RobertXii/860nm-Cateye-ECDL/PHYS335 Poster.pptx

Interference Filter External Cavity Diode Laser (ECDL) with a Cateye Configuration

Robert Xi¹, Geoffrey Zheng¹, Mangesh Bhattarai ², David DeMille¹, ²
1. James Franck Institute and Department of Physics, University of Chicago, IL 60637
2. Physics Division, Argonne National Laboratory, Argonne IL 640439

Goals and Motivation

ZOMBIES: Use ¹³⁷Ba¹⁹F to measure nuclear spin-dependent parity violation (NSD-PV) effect
Rotational Cooling (Pump population into single hyperfine level)
- Laser optically pumps ¹³⁷Ba¹⁹F molecules from X^2 Σ(υ=0;N^P =0^(+) ,1^(−) ,2^(+) ) to A^2 Π_(1/2) ( J^p =5/2^(+) ) , leaving X^2 Σ(υ=0;N^P =1^(−) ,J=3/2) hyperfine level unaddressed.
- Spontaneously decay back to ground state, accumulate population to X^2 Σ(υ=0;N^P =1^(−) ,J=3/2) .
- Simulation shows × 30 gain in the X^2 Σ(υ=0;N^P =1^(−) ,J=3/2) population.

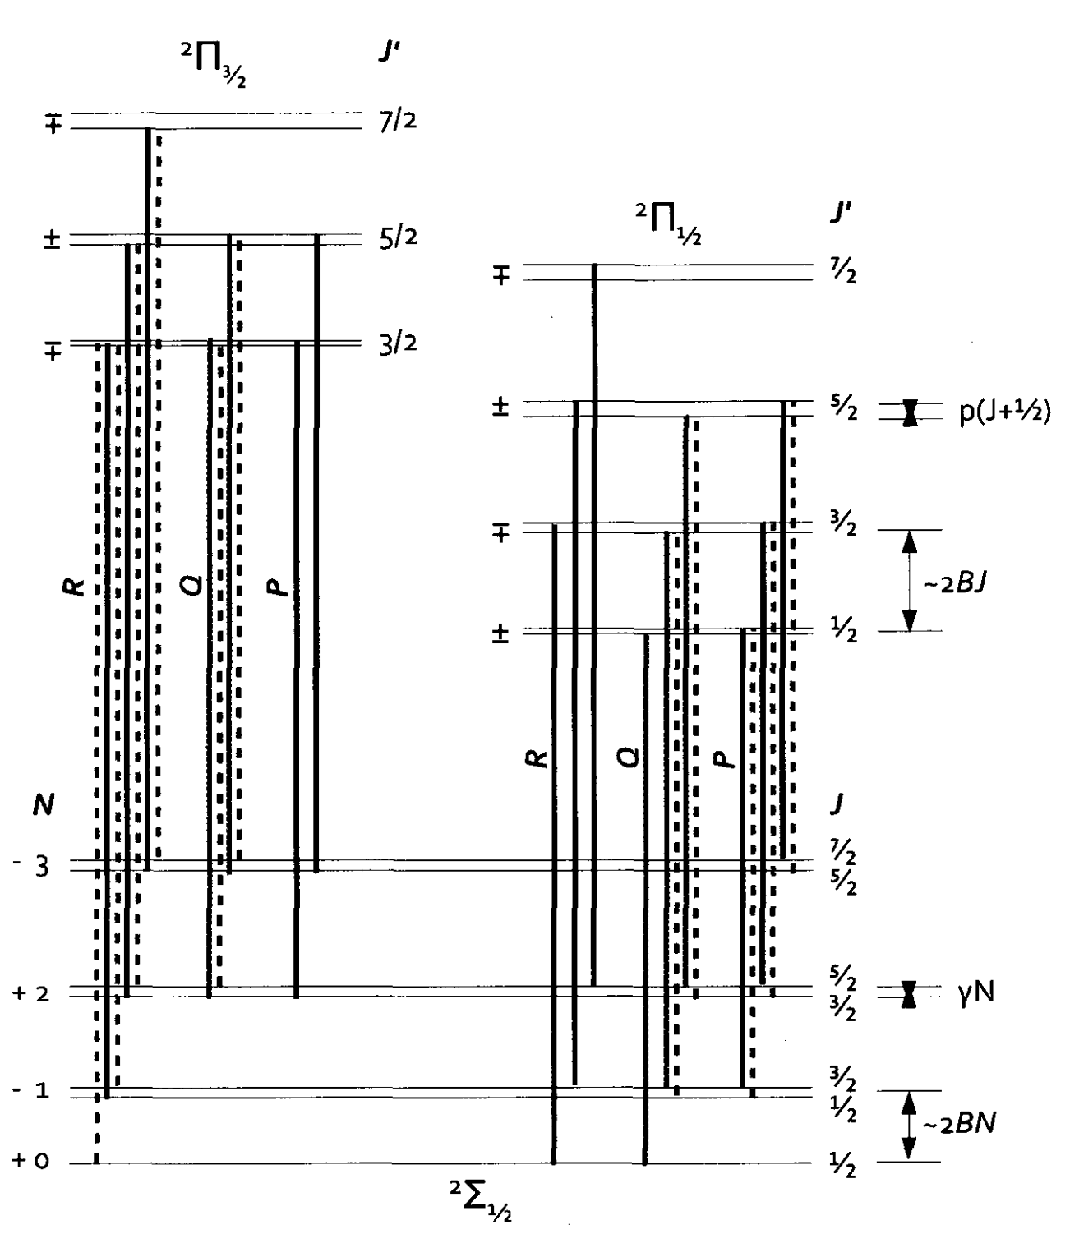
[picture p3: figure]

Laser Requirements
- Narrow linewidth (~100 kHz)
Similar Level of precision would mean measuring earth-moon distance with an uncertainty of 1mm!
- Wide tunability (~30GHz)
- High stability.
- Power output (~100mW)
- Ease of use, small size, reproducible.

The laser will oscillate at the frequency for which the product of these factors is greatest.

Design

Design Principles
- λ/2 waveplate + PBS allows tuning the feedback intensity
- Self-aligning Cateye reflection geometry, mechanically robust
- Frequency coarse tuning by changing diode temperature (100GHz)
- Moderate tuning by changing laser diode current (10GHz)
- Fine tuning by changing piezo voltage (<1GHz)

CAD
- Precise pitch and roll control of Cateye configuration allows finer tuning of alignment
- 1-inch-thick acrylic lid ensures system’s thermal stabilization
- Slotted PBS and λ/2 waveplate brass spacer allows adjustment of their position
- Brass base provides good thermal conductivity

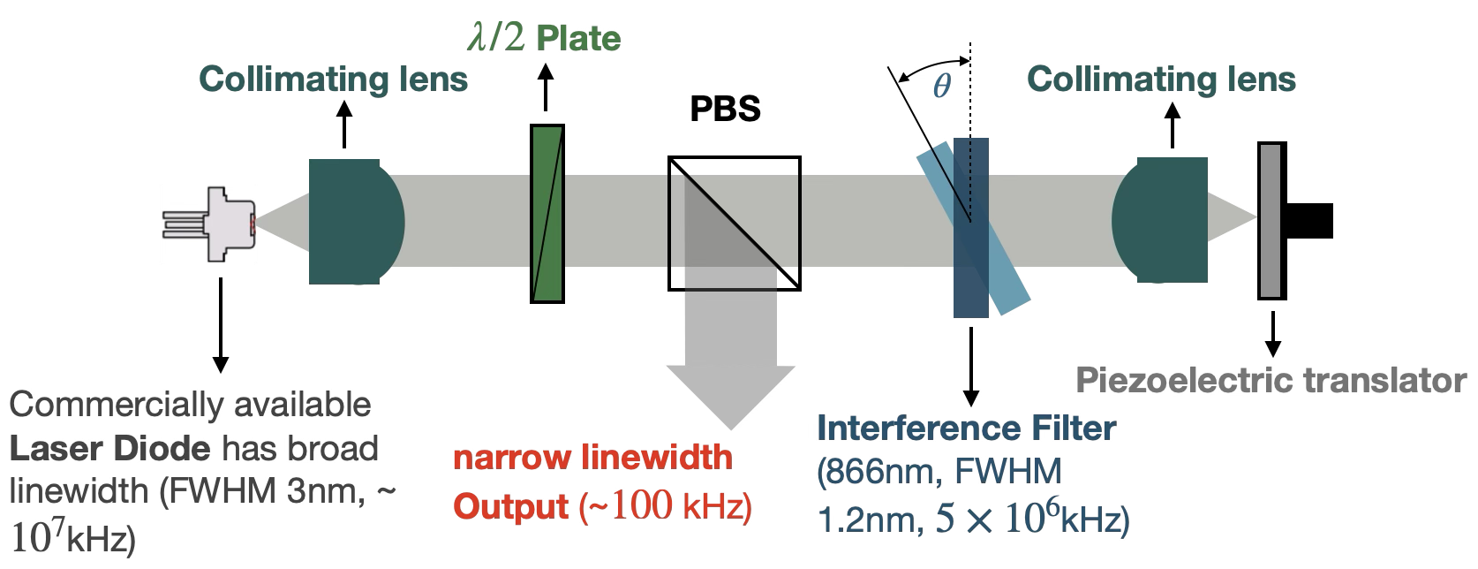
[picture p4: figure]
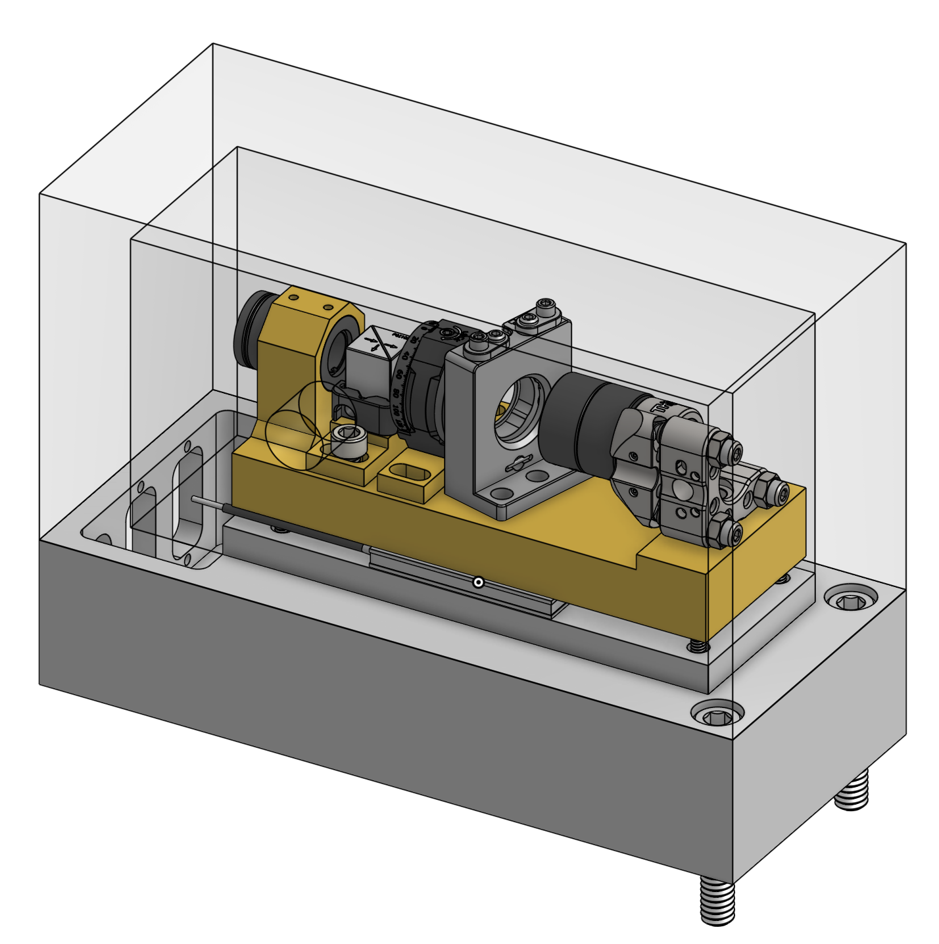
[picture p5: figure]
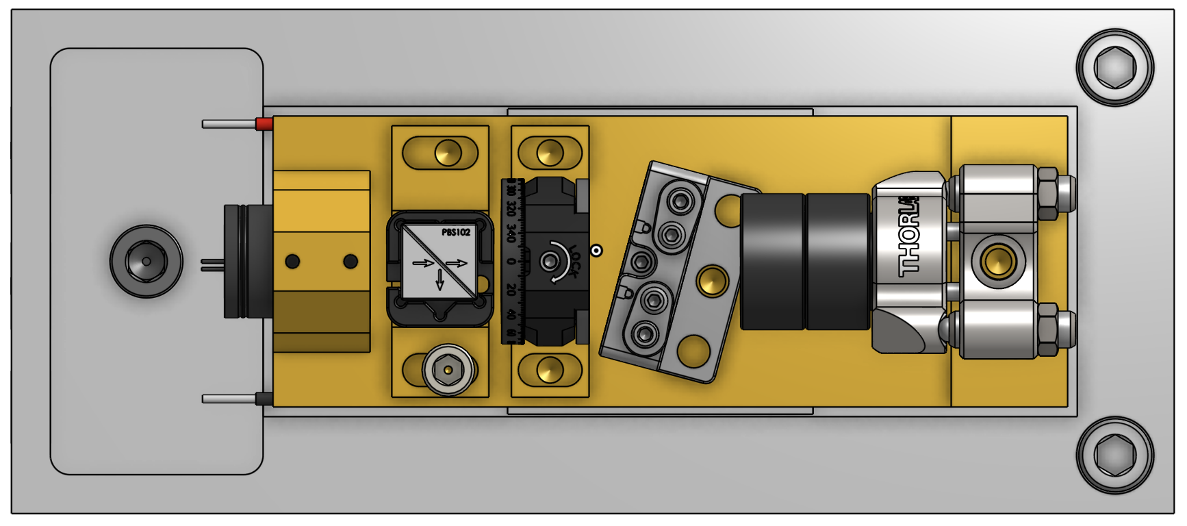
[picture p6: figure]
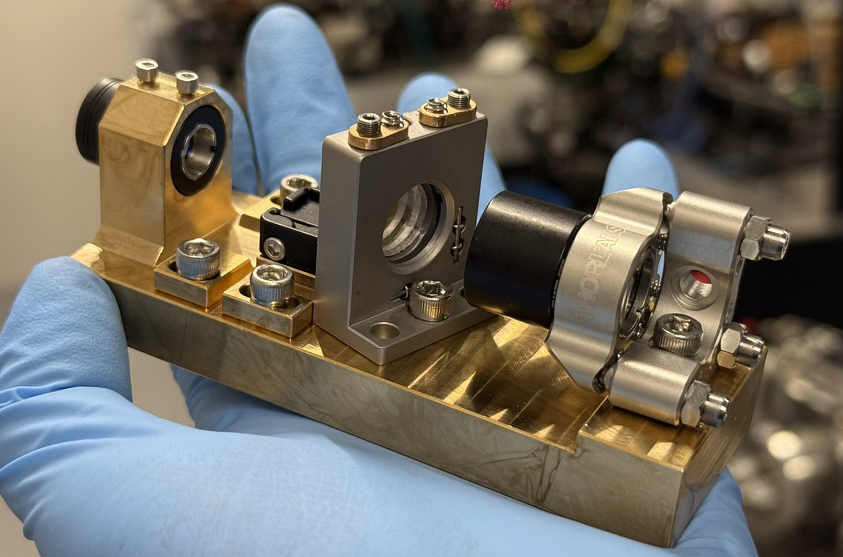
[picture p7: figure]

Theoretical Basis

An optical resonator consisting of two parallel, highly reflective mirrors that reflect light back and forth, forming standing waves at specific resonant frequencies.

where F is the coefficient of finesse for the cavity. δ(υ)=2πnLυ/c , L is the cavity length, and n is the refractive index of the cavity medium.

Fabry-Perot Cavity

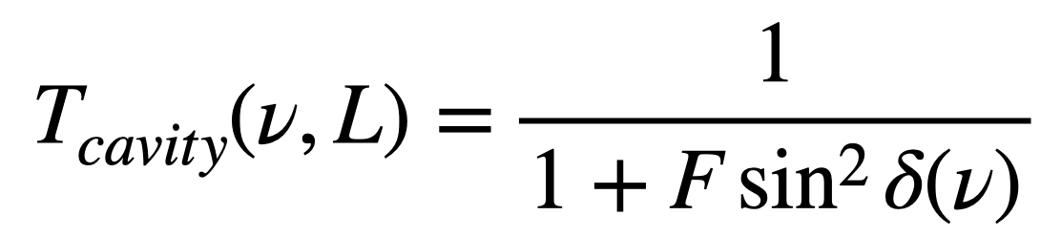
[picture p8: figure]
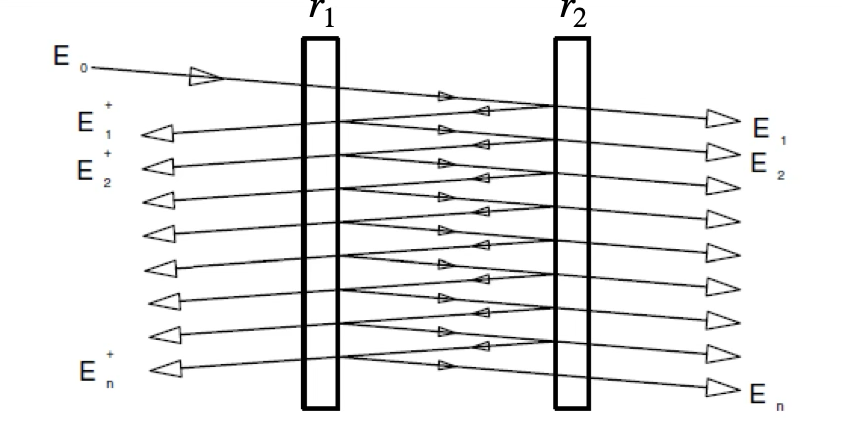
[picture p9: figure]
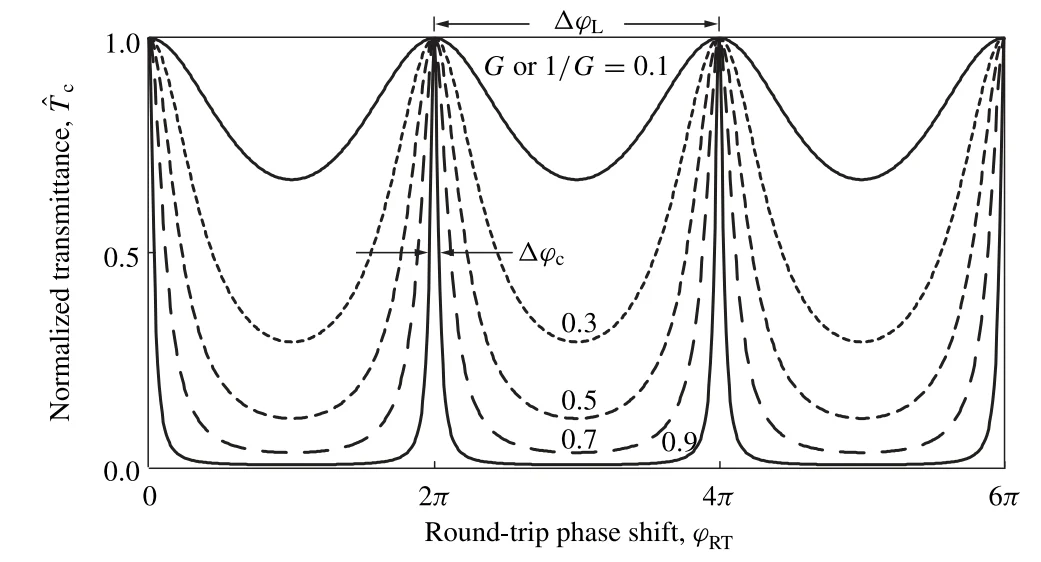
[picture p10: figure]

Ultra-narrow Bandpass Interference Filter

An optical filter that transmits light at specific wavelength (~1nm) using interference from multiple thin layers.
The transmission window wavelength
shift with incident angle θ :

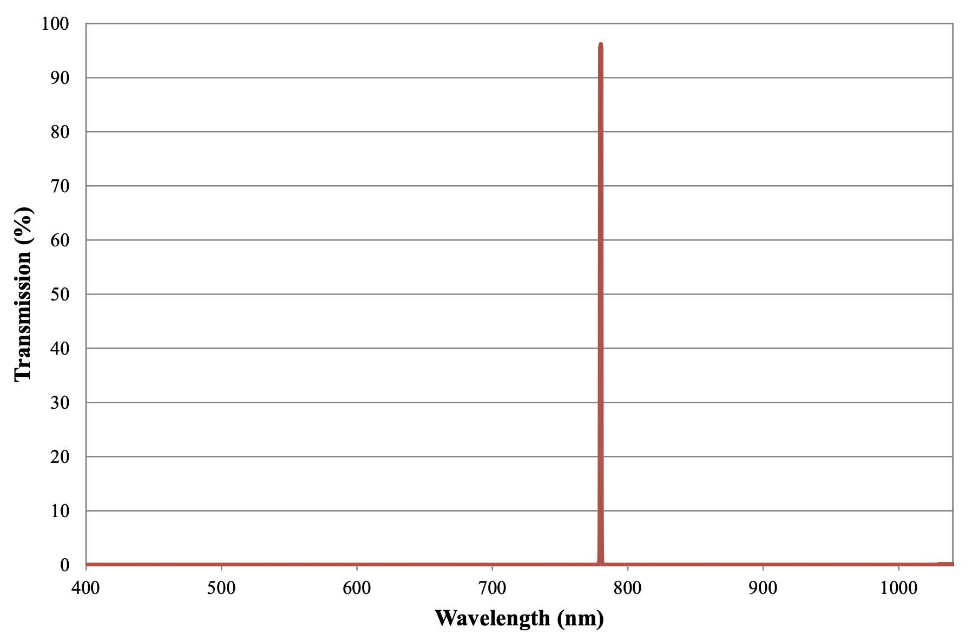
[picture p11: figure]
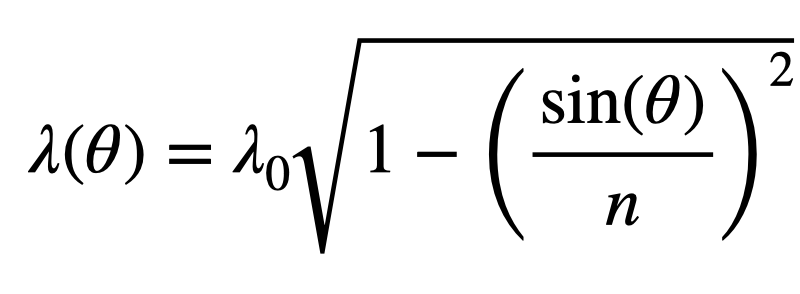
[picture p12: figure]

A lens-mirror combination (Cateye) and a lens-source aligned facing each other, with the mirror/light source at the focal plane/point of the lens.

Cateye Retroreflector

Reflects any incoming collimated beam back to the source, regardless of their relative angle (provided the beam strikes the Cateye).

Advantages:
- Easy to align
- Mechanically stable

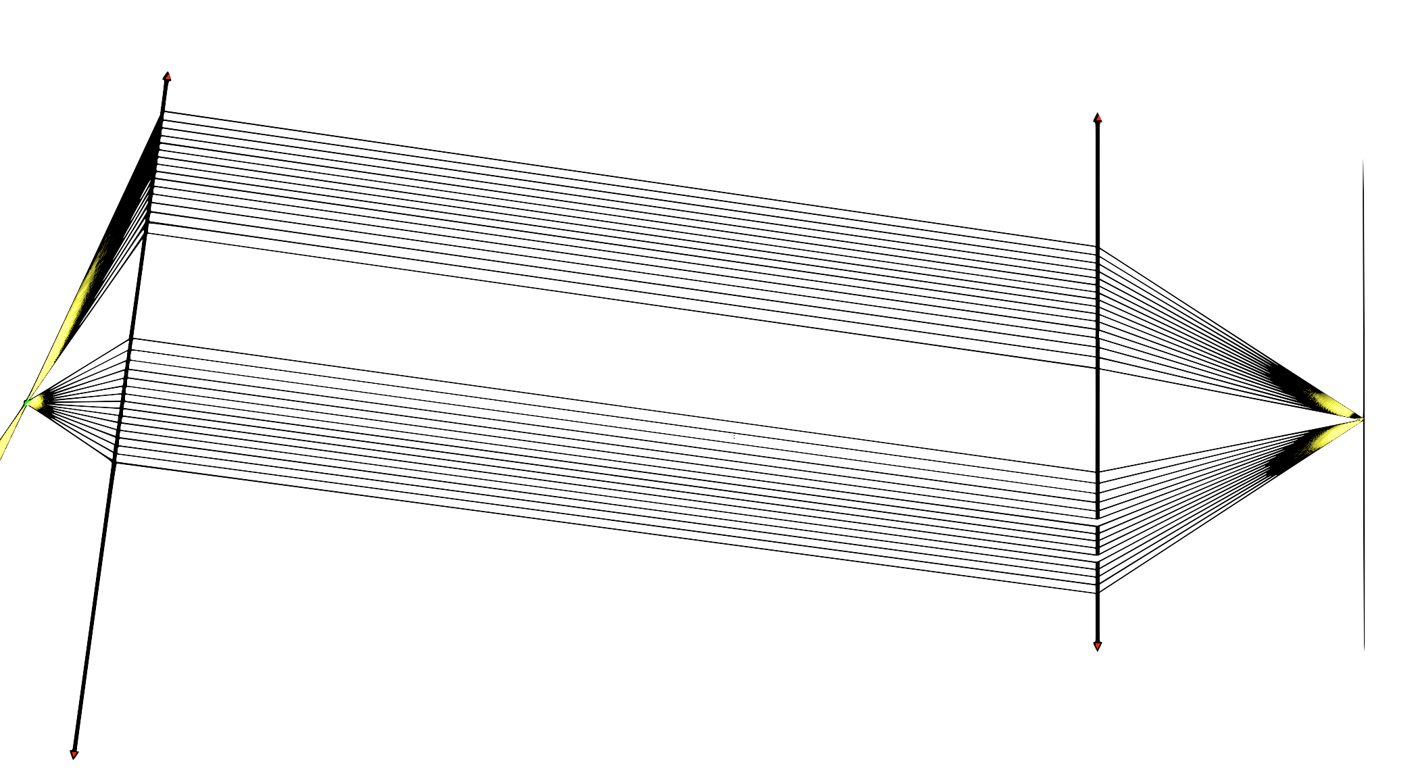
[picture p13: figure]

Laser Output Frequency

The output frequency ν of an ECDL dependents on a combination of frequency-dependent gain and loss factors. The product of these factors gives the total transmission function:

Result

Diode Current Scan, Piezo Voltage Scan, and Feedforward
- Without feedforward (scanning current and voltage simultaneously at certain ratio), scanning current gives discrete steps, scanning voltage gives ~1.5GHz MHFTR, consistent with simulation
- With feedforward, MHFTR ~12GHz

Outlook

Transfer Cavity for frequency stabilization and frequency shifting laser

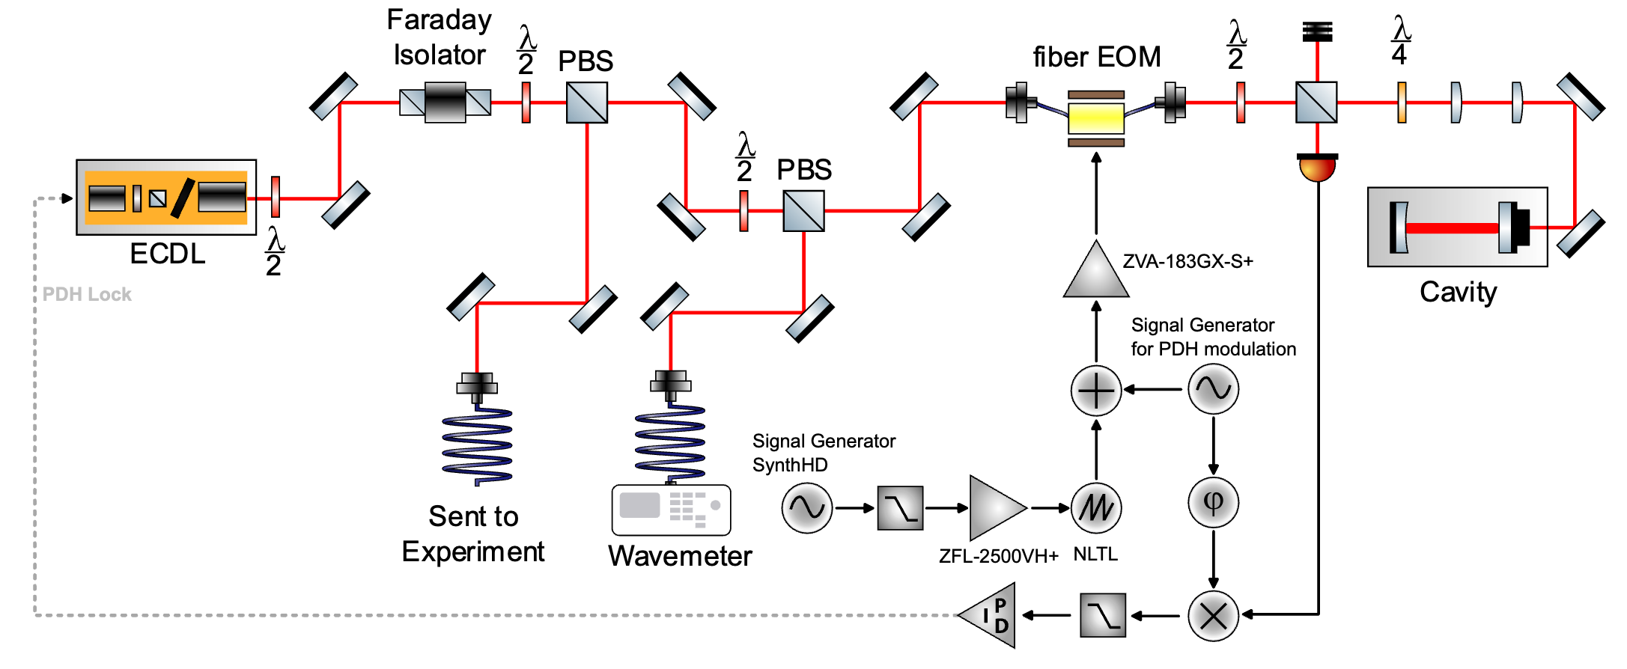
[picture p14: figure]
