RobertXii/860nm-Cateye-ECDL/ECDL Poster.pdf

# Interference Filter External Cavity Diode Laser (ECDL) with a Cateye Configuration

## Goals and Motivation

## Design

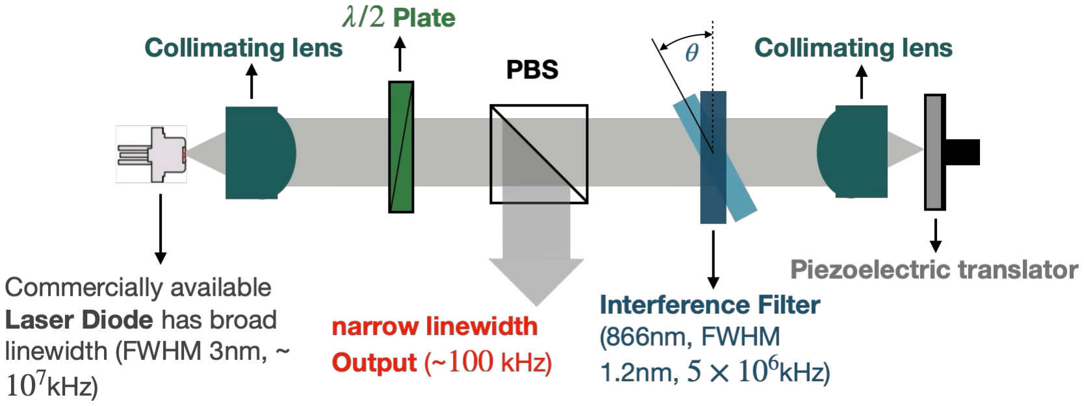
[picture p15: figure]

## Theoretical Basis

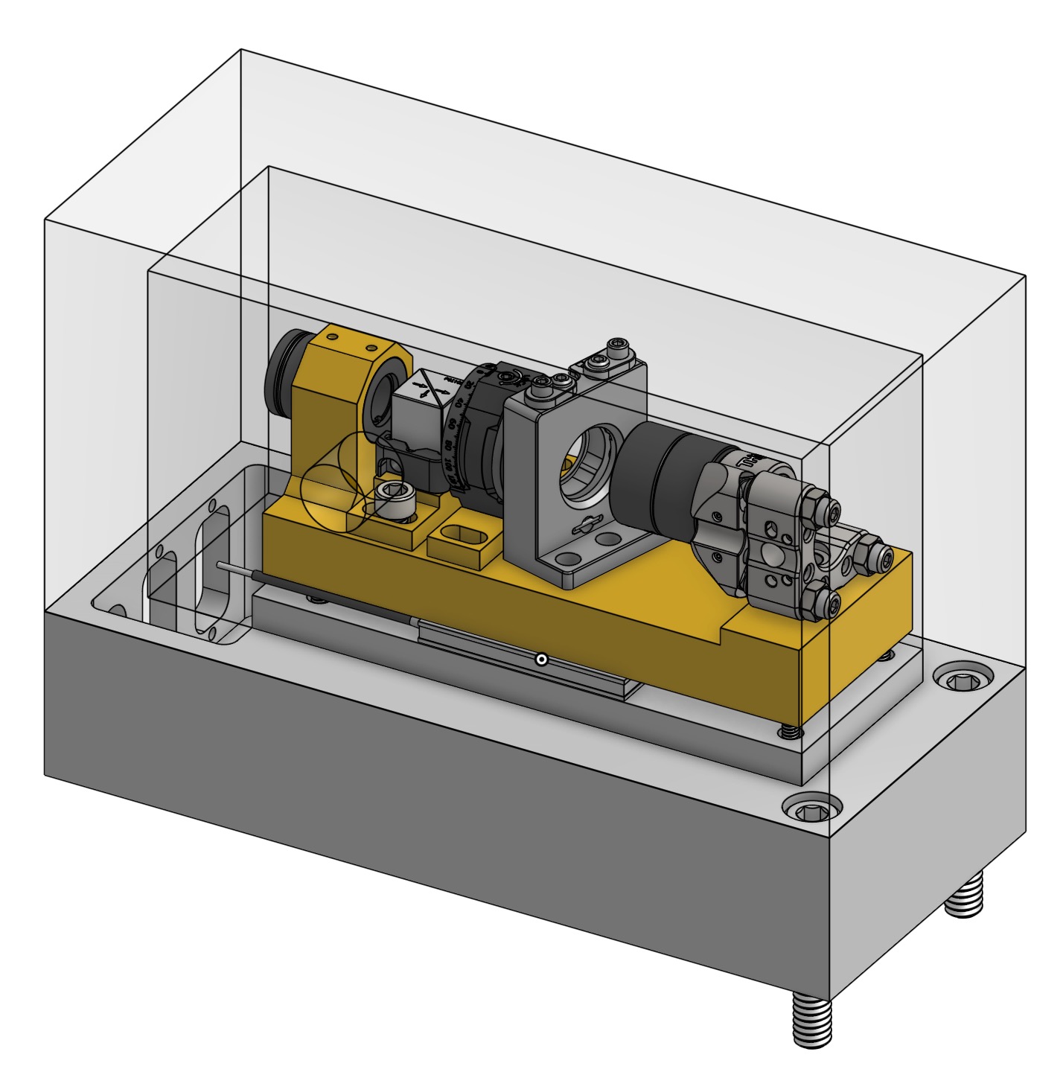
[picture p16: figure]
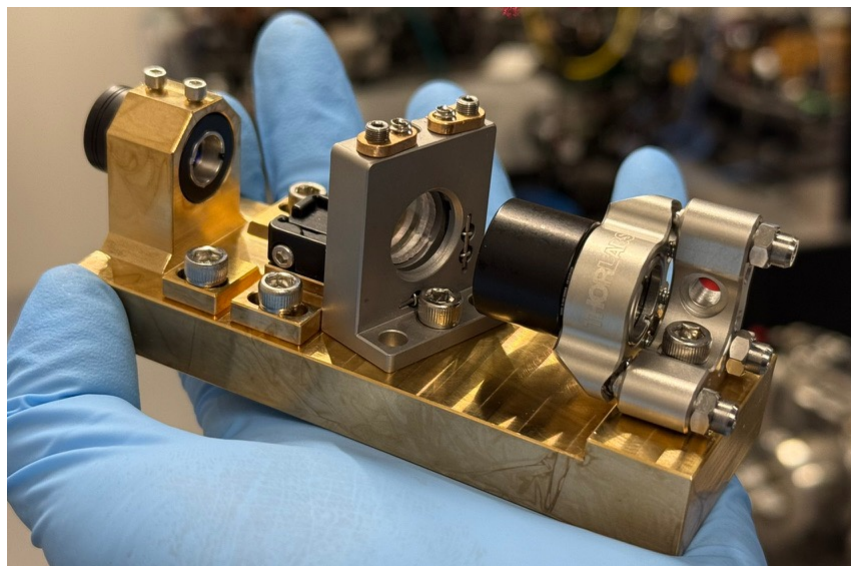
[picture p17: figure]
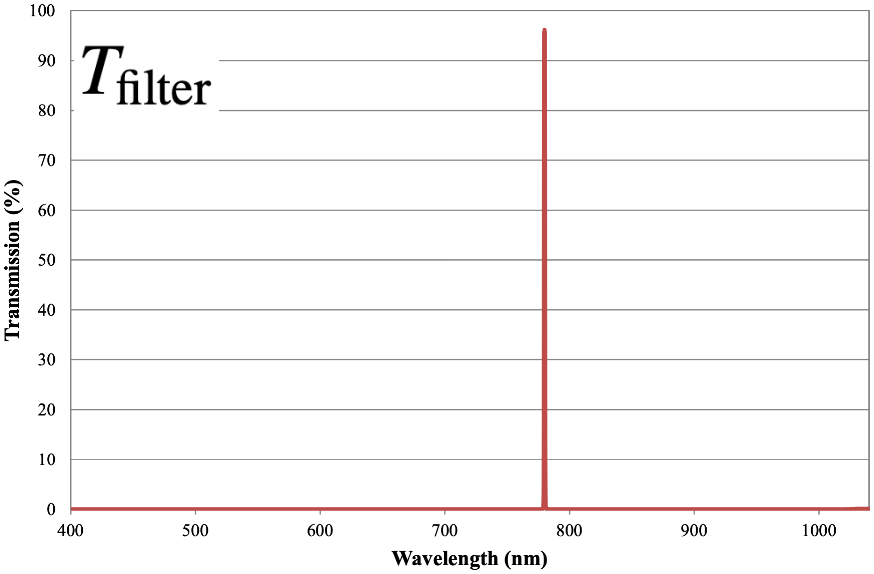
[picture p18: figure]

## Result

Robert Xi¹, Geoffrey Zheng¹, Mangesh Bhattarai ², David DeMille¹, 2
1. James Franck Institute and Department of Physics, University of Chicago, IL 60637
2. Physics Division, Argonne National Laboratory, Argonne IL 640439

## ZOMBIES: Use ¹³⁷Ba¹⁹F to measure nuclear spin-dependent parity violation (NSD-PV) effect

Rotational Cooling (Pump population into single hyperfine level)
- Laser optically pumps ¹³⁷Ba¹⁹F molecules from X!Σ(υ = 0; N" = 0#

, 1$, 2#) to A!Π%/!( J' = 5/2#), leaving X!Σ(υ = 0; N" = 1$,J = 3/2) hyperfine level unaddressed.
- Spontaneously decay back to ground state, accumulate population to X!Σ(υ = 0; N" = 1$,J = 3/2).
- Simulation shows ×30 gain in the X!Σ(υ = 0; N" = 1$,J = 3/
2) population.

Laser Requirements
- Narrow linewidth (~100 kHz)
Similar Level of precision would mean measuring earth-moon
distance with an uncertainty of 1mm!
- Wide tunability (~30GHz)
- High stability.
- Power output (~100mW)
- Ease of use, small size, reproducible.

## Fabry-Perot Cavity

An optical resonator consisting of two parallel, highly reflective mirrors that reflect light back and forth, forming standing waves at specific resonant frequencies.

where F is the coefficient of finesse for the cavity. δ υ = 2πnLυ/c, L is the cavity length, and n is the refractive index of the cavity medium.

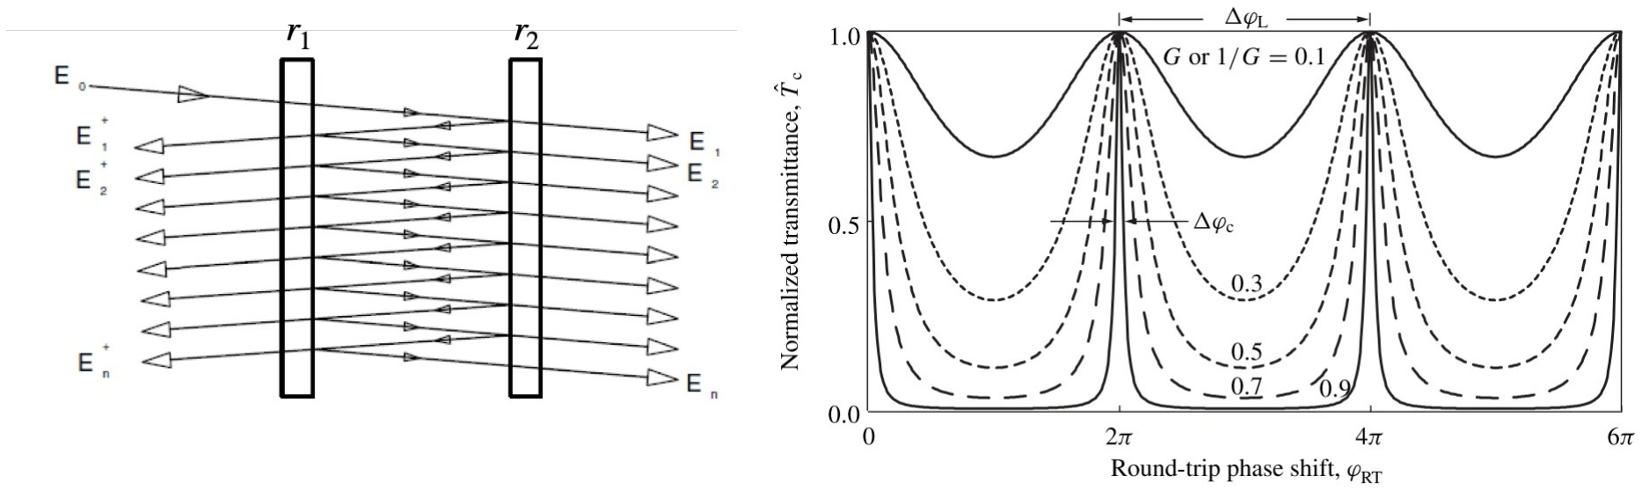
[picture p19: figure]
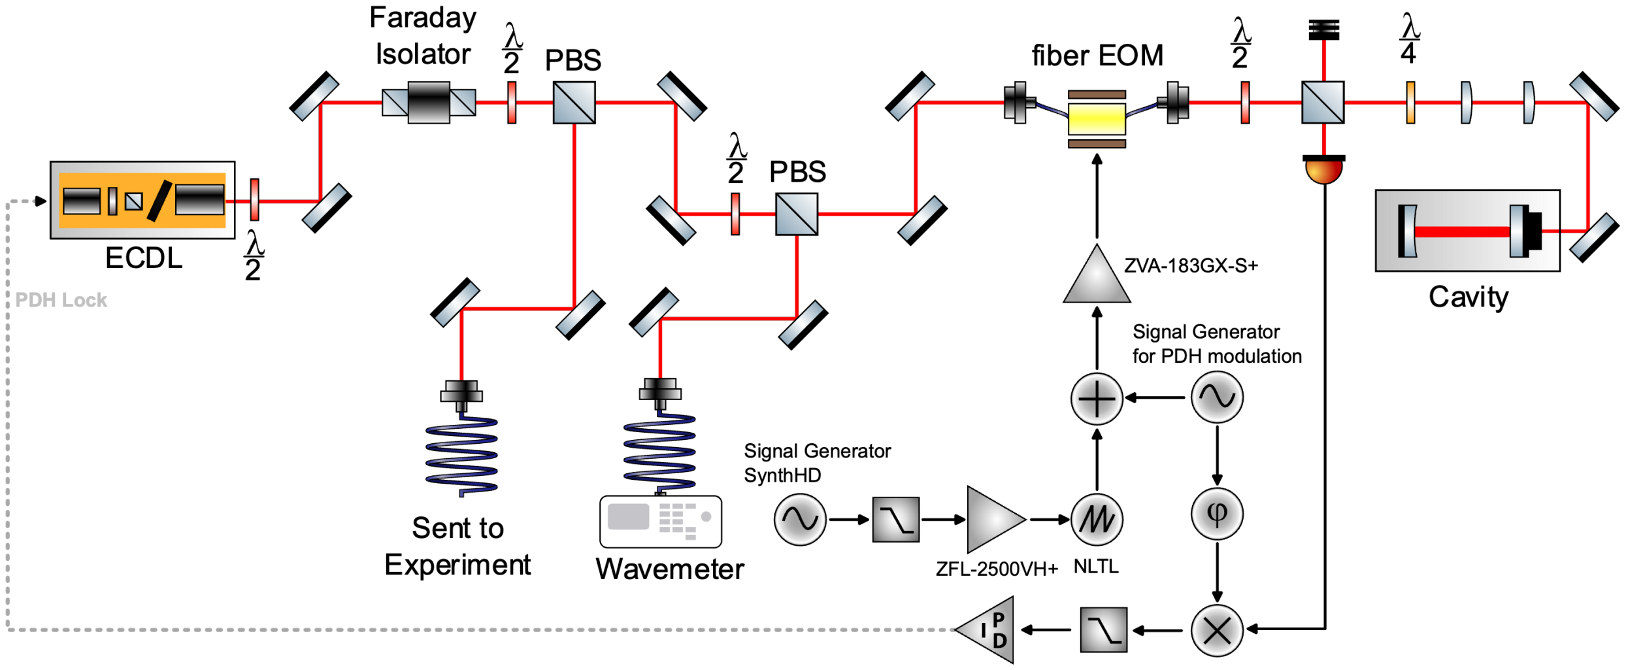
[picture p20: figure]

## Laser Output Frequency

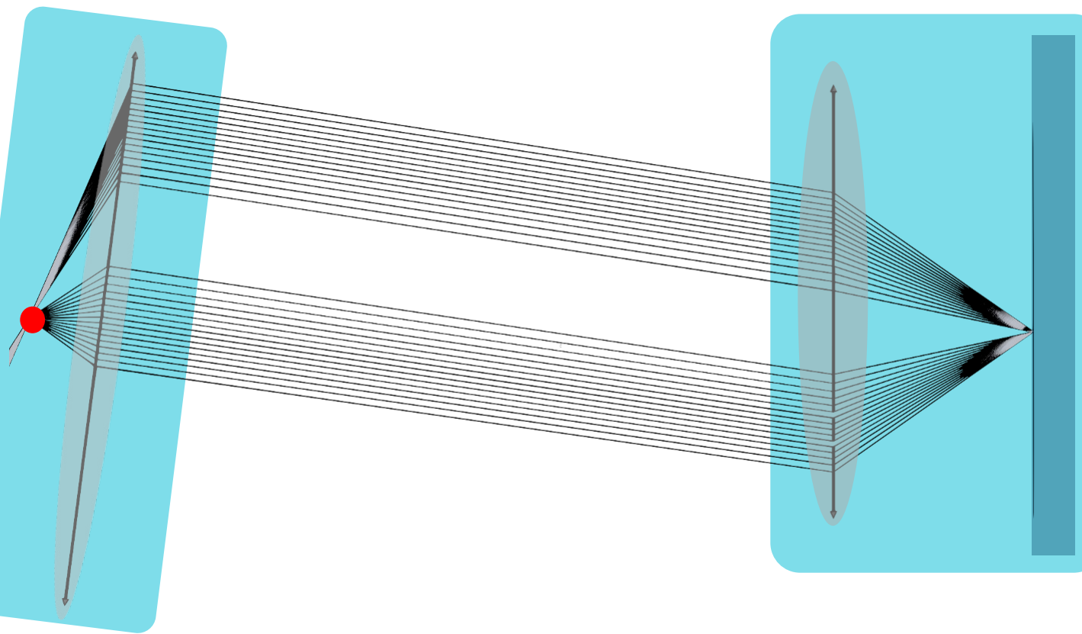
[picture p21: figure]

The output frequency ν of an ECDL dependents on a combination of frequency-dependent gain and loss factors. The product of these factors gives the total transmission function:

## Ultra-narrow Bandpass Interference Filter

An optical filter that transmits light at specific wavelength (~1nm) using interference from multiple thin layers.

The transmission window wavelength
shift with incident angle θ:

Design Principles
- λ/2 waveplate + PBS allows tuning the feedback intensity
- Self-aligning Cateye reflection geometry, mechanically robust
- Frequency coarse tuning by changing diode temperature (100GHz)
- Moderate tuning by changing laser diode current (10GHz)
- Fine tuning by changing piezo voltage (<1GHz)

CAD
- Precise pitch and roll control of Cateye configuration allows finer tuning of alignment
- 1-inch-thick acrylic lid ensures system’s thermal stabilization
- Slotted PBS and λ/2 waveplate brass spacer allows adjustment of their position
- Brass base provides good thermal conductivity

The laser will oscillate at the frequency for which the product of these factors is greatest.

350.5 | 350 | 349.5 | 349 | 348.5 | 348 | 347.5 | 347
Frequency (THz)

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
Transmission

Total Transmission
maximum
Gain Profile
Filter Transmission
Diode Cavity Transmission
348.95 | 348.9 | 348.85 | 348.8 | 348.75 | 348.7 | 348.65 | 348.6 | 348.55 | 348.5
Frequency (THz)

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
Transmission

859.71000 nm
348.71347 THz Total Transmission maximum
Gain Profile
Filter Transmission
Diode Cavity Transmission

Diode Current Scan, Piezo Voltage Scan, and Feedforward
- Without feedforward (scanning current and voltage simultaneously at certain ratio), scanning current gives discrete steps, scanning voltage gives ~1.5GHz MHFTR, consistent with simulation
- With feedforward, MHFTR ~12GHz

## Outlook

Transfer Cavity for frequency stabilization and frequency shifting laser

## Cateye Retroreflector

A lens-mirror combination (Cateye) and a lens-source aligned facing each other, with the mirror/light source at the focal plane/point of the lens.

Advantages:
- Easy to align
- Mechanically stable

Reflects any incoming collimated beam back to the source,
regardless of their relative angle (provided the beam strikes the Cateye).
