RobertXii/860nm-Cateye-ECDL/Circuits/Feedforward Circuit/Feedforward Circuit Diagram.pdf

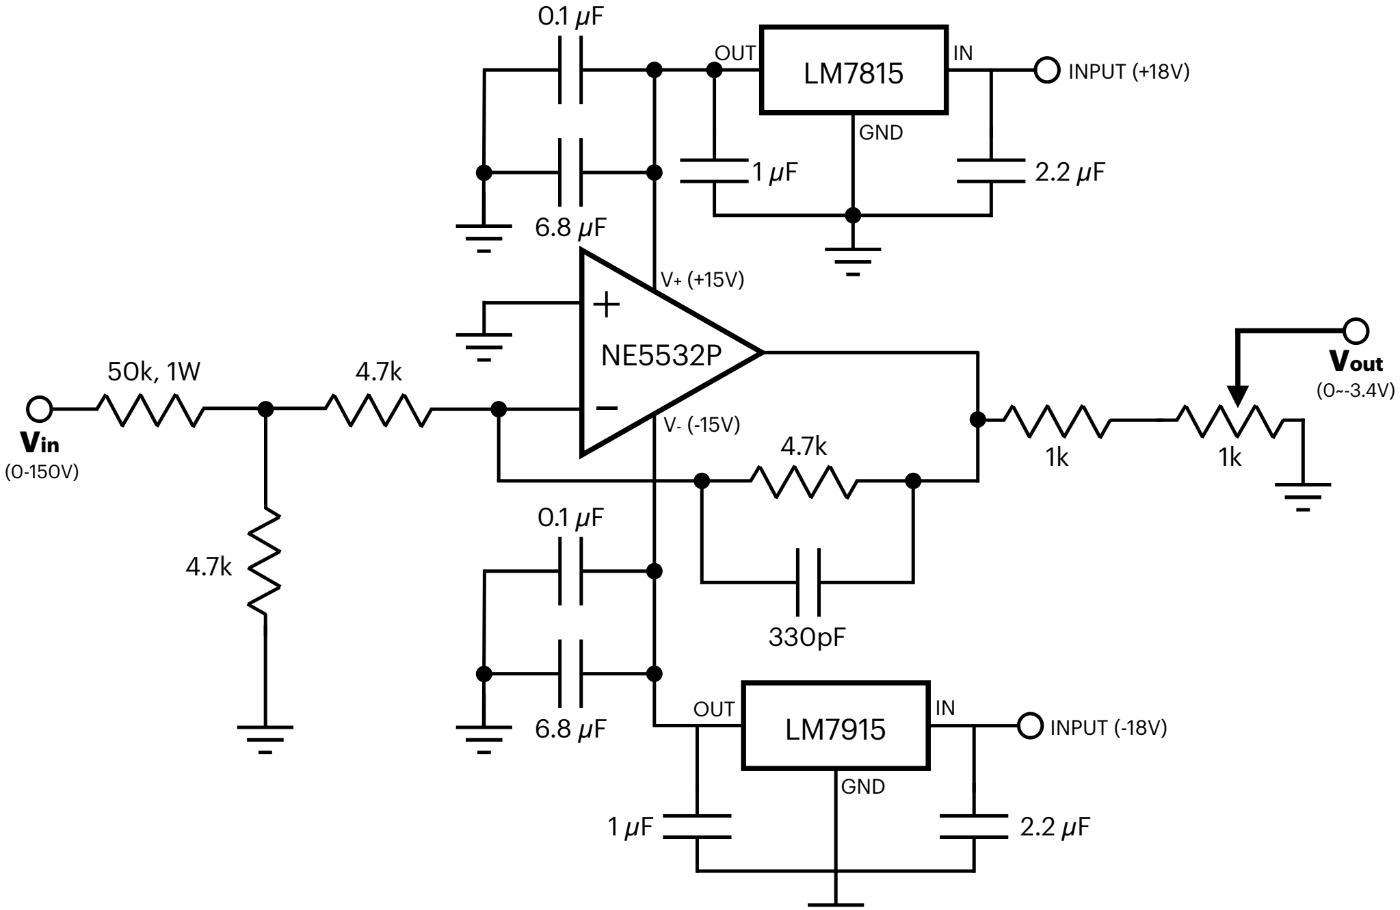
[picture p22: figure]
GND; OUT; INPUT (+18V); INPUT (-18V); Vin; Vout
