RobertXii/860nm-Cateye-ECDL/Circuits/original_diode_protection_circuit_bode_plot.pdf

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

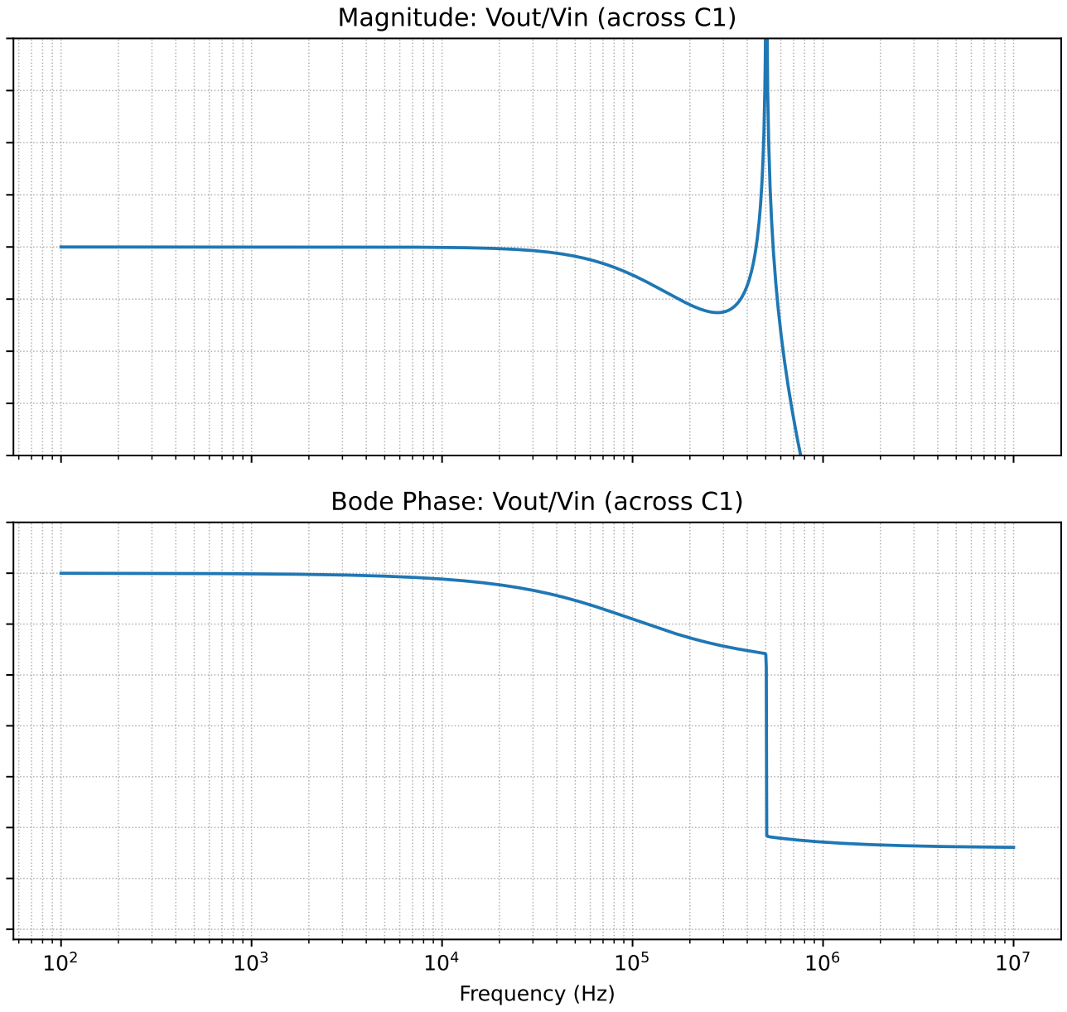
[picture p23: figure]
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
