RobertXii/860nm-Cateye-ECDL/CAD/New ECDL Design/IMG_3966.jpeg

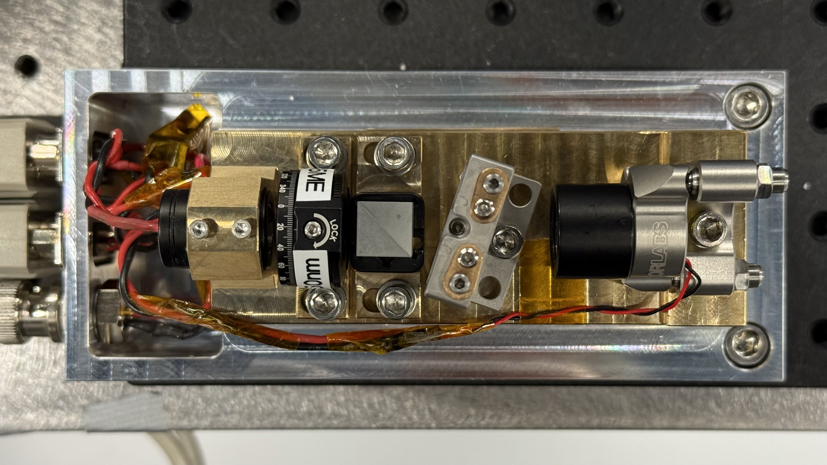
CAD/New ECDL Design/IMG_3966.jpeg
