RobertXii/860nm-Cateye-ECDL/CAD/New ECDL Design/Screenshot 2025-03-17 at 7.20.56 PM.png

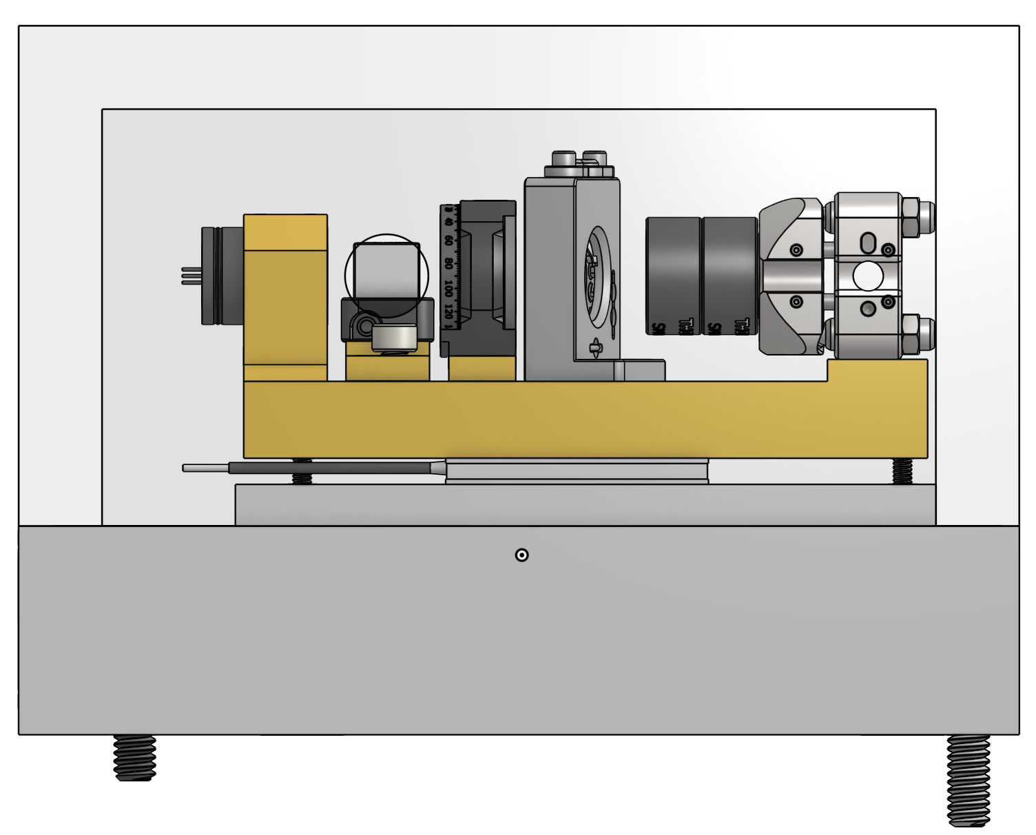
CAD/New ECDL Design/Screenshot 2025-03-17 at 7.20.56 PM.png
