RobertXii/860nm-Cateye-ECDL/CAD/New ECDL Design/Screenshot 2025-03-17 at 7.23.22 PM.png

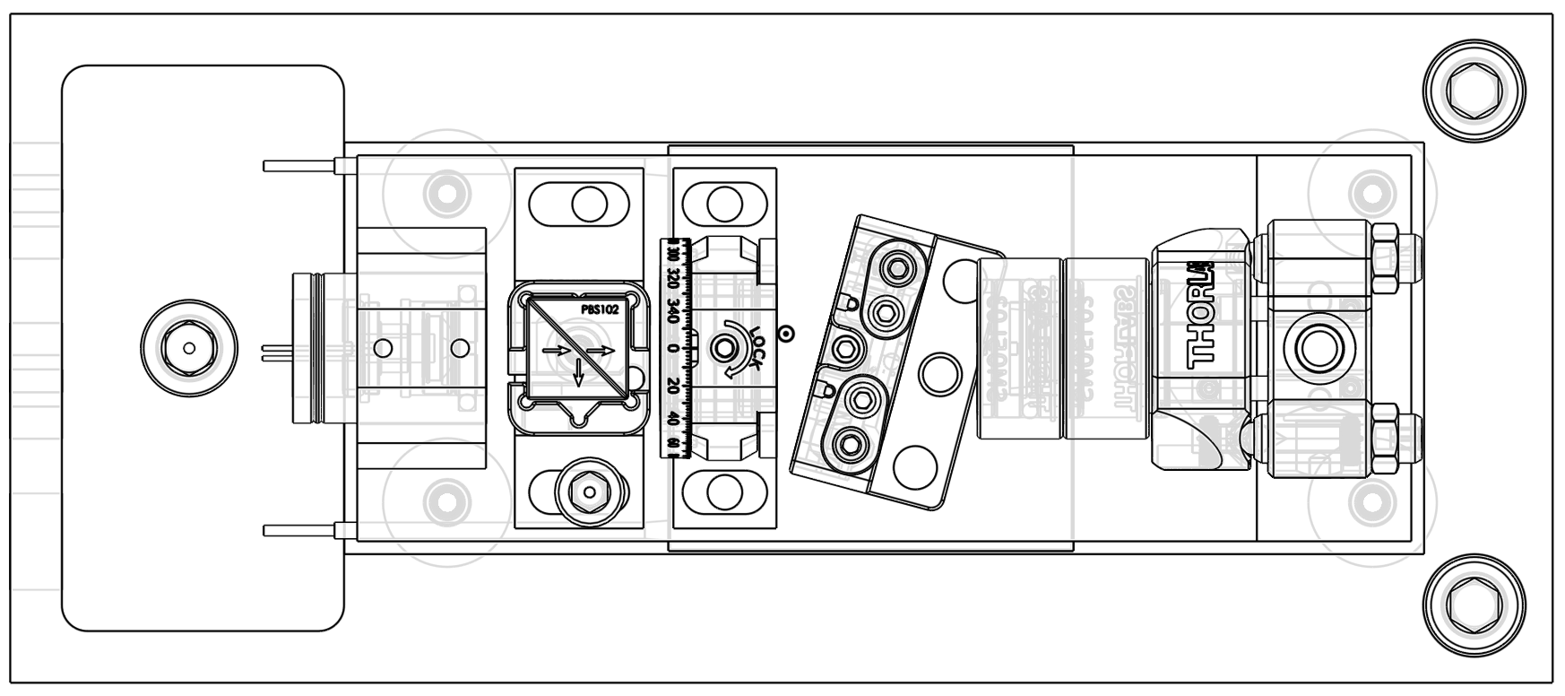
CAD/New ECDL Design/Screenshot 2025-03-17 at 7.23.22 PM.png
