RobertXii/860nm-Cateye-ECDL/Circuits/Feedforward Circuit/IMG_4039.jpeg

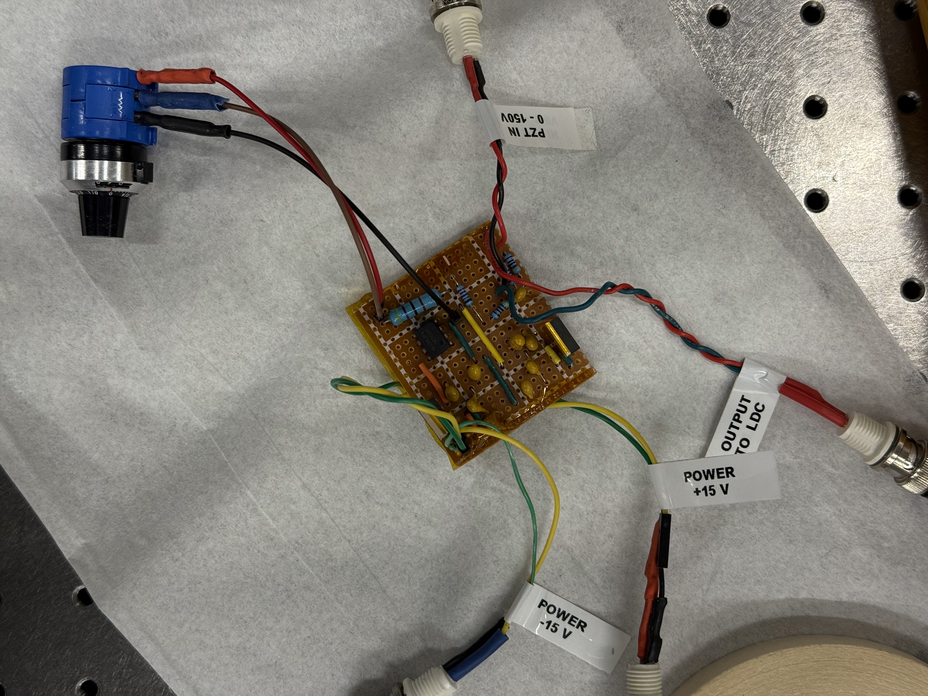
Circuits/Feedforward Circuit/IMG_4039.jpeg
