RobertXii/860nm-Cateye-ECDL/Circuits/Feedforward Circuit/IMG_4040.jpeg

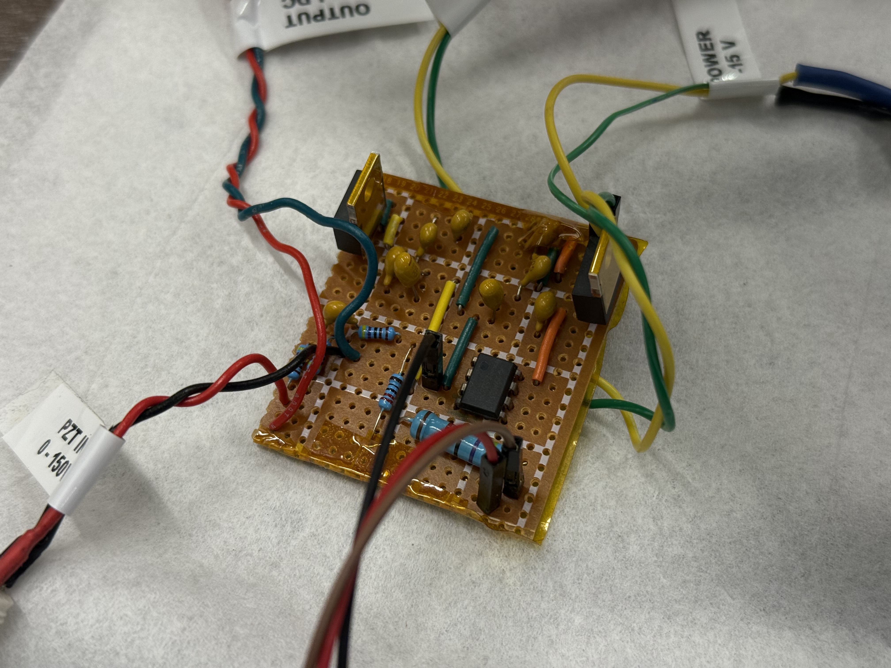
Circuits/Feedforward Circuit/IMG_4040.jpeg
