RobertXii/860nm-Cateye-ECDL/Circuits/Feedforward Circuit/IMG_4096.jpeg

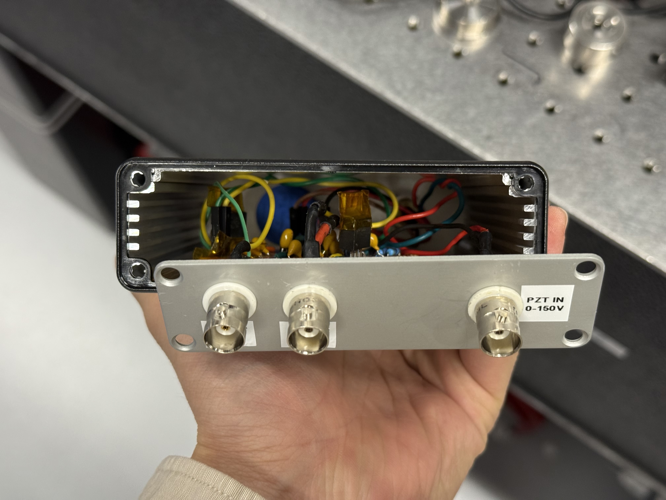
Circuits/Feedforward Circuit/IMG_4096.jpeg
