RobertXii/860nm-Cateye-ECDL/Circuits/Piezo Protection Circuit/Piezo Protection Circuit Diagram new.png

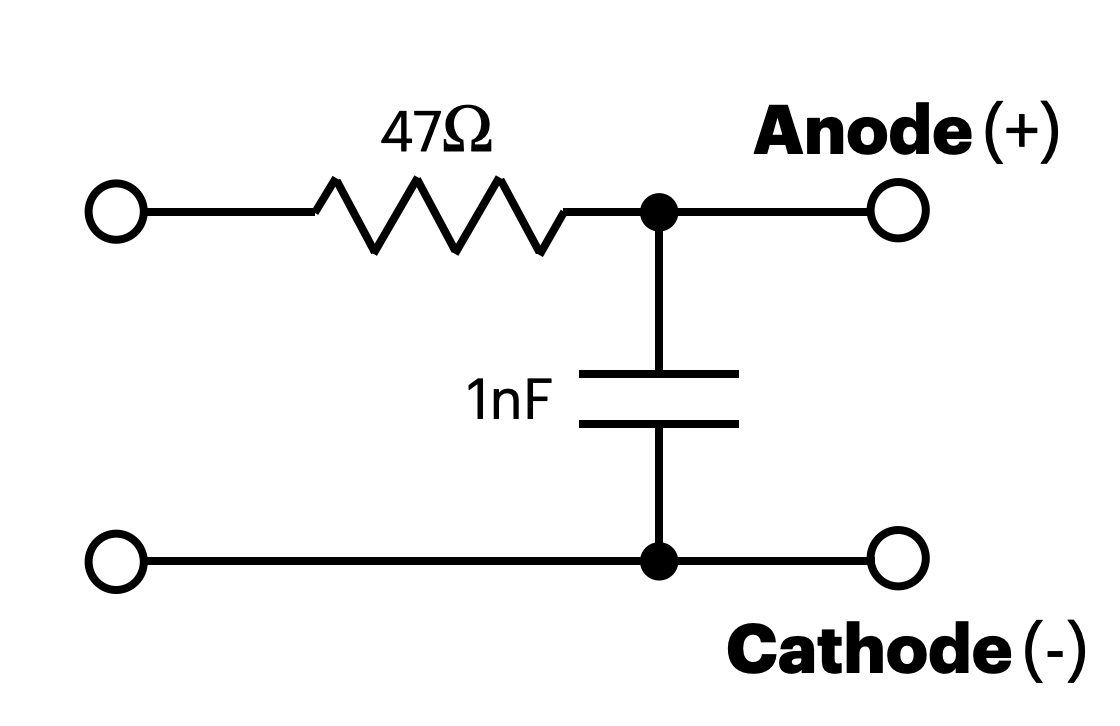
Circuits/Piezo Protection Circuit/Piezo Protection Circuit Diagram new.png
