RobertXii/860nm-Cateye-ECDL/Circuits/Piezo Protection Circuit/Piezo Protection Circuit Diagram.png

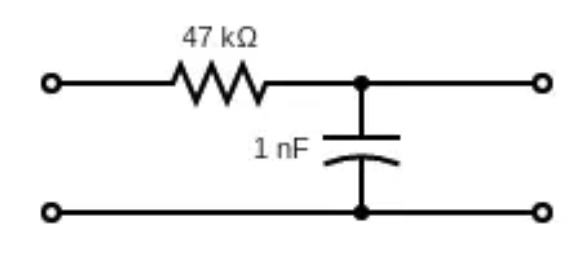
Circuits/Piezo Protection Circuit/Piezo Protection Circuit Diagram.png
