RobertXii/860nm-Cateye-ECDL/Circuits/Piezo Protection Circuit/Piezo Protection Circuit.jpeg

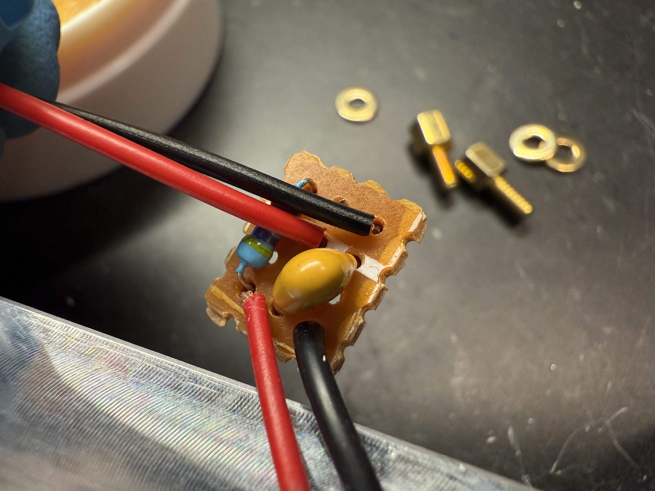
Circuits/Piezo Protection Circuit/Piezo Protection Circuit.jpeg
