RobertXii/860nm-Cateye-ECDL/export.png

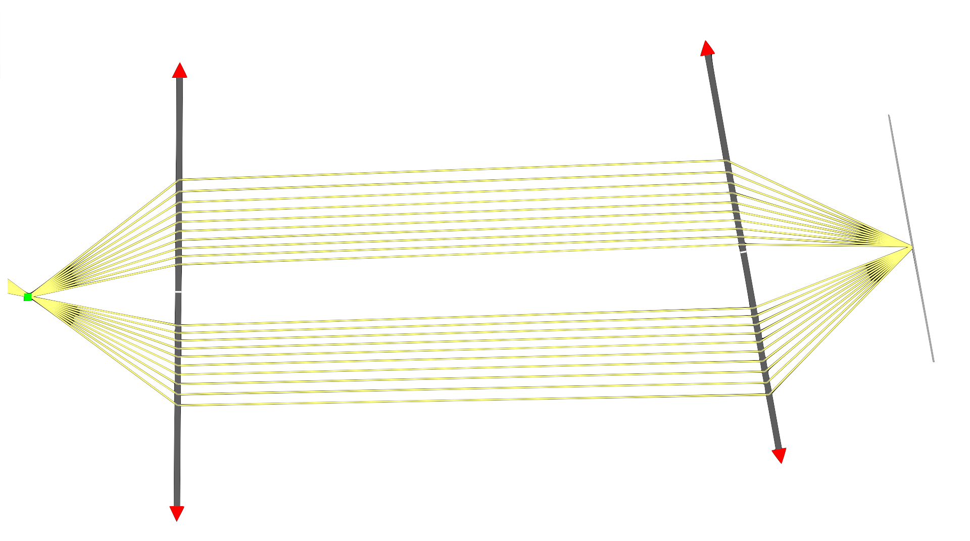
export.png
