RobertXii/860nm-Cateye-ECDL/CAD/From Michelle/figure2.SLDASM

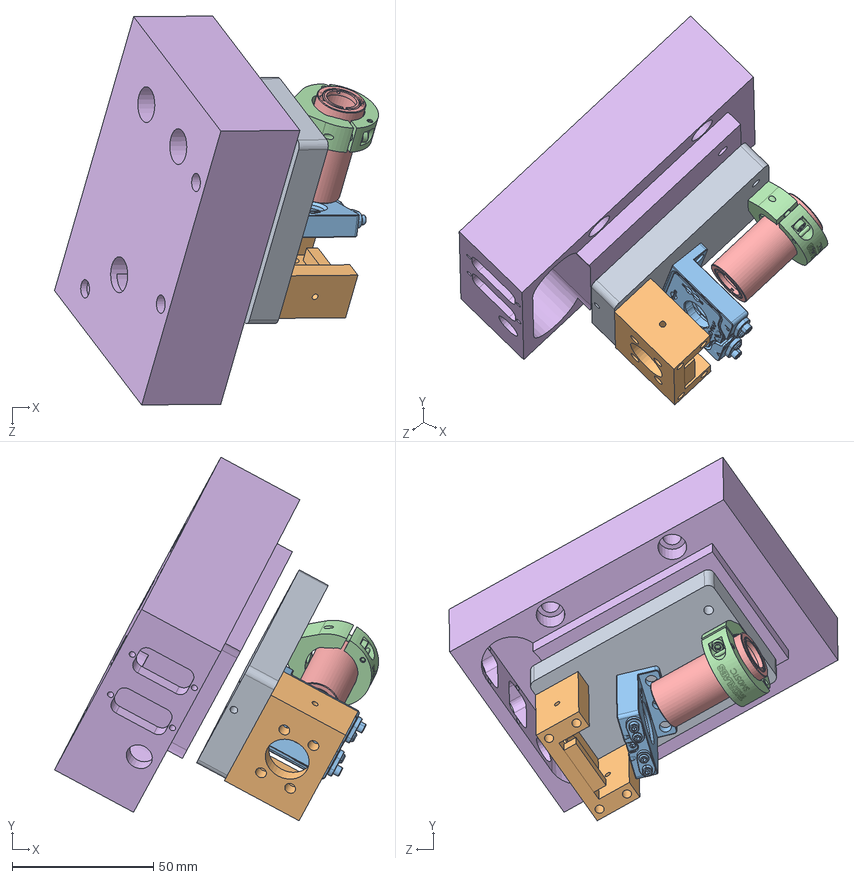
[picture p35: CAD file, 2025-04-15]
CAD/From Michelle/figure2.SLDASM
114.6 x 128.6 x 137.6 mm
diode base
Fixed Diode Housing Holder
Newport-hvm-05r
SM05TC-Solidworks
SM05M15-Solidworks
Laser Base
