RobertXii/860nm-Cateye-ECDL/CAD/From Michelle/diode base.STEP

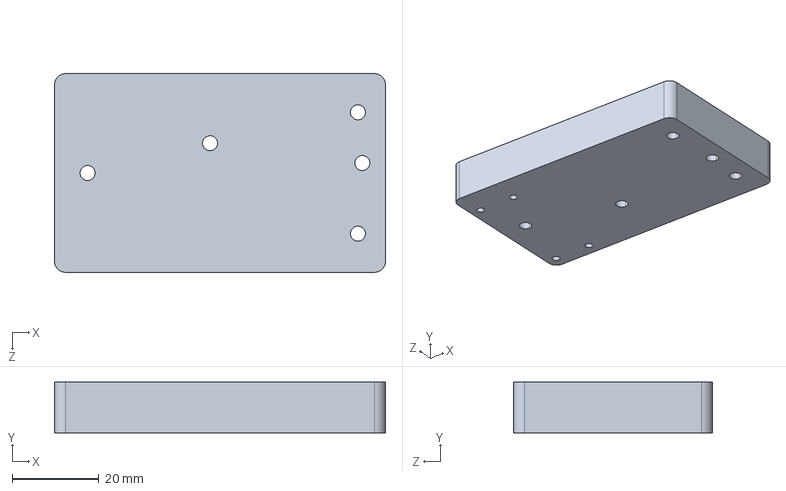
[picture p36: CAD file, 2025-04-15]
CAD/From Michelle/diode base.STEP
76.2 x 11.7 x 45.7 mm
