RobertXii/860nm-Cateye-ECDL/CAD/New ECDL Design/Brass base.step

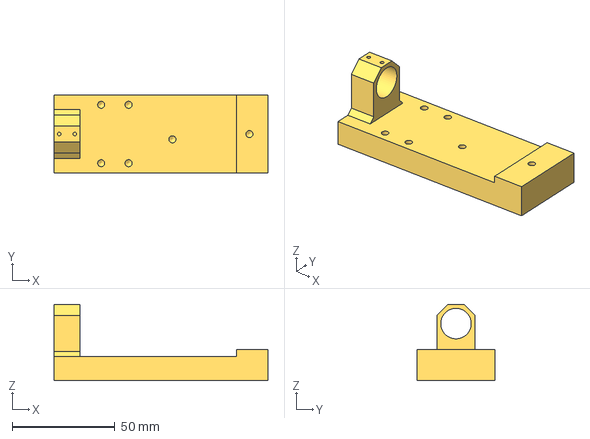
[picture p37: CAD file, 2025-05-07]
CAD/New ECDL Design/Brass base.step
104.1 x 38.1 x 37.1 mm
