RobertXii/860nm-Cateye-ECDL/CAD/parts/SM05L05-Step.step

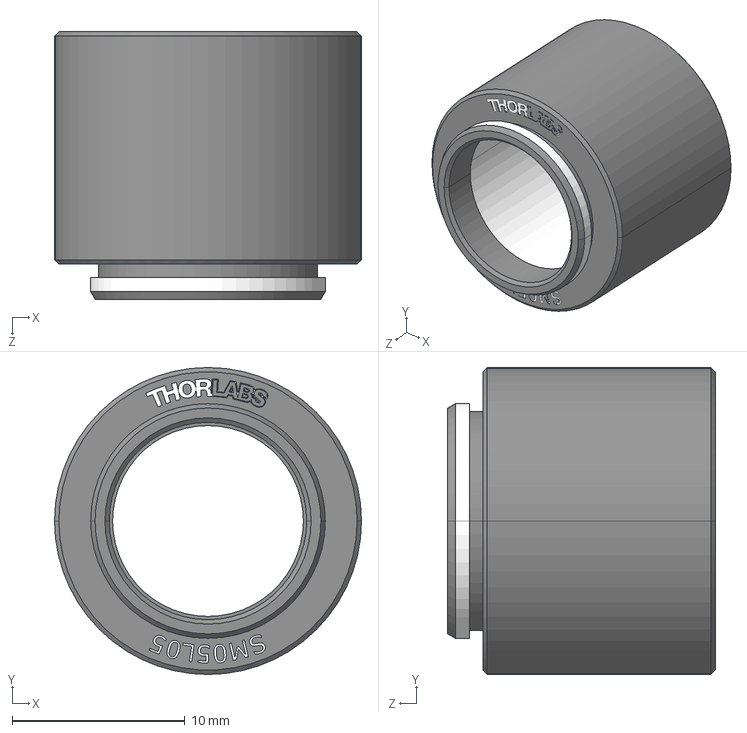
[picture p38: CAD file, 2025-04-15]
CAD/parts/SM05L05-Step.step
17.8 x 17.8 x 15.5 mm
