RobertXii/860nm-Cateye-ECDL/Waterjet/Feedforward Electronic Box/Robert 1cm Circle.dxf

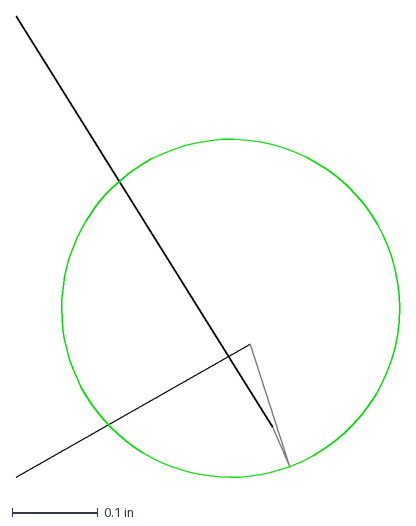
[picture p39: CAD file, 2025-04-23]
Waterjet/Feedforward Electronic Box/Robert 1cm Circle.dxf
0.447 x 0.548 in
