RobertXii/860nm-Cateye-ECDL/Waterjet/Water Jet ECDL Lid.dxf

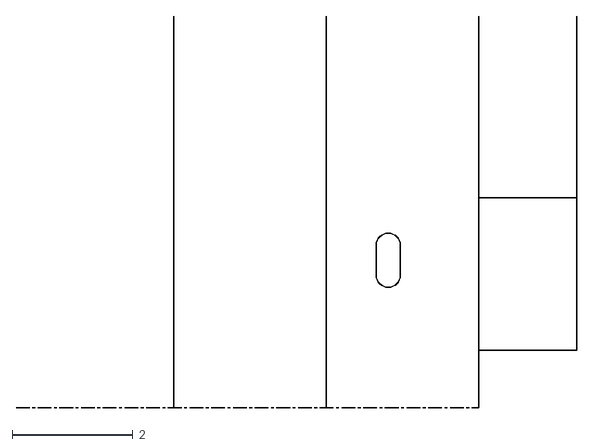
[picture p40: CAD file, 2025-04-15]
Waterjet/Water Jet ECDL Lid.dxf
9.31 x 6.50
