RobertXii/860nm-Cateye-ECDL/CAD/From Michelle/MHV-12.7L-F_STP.STEP

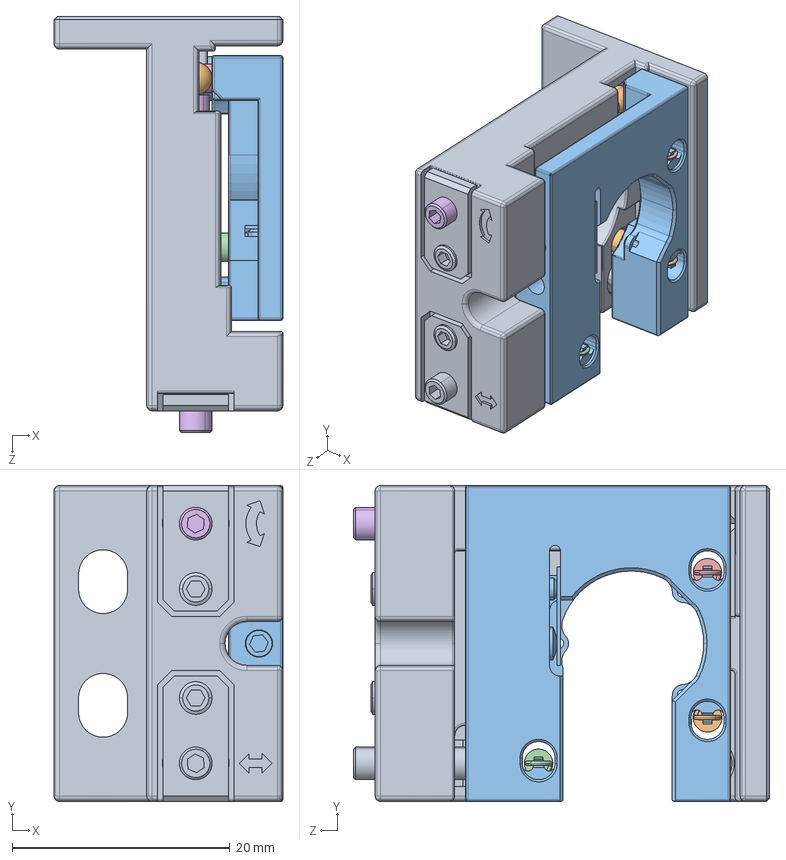
[picture p41: CAD file, 2025-04-15]
CAD/From Michelle/MHV-12.7L-F_STP.STEP
21.0 x 29.0 x 38.2 mm
MHV12.7L-M02-22001-S01.stp
MHV12.7L-M02-22001-S02.stp
MHV12.7L-M02-22001-S03.stp
MHV12.7L-M03-22005 A.stp
φ3.stp x 2
