RobertXii/860nm-Cateye-ECDL/CAD/New ECDL Design/Al Base Drawing.dxf

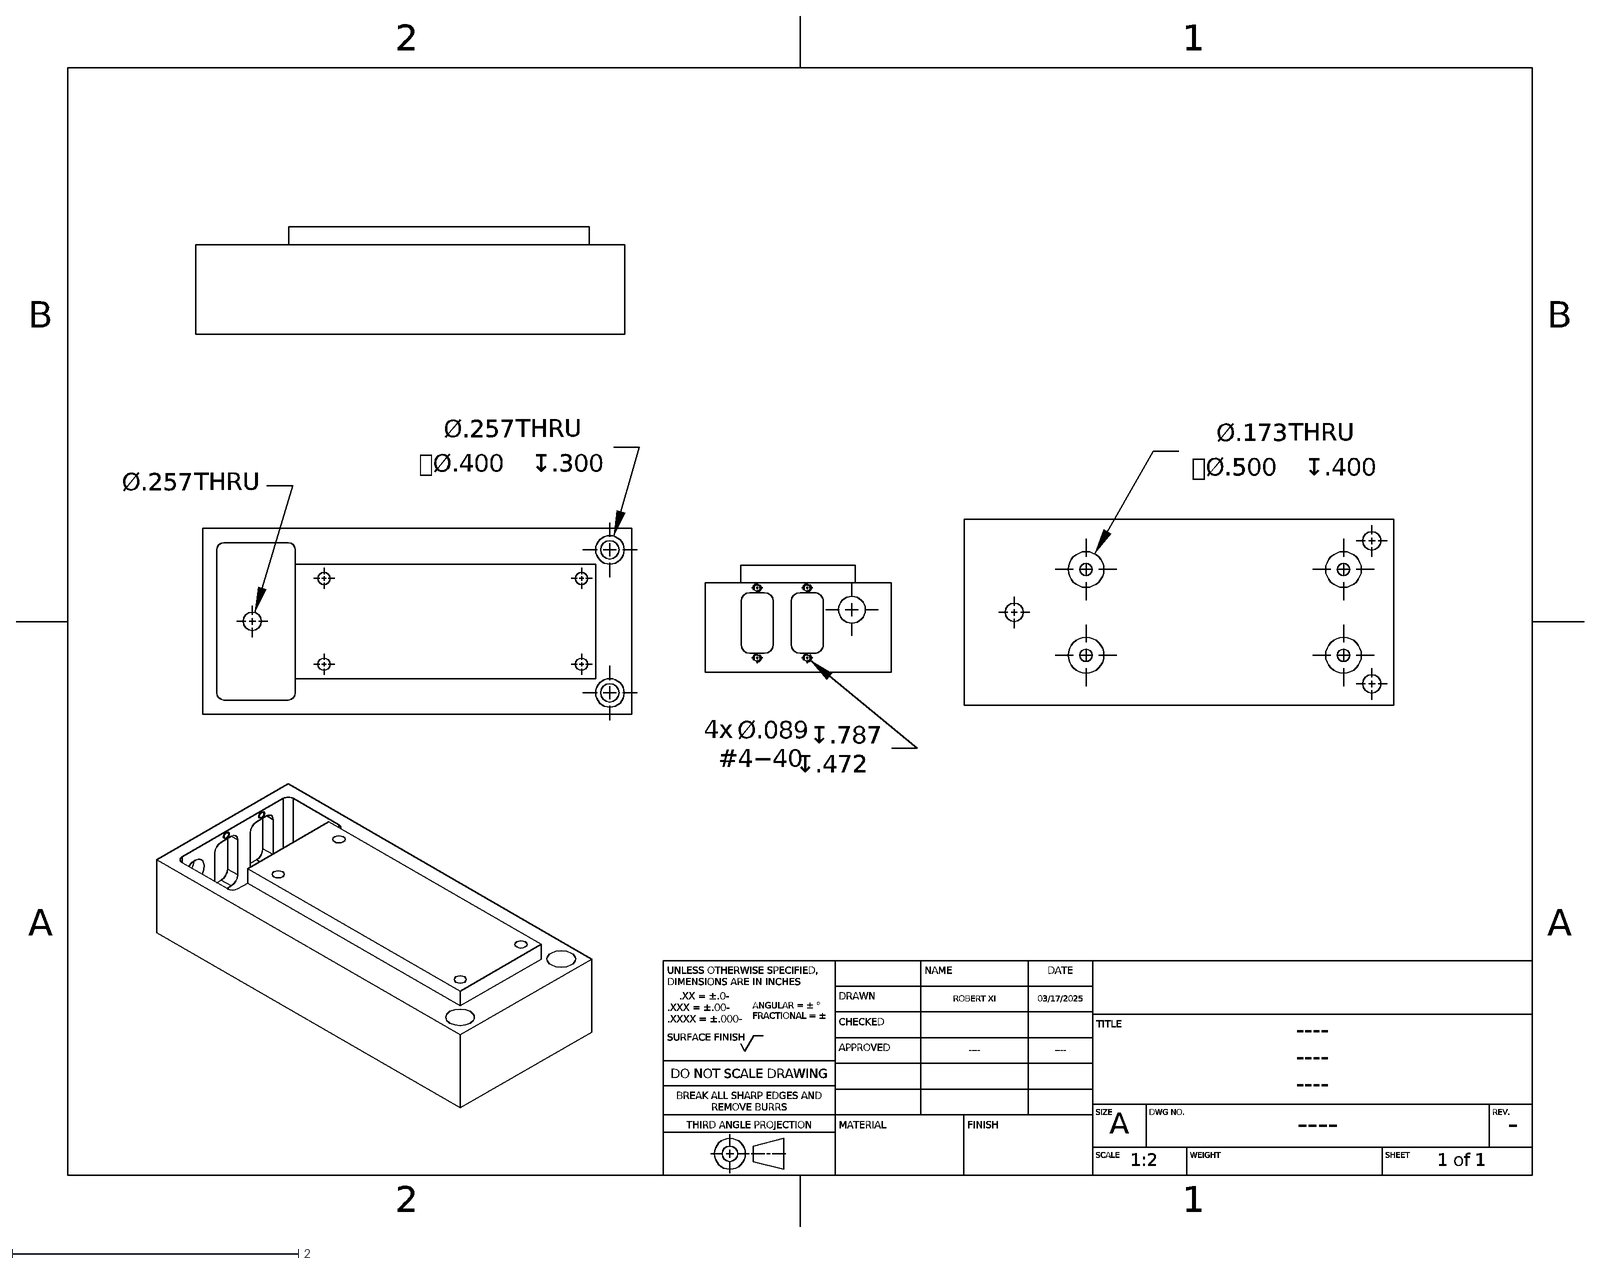
[picture p42: CAD file, 2025-05-07]
CAD/New ECDL Design/Al Base Drawing.dxf
2
1
A
B
UNLESS OTHERWISE SPECIFIED, DIMENSIONS ARE IN INCHES
.XX = ±.0- .XXX = ±.00- .XXXX = ±.000-
ANGULAR = ± ° FRACTIONAL = ±
SURFACE FINISH
DO NOT SCALE DRAWING
BREAK ALL SHARP EDGES AND REMOVE BURRS
THIRD ANGLE PROJECTION
NAME
DATE
DRAWN
ROBERT XI
03/17/2025
CHECKED
APPROVED
----
MATERIAL
FINISH
TITLE
SIZE
DWG NO.
REV.
-
SCALE
1:2
WEIGHT
SHEET
1 of 1
Ø.257
THRU
Ø.173
4x
Ø.089
#4−40
