RobertXii/860nm-Cateye-ECDL/CAD/parts/LT230P-B-Step.step

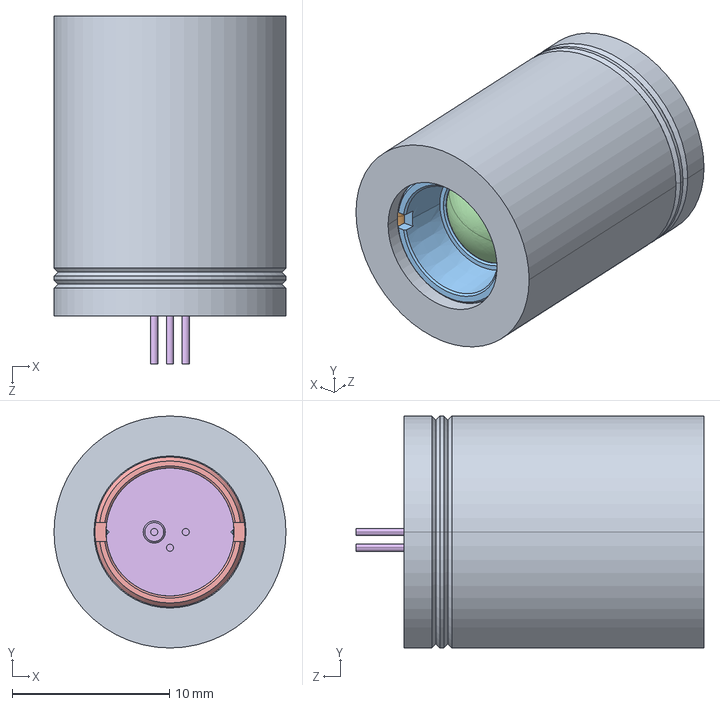
[picture p43: CAD file, 2025-04-15]
CAD/parts/LT230P-B-Step.step
14.7 x 14.7 x 22.1 mm
