RobertXii/860nm-Cateye-ECDL/CAD/From Michelle/plastic lid front.STEP

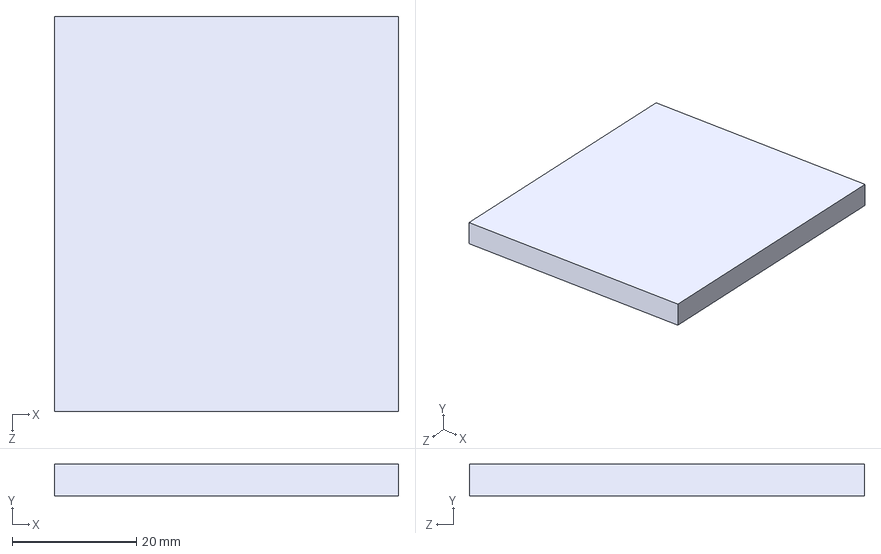
[picture p44: CAD file, 2025-04-15]
CAD/From Michelle/plastic lid front.STEP
55.4 x 5.08 x 63.5 mm
