RobertXii/860nm-Cateye-ECDL/CAD/New ECDL Design/Aluminum Base.step

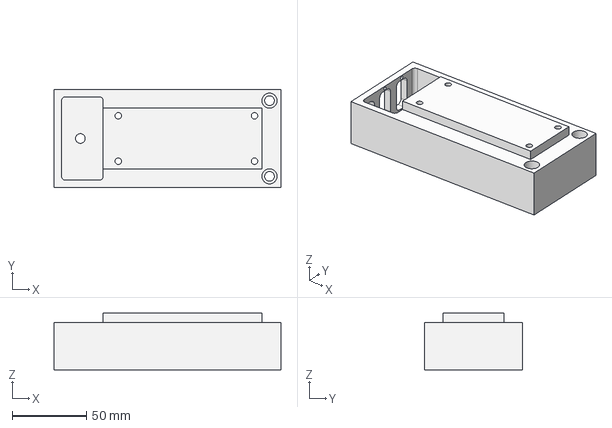
[picture p45: CAD file, 2025-05-07]
CAD/New ECDL Design/Aluminum Base.step
152.4 x 66.0 x 38.1 mm
