RobertXii/860nm-Cateye-ECDL/CAD/parts/BB03-E03-Step.step

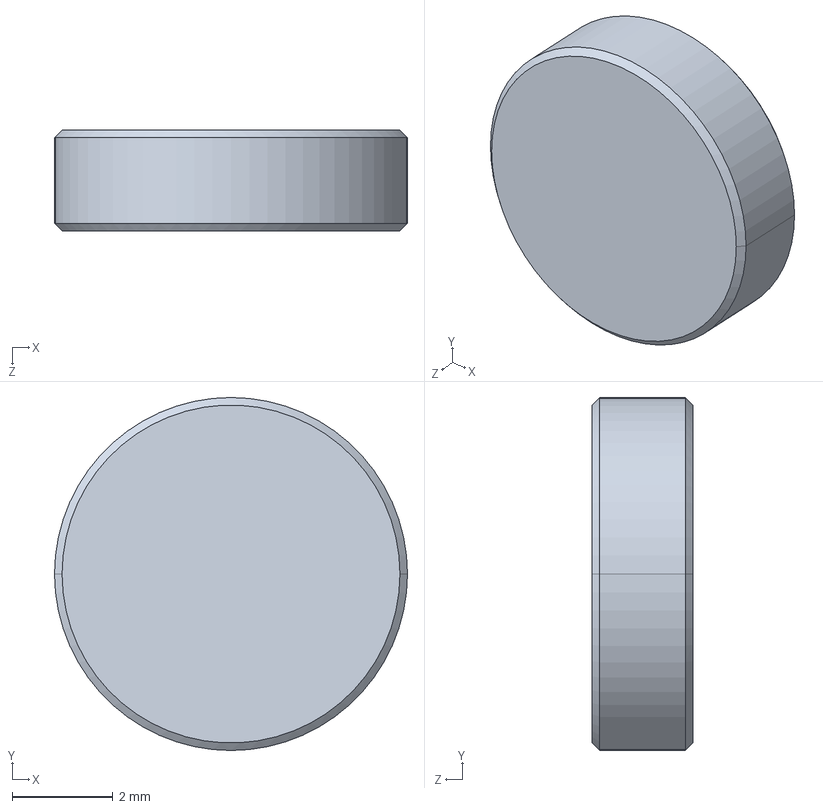
[picture p46: CAD file, 2025-04-15]
CAD/parts/BB03-E03-Step.step
7.00 x 7.00 x 2.00 mm
