RobertXii/860nm-Cateye-ECDL/CAD/New ECDL Design/Lid.step

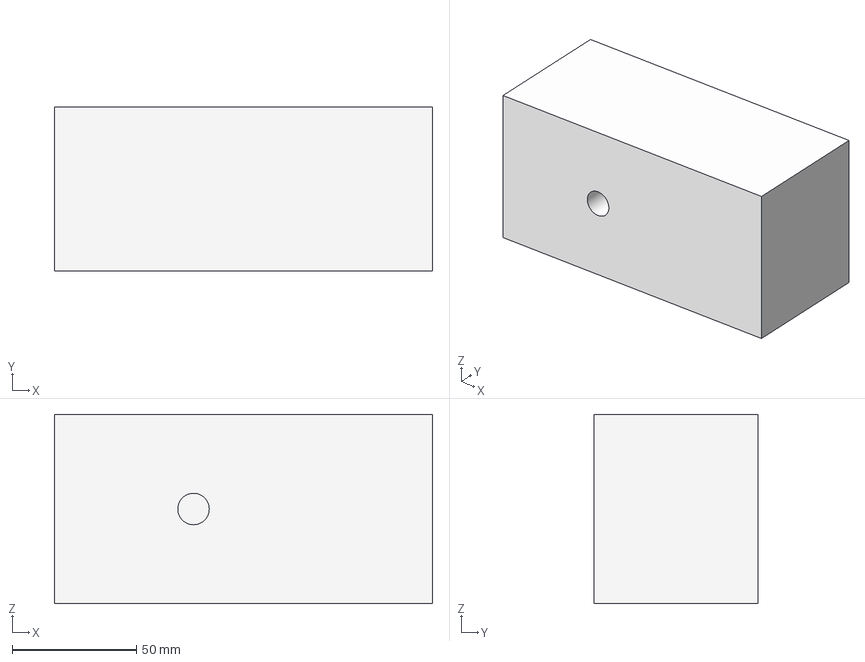
[picture p47: CAD file, 2025-04-15]
CAD/New ECDL Design/Lid.step
152.4 x 66.0 x 76.2 mm
