RobertXii/860nm-Cateye-ECDL/CAD/parts/SH8S038V-Step.step

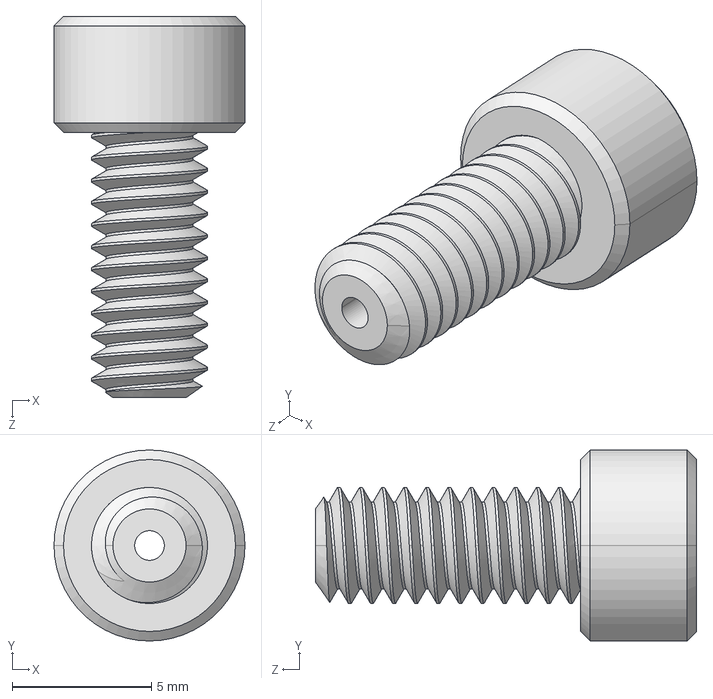
[picture p48: CAD file, 2025-04-15]
CAD/parts/SH8S038V-Step.step
6.86 x 6.86 x 13.7 mm
