RobertXii/860nm-Cateye-ECDL/CAD/From Michelle/Fixed Diode Housing Holder_base.STEP

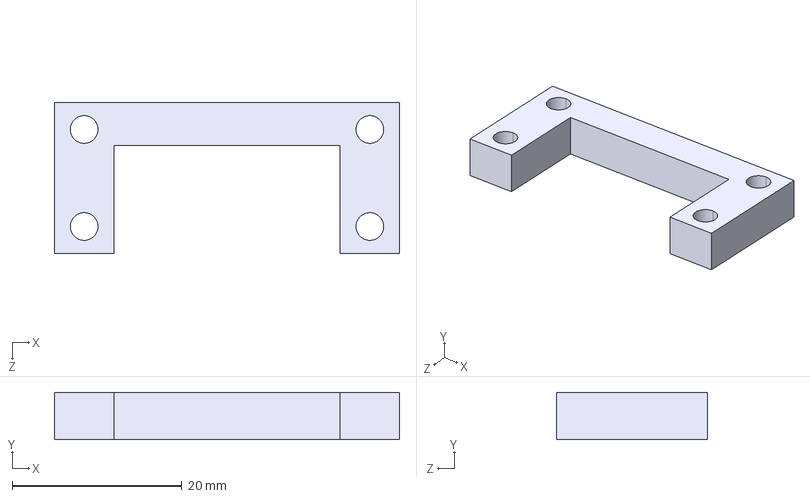
[picture p49: CAD file, 2025-04-15]
CAD/From Michelle/Fixed Diode Housing Holder_base.STEP
40.6 x 5.59 x 17.8 mm
