RobertXii/860nm-Cateye-ECDL/CAD/New ECDL Design/BS Spacer.step

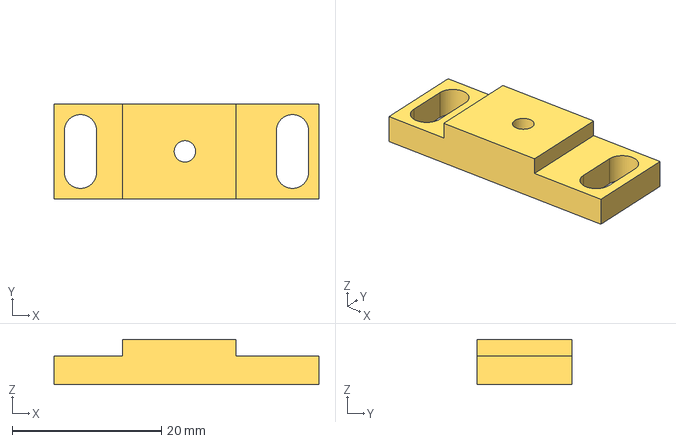
[picture p50: CAD file, 2025-04-15]
CAD/New ECDL Design/BS Spacer.step
35.6 x 12.7 x 6.05 mm
