RobertXii/860nm-Cateye-ECDL/CAD/parts/A220TM-B-Step.step

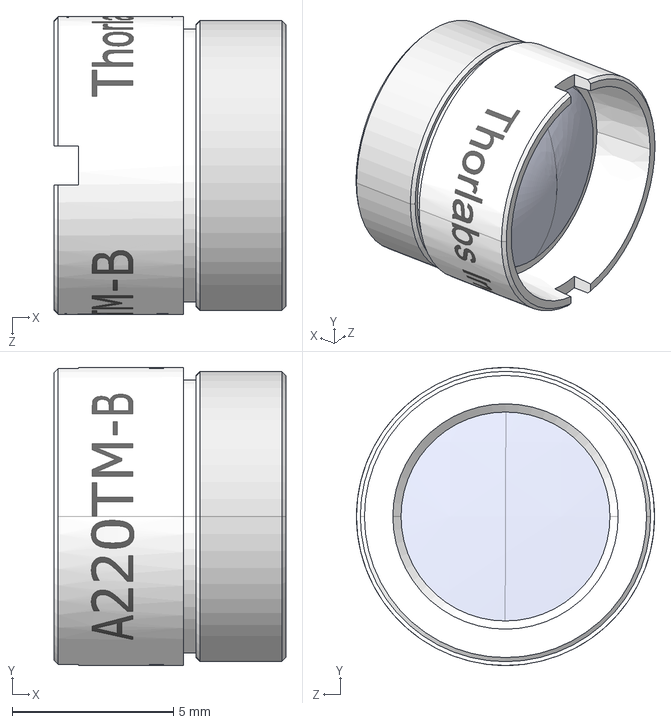
[picture p51: CAD file, 2025-04-15]
CAD/parts/A220TM-B-Step.step
7.19 x 9.24 x 9.24 mm
