RobertXii/860nm-Cateye-ECDL/CAD/From Michelle/plastic lid long side.STEP

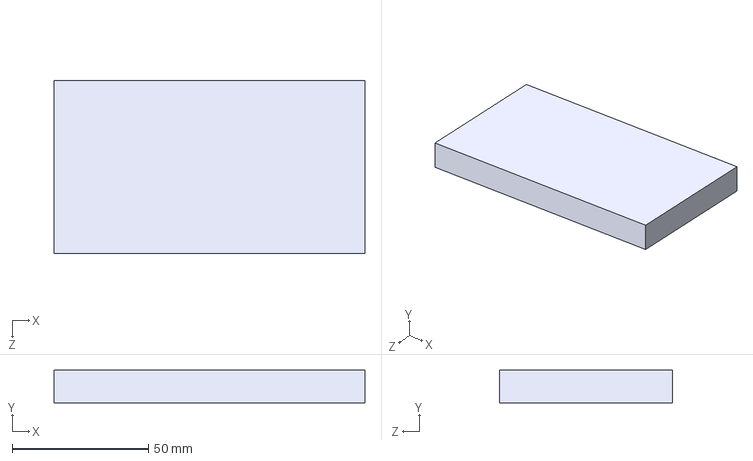
[picture p52: CAD file, 2025-04-15]
CAD/From Michelle/plastic lid long side.STEP
114.3 x 12.0 x 63.5 mm
