RobertXii/860nm-Cateye-ECDL/CAD/New ECDL Design/Brass base drawing.dxf

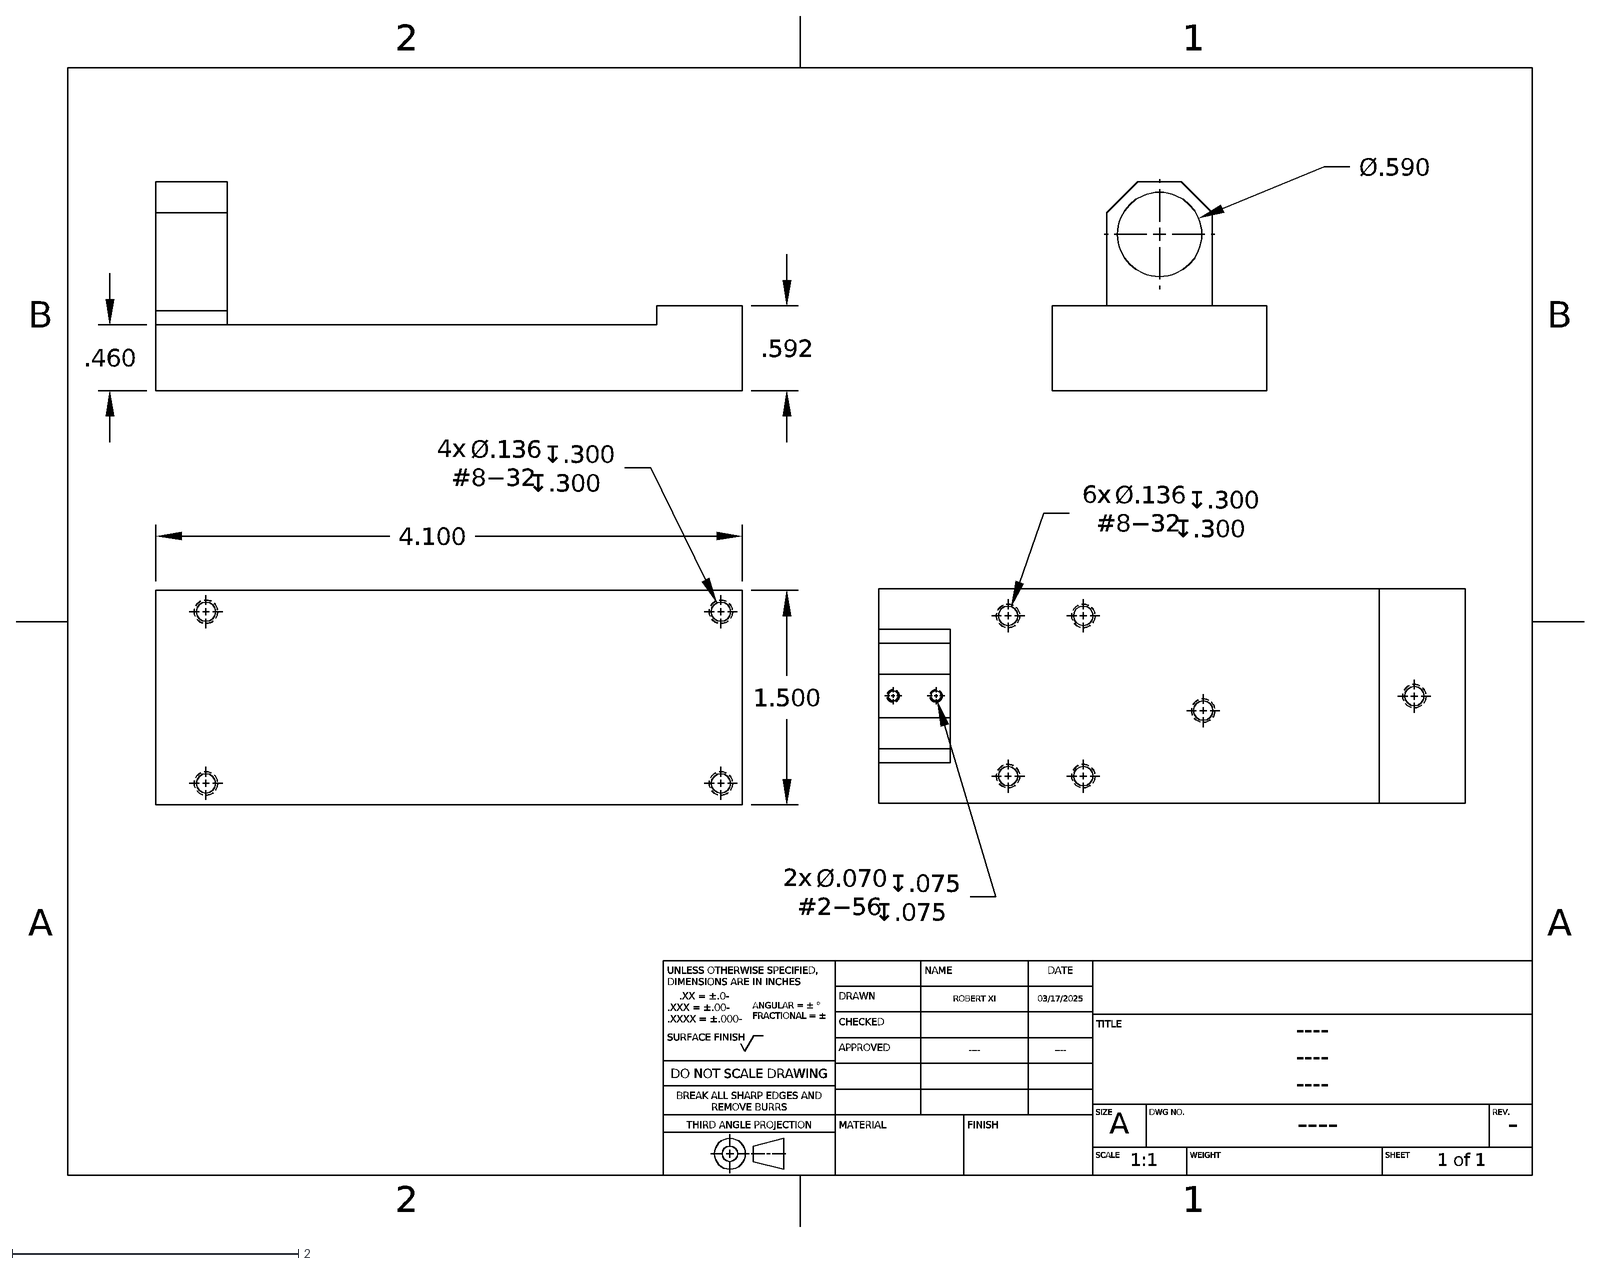
[picture p53: CAD file, 2025-04-15]
CAD/New ECDL Design/Brass base drawing.dxf
2
1
A
B
UNLESS OTHERWISE SPECIFIED, DIMENSIONS ARE IN INCHES
.XX = ±.0- .XXX = ±.00- .XXXX = ±.000-
ANGULAR = ± ° FRACTIONAL = ±
SURFACE FINISH
DO NOT SCALE DRAWING
BREAK ALL SHARP EDGES AND REMOVE BURRS
THIRD ANGLE PROJECTION
NAME
DATE
DRAWN
ROBERT XI
03/17/2025
CHECKED
APPROVED
----
MATERIAL
FINISH
TITLE
SIZE
DWG NO.
REV.
-
SCALE
1:1
WEIGHT
SHEET
1 of 1
4.100
1.500
6x
Ø.136
#8−32
2x
Ø.070
#2−56
4x
Ø.590
.592
.460
