RobertXii/860nm-Cateye-ECDL/CAD/parts/Newport-hvm-05r.stp

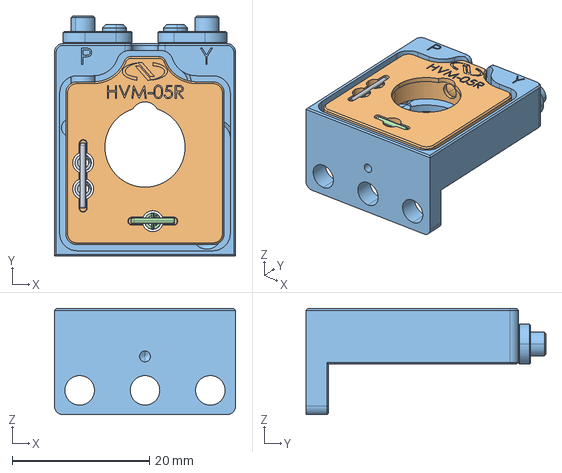
[picture p54: CAD file, 2025-04-15]
CAD/parts/Newport-hvm-05r.stp
26.4 x 35.0 x 15.5 mm
