RobertXii/860nm-Cateye-ECDL/CAD/From Michelle/Part2.STEP

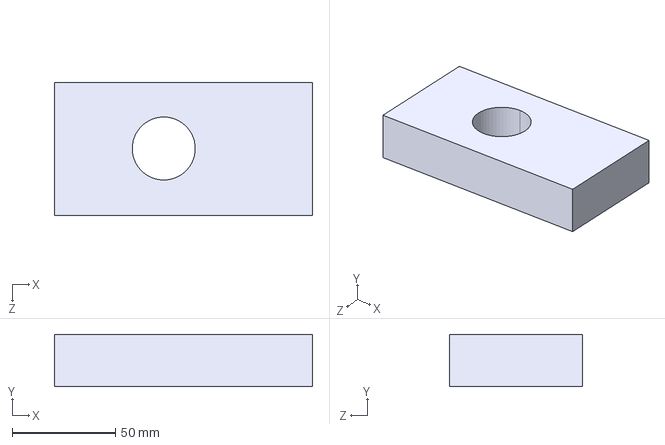
[picture p55: CAD file, 2025-04-15]
CAD/From Michelle/Part2.STEP
125.0 x 25.4 x 64.4 mm
