RobertXii/860nm-Cateye-ECDL/CAD/New ECDL Design/Waveplate Spacer.step

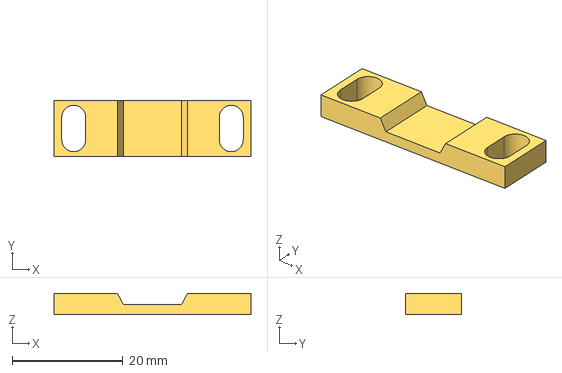
[picture p56: CAD file, 2025-04-15]
CAD/New ECDL Design/Waveplate Spacer.step
35.6 x 10.2 x 3.81 mm
