RobertXii/860nm-Cateye-ECDL/CAD/parts/BB05-E03-Step.step

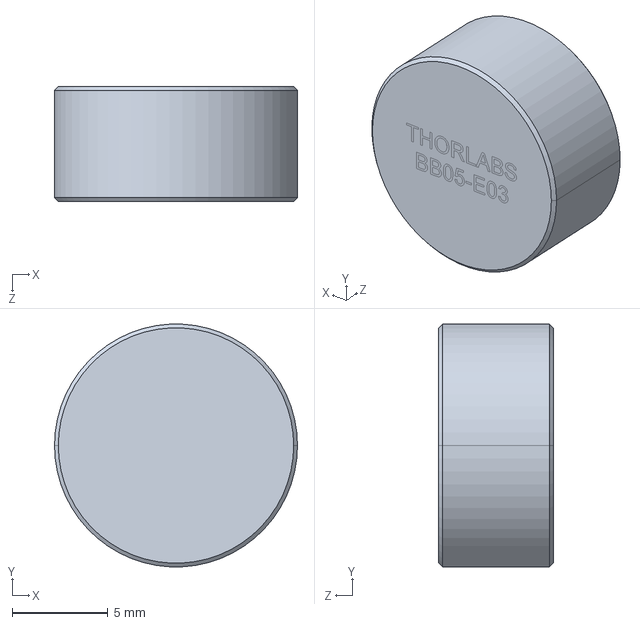
[picture p57: CAD file, 2025-04-15]
CAD/parts/BB05-E03-Step.step
12.7 x 12.7 x 6.00 mm
