RobertXii/860nm-Cateye-ECDL/CAD/From Michelle/Part1.STEP

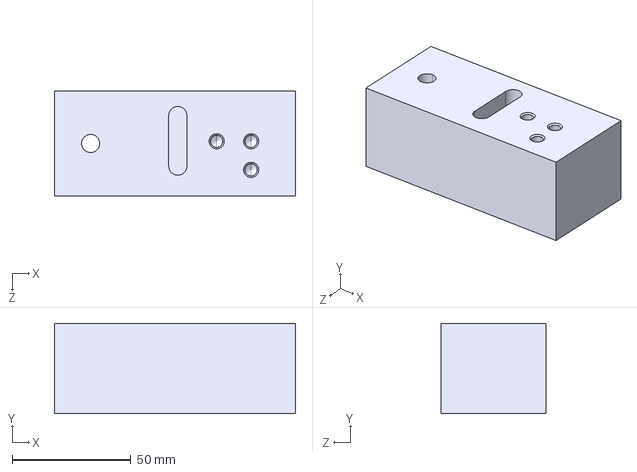
[picture p58: CAD file, 2025-04-15]
CAD/From Michelle/Part1.STEP
101.6 x 38.1 x 44.4 mm
