RobertXii/860nm-Cateye-ECDL/CAD/parts/msc-05664156.stp

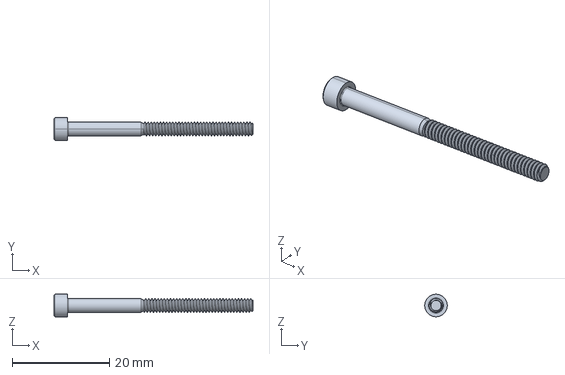
[picture p59: CAD file, 2025-04-15]
CAD/parts/msc-05664156.stp
40.9 x 4.65 x 4.65 mm
