RobertXii/860nm-Cateye-ECDL/CAD/From Michelle/Newport-hvm-05r.STEP

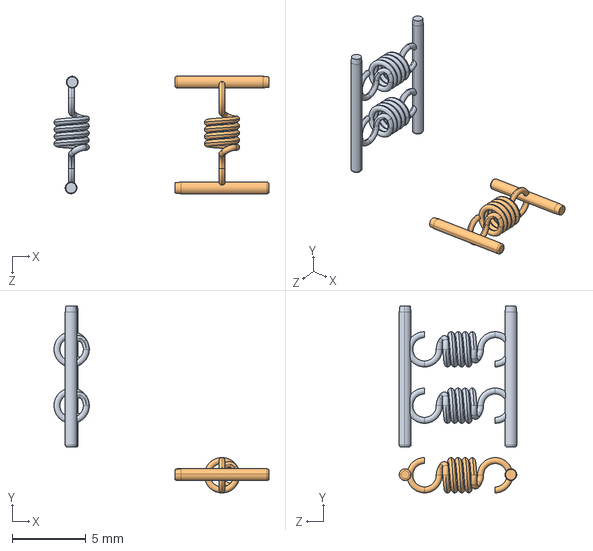
[picture p60: CAD file, 2025-04-15]
CAD/From Michelle/Newport-hvm-05r.STEP
14.5 x 12.6 x 7.95 mm
