RobertXii/860nm-Cateye-ECDL/CAD/parts/BSH10-Step.step

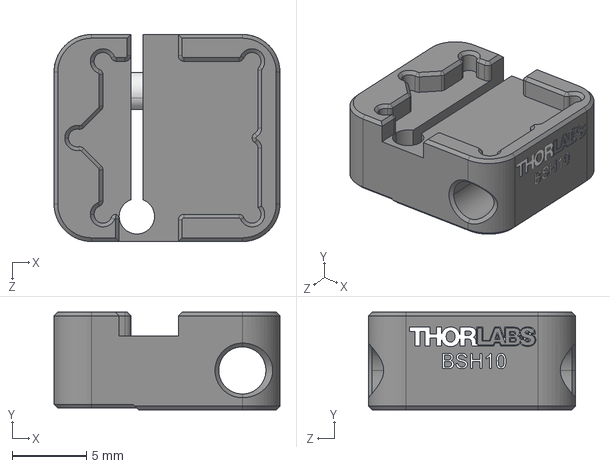
[picture p61: CAD file, 2025-04-15]
CAD/parts/BSH10-Step.step
15.2 x 6.60 x 14.0 mm
TTN159420
SH3S031-1
