RobertXii/860nm-Cateye-ECDL/CAD/From Michelle/plastic lid back.STEP

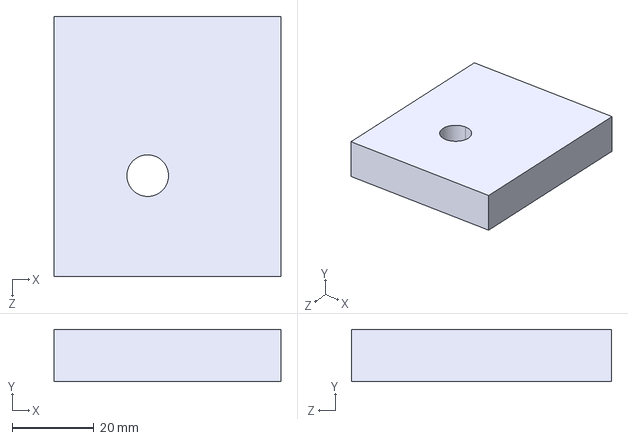
[picture p62: CAD file, 2025-04-15]
CAD/From Michelle/plastic lid back.STEP
55.4 x 12.7 x 63.5 mm
