RobertXii/860nm-Cateye-ECDL/CAD/parts/SM05L03-Step.step

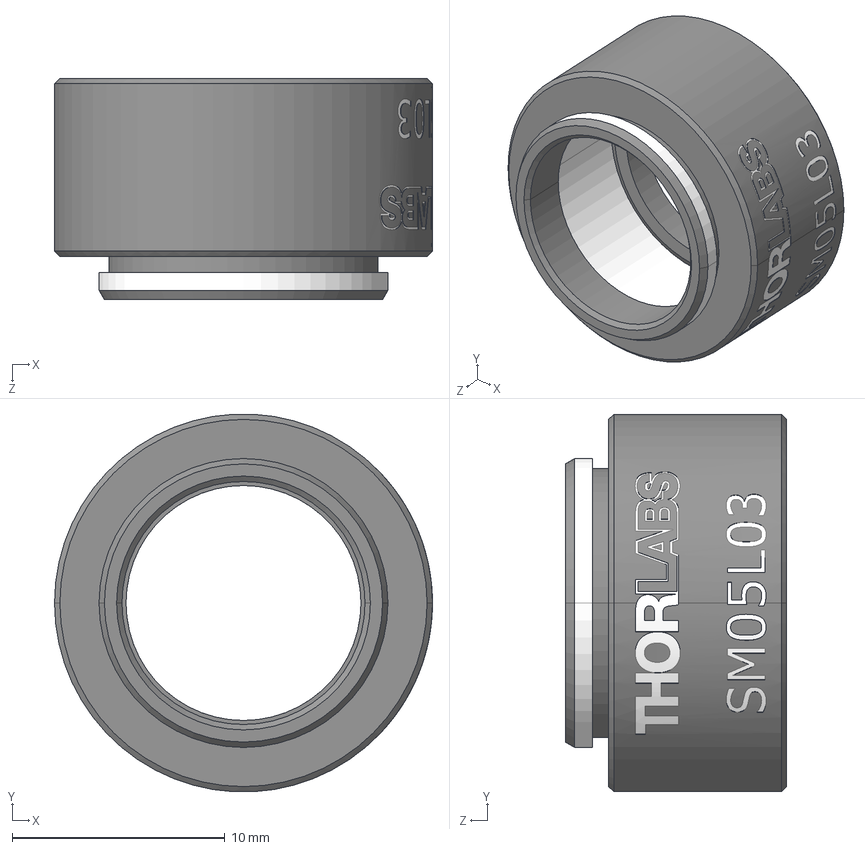
[picture p63: CAD file, 2025-04-15]
CAD/parts/SM05L03-Step.step
17.8 x 17.8 x 10.4 mm
