RobertXii/860nm-Cateye-ECDL/CAD/parts/step_65122.step

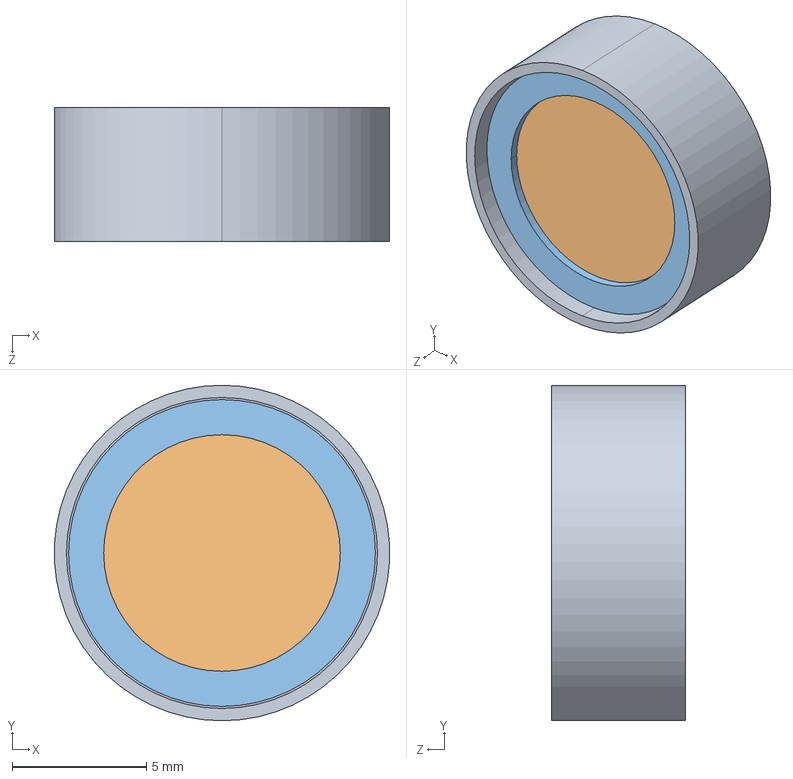
[picture p64: CAD file, 2025-04-15]
CAD/parts/step_65122.step
12.5 x 12.5 x 5.00 mm
