RobertXii/860nm-Cateye-ECDL/CAD/parts/A230TM-B-Step.step

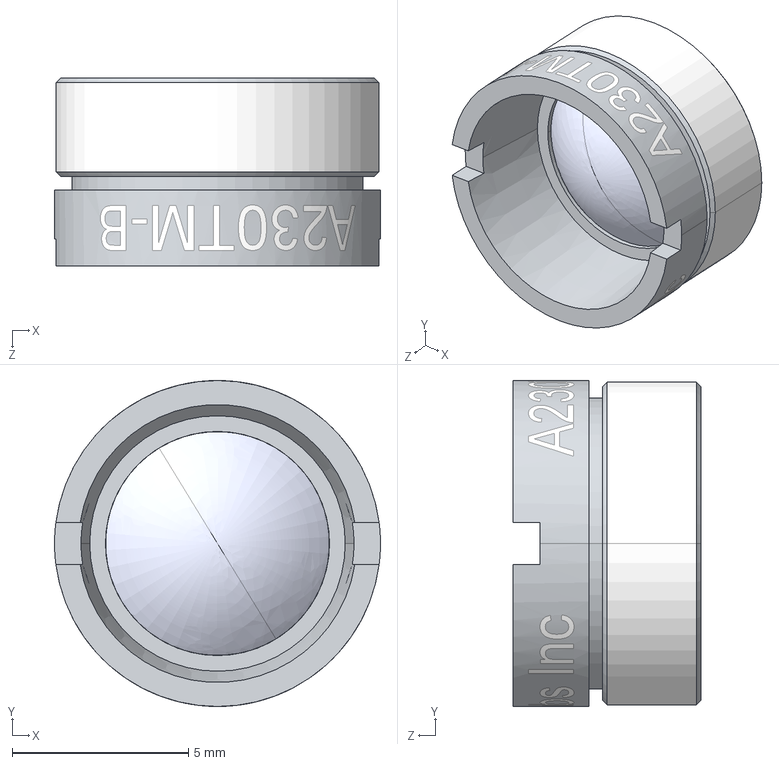
[picture p65: CAD file, 2025-04-15]
CAD/parts/A230TM-B-Step.step
9.24 x 9.24 x 5.33 mm
