RobertXii/860nm-Cateye-ECDL/CAD/parts/SM05L10-Step.step

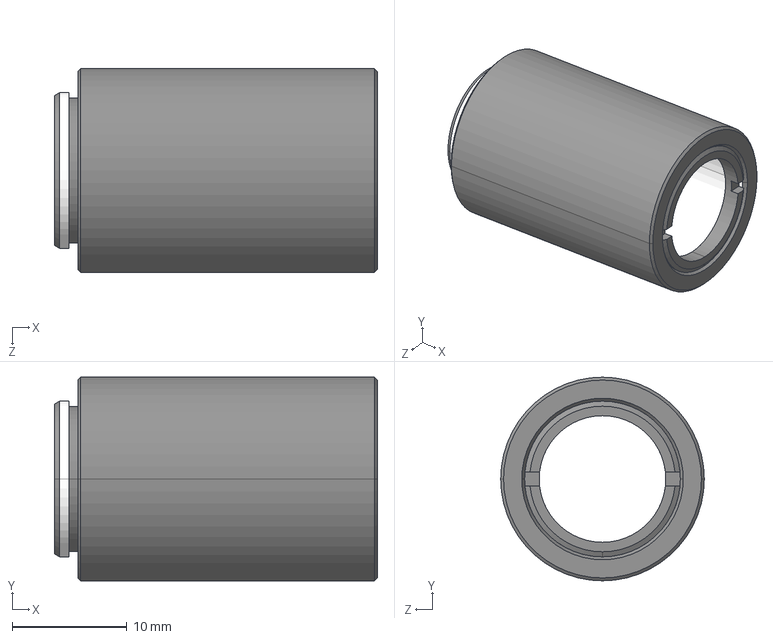
[picture p66: CAD file, 2025-04-15]
CAD/parts/SM05L10-Step.step
28.2 x 17.8 x 17.8 mm
