RobertXii/860nm-Cateye-ECDL/CAD/parts/PBS102-Step.step

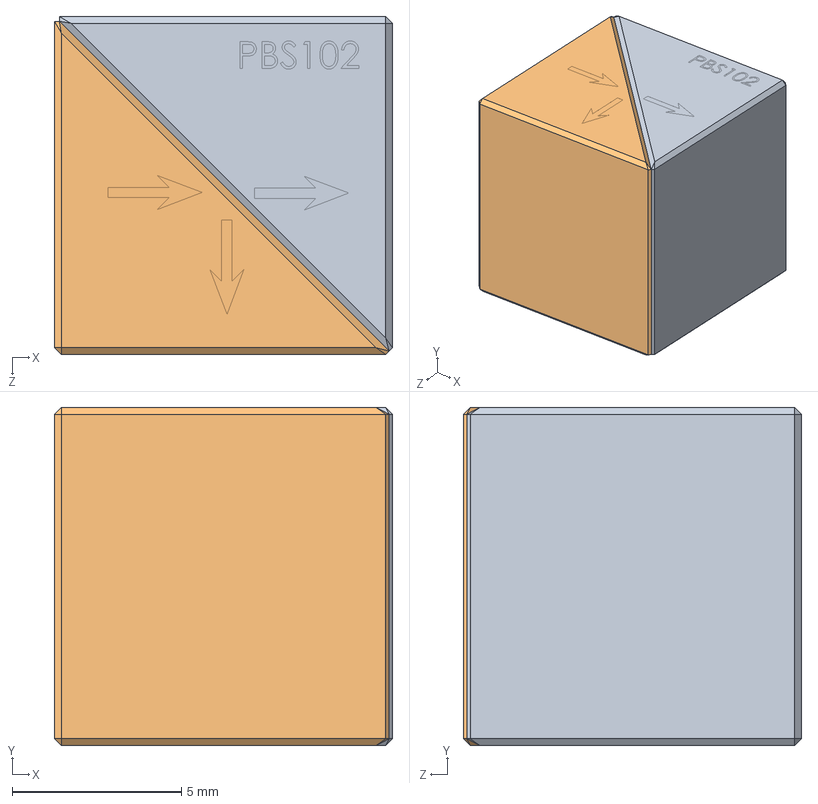
[picture p67: CAD file, 2025-04-15]
CAD/parts/PBS102-Step.step
10.0 x 10.0 x 10.0 mm
