RobertXii/860nm-Cateye-ECDL/CAD/parts/S05TM09-Step.step

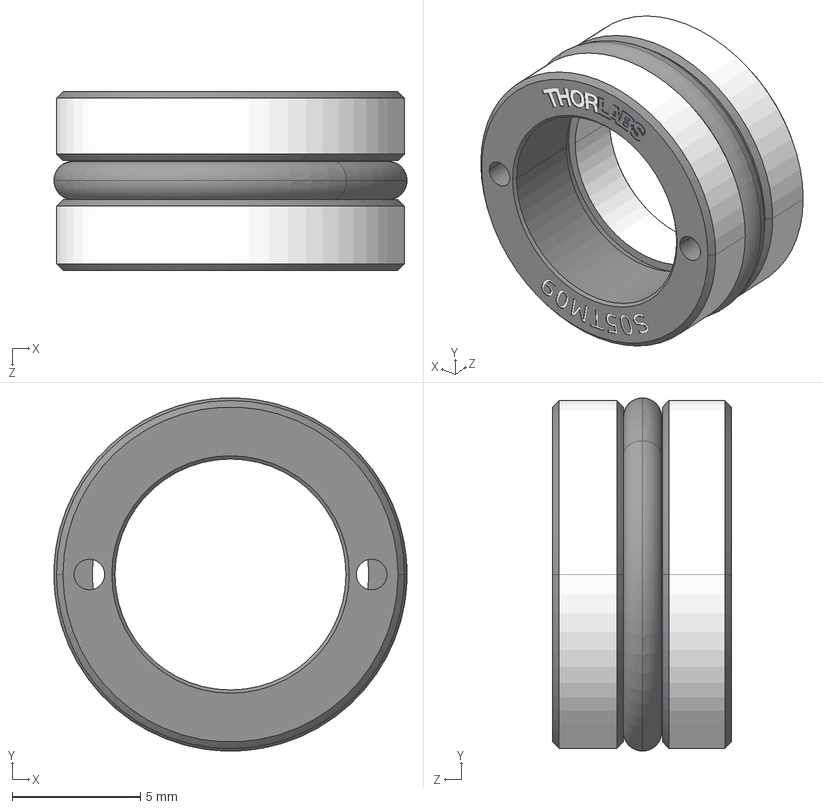
[picture p68: CAD file, 2025-04-15]
CAD/parts/S05TM09-Step.step
13.8 x 13.8 x 6.99 mm
