RobertXii/860nm-Cateye-ECDL/CAD/parts/SH8S050V-Step.step

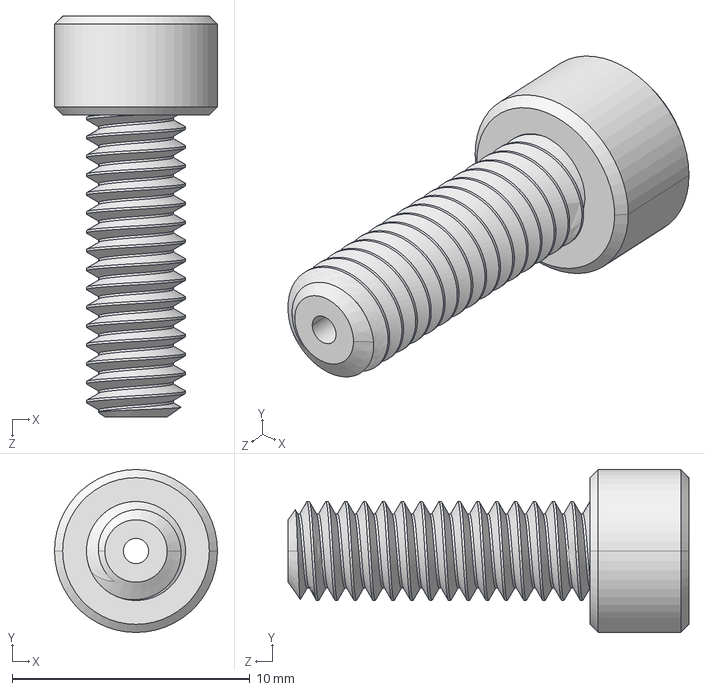
[picture p69: CAD file, 2025-04-15]
CAD/parts/SH8S050V-Step.step
6.86 x 6.86 x 16.9 mm
