RobertXii/860nm-Cateye-ECDL/(list of files, cad)

Other CAD files:
CAD/From Michelle/Fixed Diode Housing Holder_base.SLDPRT
CAD/From Michelle/diode base.SLDPRT
CAD/parts/90291A847_18-8 Stainless Steel Nylon-Tip Set Screw.STEP
CAD/parts/92220A121_Alloy Steel Low-Profile Socket Head Screw.STEP
CAD/parts/92562A276_Mil. Spec. Alloy Steel Socket Head Screw.STEP
CAD/parts/92562A712_Mil. Spec. Alloy Steel Socket Head Screw.STEP
CAD/parts/CP60440.STEP
CAD/parts/LT230220P-B-Step.step
