RobertXii/860nm-Cateye-ECDL/Cateye_IF_ECDL_Setup.pdf

# Cateye IF ECDL Setup


## Robert Xi

August 9, 2026

## Contents

1

Cateye IF ECDL Setup | 2

## 1 Introduction

This handbook provides a guide to the design, alignment, and operation of a cateye interference filter external cavity diode laser (ECDL). The setup combines an ultra-narrow bandpass interference filter and a cateye retro-reflector to achieve robust frequency selectivity and high mechanical stability. Key components such as the feed-forward tuning scheme, optical feedback optimization, and protection circuits are detailed. This document is intended as a practical reference for constructing and maintaining a high-performance ECDL.

### 1.1 Theoretical Basis for ECDL

The output frequency ν of an ECDL is determined by the combined effects of frequencydependent gain and loss mechanisms. The laser oscillates at the frequency where the total transmission gain is maximized[4]:

Ttotal = GDTDTcavityTfilter | (1)
350.5 | 350 | 349.5 | 349 | 348.5 | 348 | 347.5 | 347
Frequency (THz)

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
Transmission

Total Transmission
maximum
Gain Profile
Filter Transmission
Diode Cavity Transmission
348.95 | 348.9 | 348.85 | 348.8 | 348.75 | 348.7 | 348.65 | 348.6 | 348.55 | 348.5
Frequency (THz)

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
Transmission

859.71000 nm
348.71347 THz Total Transmission maximum
Gain Profile
Filter Transmission
Diode Cavity Transmission

Figure 1: Example simulation result of the total transmission profile of a typical cateye IF ECDL as a function of frequency. The ECDL will lase at the frequency with maximum transmission

Here GD is the diode’s gain profile of the laser diode, TD is the transmission function of the internal diode cavity. Tcavity is the transmission function of the external cavity (e.g., cateye reflector), and Tfilter is the transmission profile of the interference filter. The diode will lase at the frequency where this product is maximized. Figure 1 shows an example of simulated total transmission profile of a typical ECDL. The transmission function of a Fabry–Perot cavity is:

T(ν) = | 1
1 + F sin²
δ(ν)
| (2)

where F =

4r1r2
(1−r1r2)

2 is the finesse coefficient and δ(ν) = 2πnLν
c

, with r1, r2 the reflectivity of the cavity mirrors, L as the cavity length, and n the refractive index.
Tuning the frequency of the ECDL output can be think as shifting the total transmission gain peak, which can be achieved by: rotating the filter angle, changing the temperature, current of the diode, and voltage of the piezo. The wavelength of the transmission peak shifts with filter angle θ given by:

λ(θ) = λ0

s
1 −
sin(θ)

neff 2
(3)

where neff is the index of reflection of the filter’s material. Changing the temperature and current of the diode changes GD and TD. Increasing current red-shifting the gain peak, which can be thought as increases the diode cavity length via thermal expansion. Increasing the piezo voltage reduce the external cavity length, thus increase the frequency.

### 1.1.1 Feed-Forward Scheme

Feed-forward in an ECDL is a method to keep the laser frequency stable while tuning. As you adjust the external cavity length via a piezo, the internal diode cavity also needs to shift to stay in resonance and avoid mode hops. Feed-forward works by simultaneously changing the diode current along with the piezo voltage, using a pre-calibrated ratio. This ensures both cavities’ transmission peaks remain aligned, allowing smooth, continuous frequency tuning without jumps. This feed-forward scheme can be implemented using either digital or analog methods, as detailed in Sections 2.4 and 2.3.

### 1.1.2 Why Cateye Configuration?

In a cateye configuration, a lens-mirror combination (Cateye) and a lens-source aligned facing each other, with the mirror/light source at the focal plane/point of the lens. The cateye configuration is chosen over a simple two parallel flat mirror design due to its angular insensitivity, as shown in Figure 2. It reflects any incoming collimated beam back to the source, regardless of their relative angle (provided the beam strikes the Cateye). So it’s easy to align and

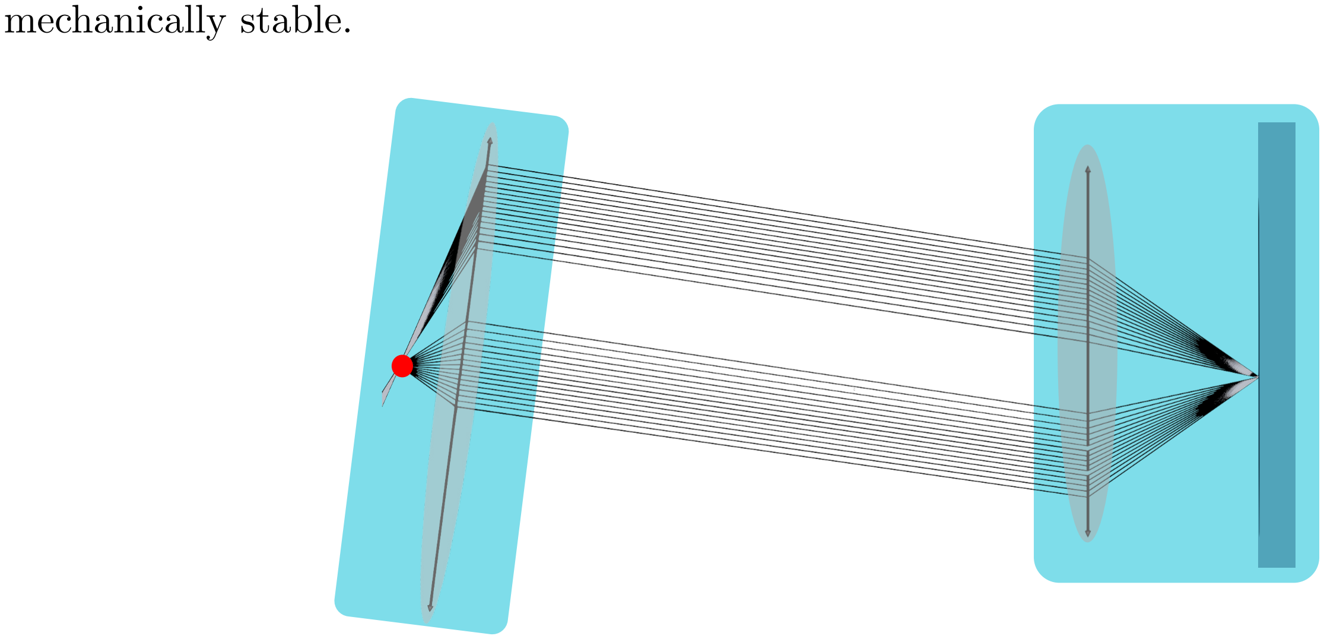
[picture p70: figure]
mechanically stable.

Figure 2: Demonstration of cateye retro-reflector configuration. All the rays emerged from the source goes back to the source

### 1.1.3 Importance of Feedback Alignment

ECDL performance is highly sensitive to optical feedback. Misalignment reduces feedback efficiency F, which can make the ECDL unstable or multimode. Feedback efficiency is defined by the overlap of emitted and reflected electric fields:

F =

1
R

# Z Z E

∗
i Erdxdy

2
(4)

where R is the coupler reflectivity, which normalizes F so that perfect reflection gives F = 1. Small misalignment, either angular (α) or axial (δ), reduce F according to[1]

F = exp
−

απω0
λ

2

and F =
1 +

δ

2λ

2

π

2ω

4/0−1
(5)

For a beam waist ω0 ≈ 10 µm, a misalignment of α = 0.5

- or δ = 0.1 mm can reduce feedback by 10%. Hence, precise positioning of the cateye reflector is critical. A well-designed ECDL should enable easy adjustment of both axial position and tilt to optimize feedback.

### 1.2 Design Overview

The cateye IF ECDL comprises two collimating lenses—one to collimate the diode output and the other to focus the beam onto the mirror—a λ/2 plate and a PBS for precise control of the feedback intensity, an interference filter on a rotational mount for coarse wavelength tuning (see Eq. 3), and a piezo-mounted mirror at the second lens’s focal plane that provides fine frequency tuning via the piezo voltage. The self-aligning cateye retro-reflector minimizes sensitivity to mechanical noise and misalignment.
All optical elements are mounted on a 360 Brass block, which in turn rests on an aluminum base with a TEC sandwiched between them. A 1-inch thick acrylic lid encloses the assembly to provide thermal and vibrational stability.

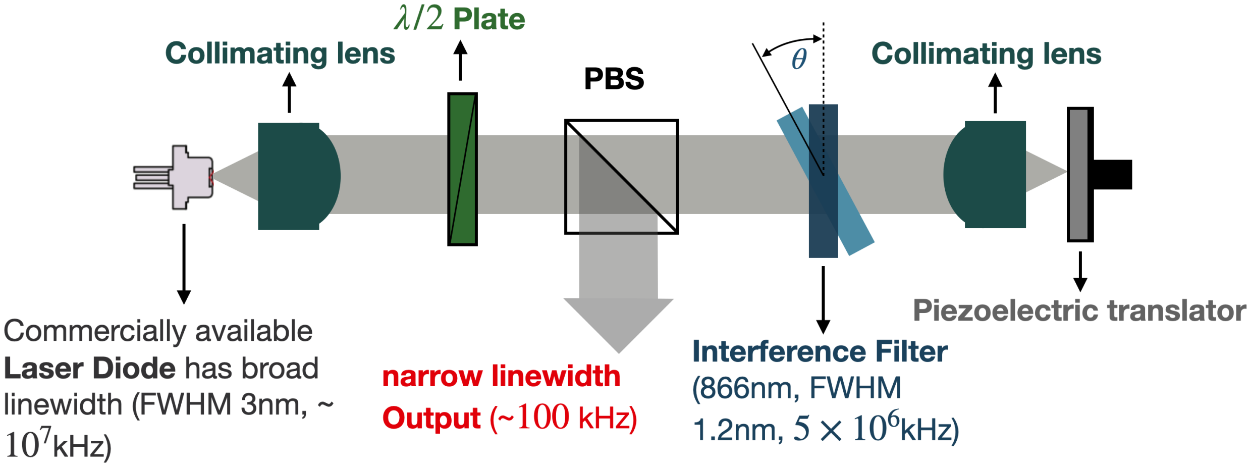
[picture p71: figure]

Figure 3: Schematics of Cateye IF ECDL Optics

The total effective feedback in this design can be calculated based on the initial polarization angle of the diode output (measured relative to the vertical axis) denoted by θ, and the orientation of the half-wave plate (HWP), whose fast axis makes an angle ϕ wrt. the vertical axis. Given that a HWP rotates linear polarization by 2(θ − ϕ) across the fast axis, and by assuming that the diode keeps lase along its initial polarization direction regardless of the polarization of the feedback (which may not always hold true in practice, as indicated by experimental observations), the effective feedback is then given by the projection of the feedback polarization onto the diode’s original polarization direction, i.e., the component of the returning light aligned with the original polarization axis of the diode, one can calculate the effective feedback as

Ieff = I0

1
4

(cos(2θ) − cos(4ϕ))²
(6)

This result indicates that the effective feedback depends sensitively on the polarization of the input laser diode. The analysis assumes the diode’s output polarization remains fixed; however, in reality, the situation can be more complex. If the laser diode’s gain is not sharply peaked (i.e., not a delta-function) with respect to polarization, the output polarization may shift in response to strong injected feedback with a different polarization. In such cases, the diode may favor lasing along a new polarization axis that maximizes the net gain, including contributions from both internal and external feedback. This feedback-induced polarization instability introduces nonlinear behavior and complicates the analysis significantly, potentially requiring a full model of the polarization-dependent gain dynamics. Fortunately, experience shows that a stable ECDL can still be achieved even when polarization-dependent gain effects are present.

## 2 Circuits

### 2.1 Laser Diode Protection Circuit

To ensure the safe and stable operation of the laser diode (LD), a protection circuit is implemented, as illustrated in Figure 4. This circuit suppresses voltage transients, mitigates electromagnetic interference (EMI), and limits current surges. The circuit can be divided into three functional blocks: protection diodes, low-pass filter, and current-limiting resistor.

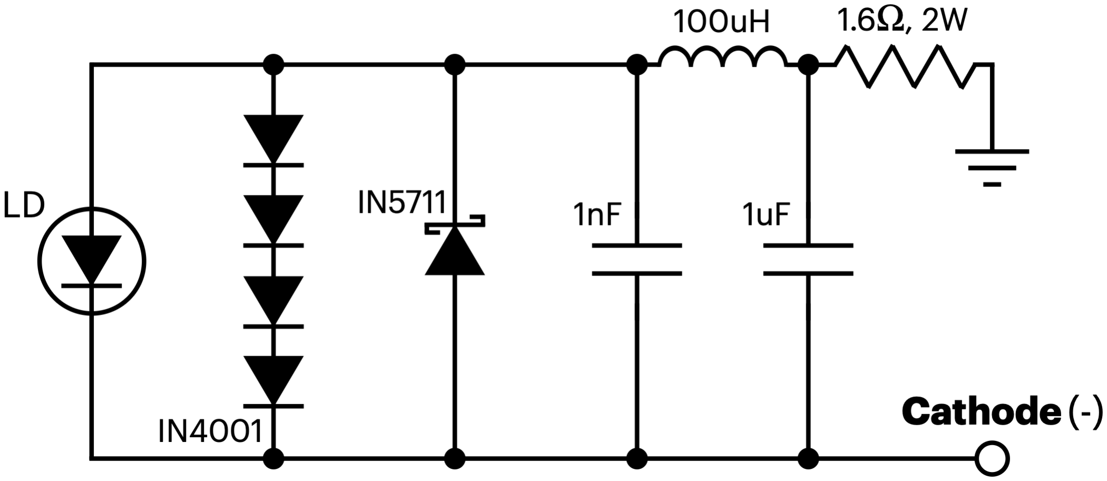
[picture p72: figure]

Figure 4: Laser diode protection circuit

Transient and Reverse Polarity Protection

- 1N4001 Diodes (×4): These general-purpose silicon diodes are connected in series and placed in parallel with the laser diode to provide clamping protection against voltage transients, particularly electrostatic discharge (ESD) or switching spikes. Each diode has a forward voltage drop of approximately 0.7 V. When forward biased, the total voltage drop across the four diodes is approximately 2.8 V, which effectively clamps the voltage across the laser diode and prevents it from exceeding a safe threshold. This configuration ensures that any transient voltage above this limit is diverted through the diodes rather than damaging the LD.
- 1N5711 Schottky Diode: Placed in parallel with the LD in reverse orientation, this diode protects against reverse voltage. Since laser diodes are extremely sensitive to reverse bias, even small reverse voltages can cause permanent damage. The 1N5711 has a low forward voltage (∼0.4 V), allowing it to conduct and clamp quickly if a reverse voltage appears.

Low-Pass Filtering Network

To suppress noise from the power supply and reduce high-frequency EMI coupling into the LD, a low-pass filter is implemented using a combination of inductors and capacitors:

- 100µH Inductor: This component provides high impedance to high-frequency signals, effectively attenuating them. It serves as a choke to block rapid voltage transients and forms the central component of a pi-filter.
- 1nF and 1µF Capacitors: These capacitors are placed to ground before and after the inductor. They provide a low-impedance path for high-frequency noise, shunting it away from the LD.

The combined structure (C–L–C) forms a second-order passive low-pass filter. The cutoff frequency fc for such a filter is given by:

fc =

1
2π

√
LC where C is the equivalent capacitance of the two capacitors. Because the capacitors are separated by the inductor, the dominant attenuation is determined by the smaller capacitor (1 nF) at high frequencies. Using L = 100 µH and C = 1 nF:

fc ≈

1
2π

p
(100 × 10⁻⁶)(1 × 10⁻⁹)

≈ 500 kHz

This ensures effective attenuation of switching noise and RF interference above the kHz range.

Current-Limiting Resistor

- 1.6Ω, 2W Resistor: This resistor limits inrush current and provides protection against short-duration voltage spikes that might bypass other protection mechanisms. The power rating of 2W allows it to handle transient pulses without damage.

The voltage drop across the resistor during normal operation can be calculated using Ohm’s Law:
V = IR

For example, if the LD operates at 100 mA:

V = 0.1 A × 1.6 Ω = 0.16 V

The resistor thus causes a small voltage drop while offering valuable current limiting protection.

### 2.2 Piezo Protection Circuit

To protect the piezoelectric actuator from high-frequency noise and voltage spikes, a simple RC low-pass filter is employed at its input, shown in Figure 5. This configuration helps prevent unwanted oscillations or electrical interference from affecting the piezo response.

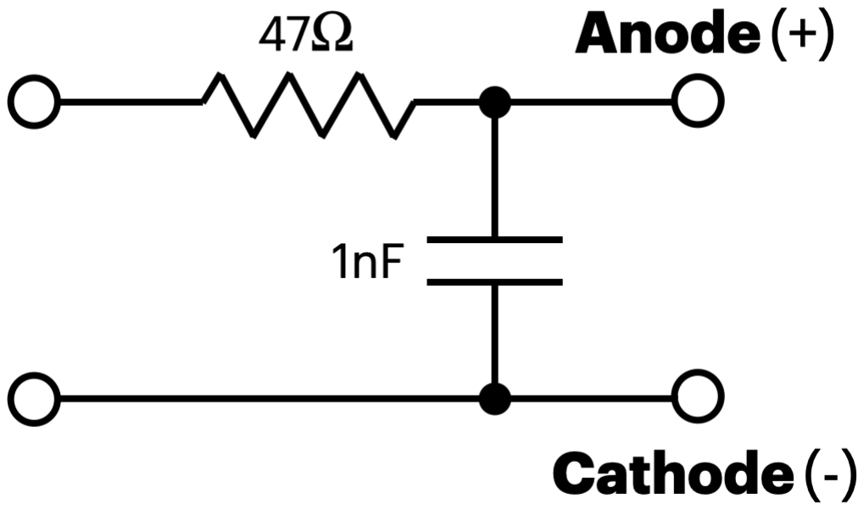
[picture p73: figure]

Figure 5: Piezo protection circuit

The capacitor and resistor forms a RC low-pass filter. The cutoff frequency fc of this RC low-pass filter is calculated as:

fc =

1
2πRC =

1
2π × 47Ω × 1nF

≈ 3.4kHz

This means signals above ∼3.4 kHz are significantly attenuated, and thus limiting the PHD locking bandwidth. This is not an issue as the piezo itself is inherently a low pass filter with few kHz bandwidth. As will be discussed later, a fast control with current injection would be a better option if one wants to perform a high bandwidth (few MHz) locking.

### 2.3 Digital Feedforward Circuit

Adjusting either the diode current or the piezo voltage independently yields a relatively limited mode-hop-free tuning range (MHFTR), typically around 1.5 GHz. A straightforward method to extend the MHFTR is to implement feedforward control, that is, to adjust the current and piezo voltage simultaneously with a certain ratio. By compensating the frequency shift induced by one tuning mechanism with the other, the laser can be kept on the same longitudinal mode over a broader frequency range. This technique effectively increases the usable, continuous tuning range of the ECDL without mode hops. This technique can be implemented through either digital or analog means, though digital implementations may introduce additional noise due to DAC resolution and sampling artifacts, but can be easily set up for quick test. In this section, we first describe the digital feedforward scheme, where both the diode current and piezo voltage are controlled via a computer through the DAQ.

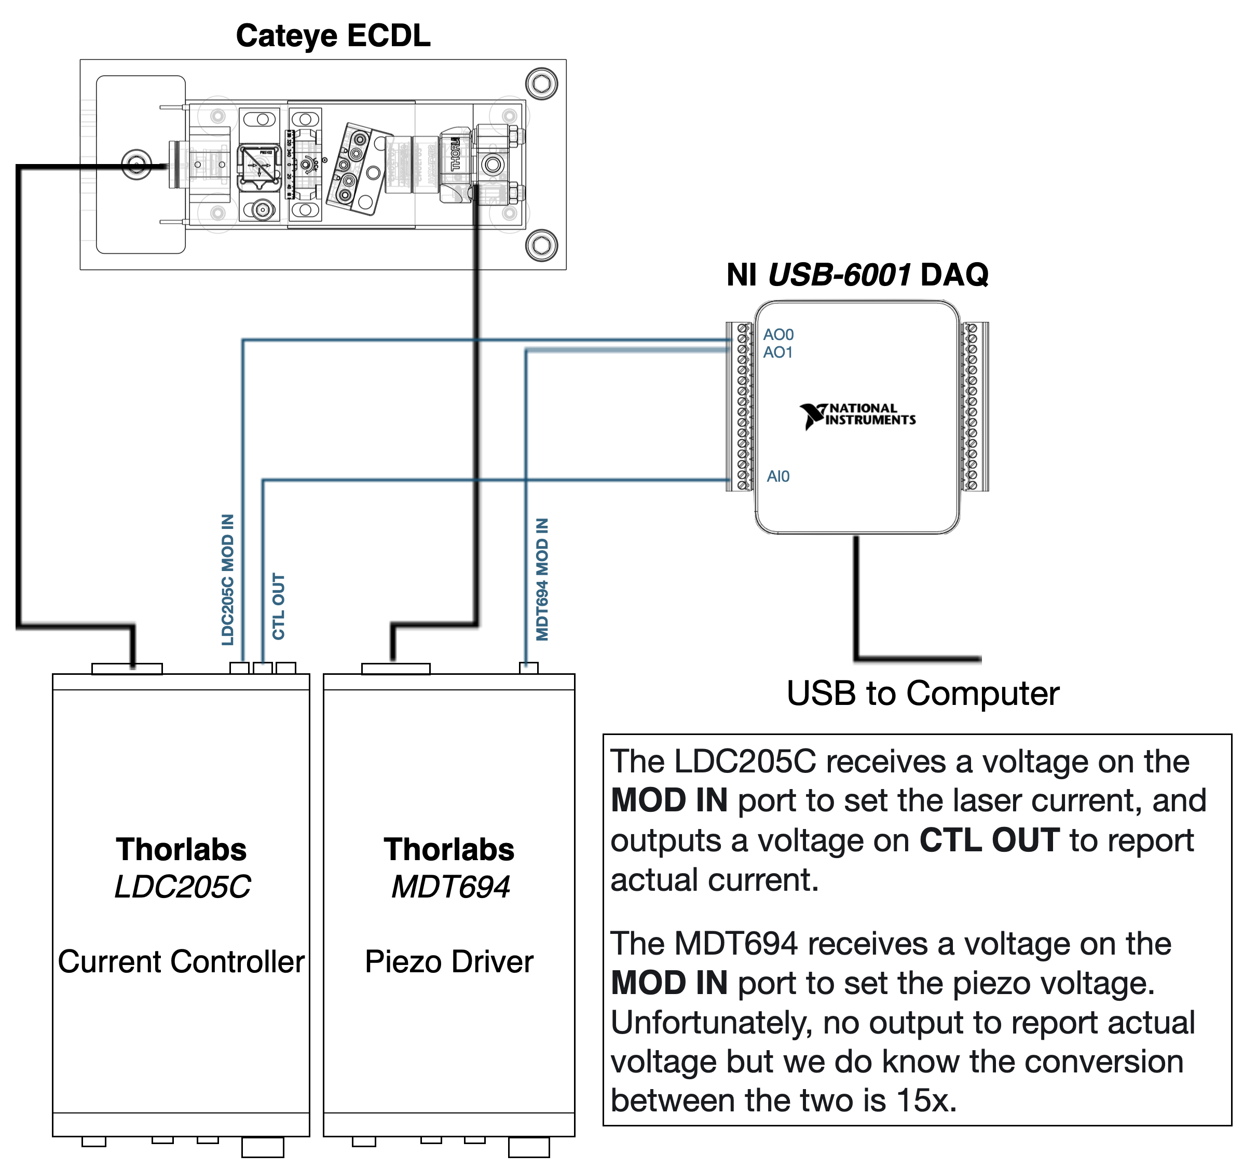
[picture p74: figure]

Figure 6: Schematics for the digital feedforward circuit

Figure 6 shows the schematics of a digital feedforward circuit. The setup uses a National Instruments USB-6001 (https://www.digikey.com/en/products/detail/ni/782602-01/12817647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) DAQ to interface with both the Thorlabs LDC205C (https://www.thorlabs.com/thorproduct.cfm?partnumber=LDC205C) current controller and the MDT694 (https://www.thorlabs.com/thorproduct.cfm?partnumber=MDT694) piezo driver, enabling complete control of the laser diode current and piezo voltage via a computer. The LDC205C receives a control voltage from DAQ output AO0 at its MOD IN port, which sets the laser diode current. The actual output current is reported via the CTL OUT port of the LDC205C, which is connected to DAQ input AI0 for real-time monitoring. The MDT694 receives a control voltage from DAQ output AO1 at its MOD IN port to set the voltage applied to the piezo. The MDT694 does not provide a feedback voltage for monitoring, but the voltage gain is known (15×), so the piezo voltage can be inferred. The DAQ is connected to a Python script (https://github.com/RobertXii/860nm-Cateye-ECDL/tree/main/Lab%20Control%20Code) via USB, which also communicates with a HighFinesse WS/7-8395 wavemeter to read the laser frequency in real time. This configuration allows for precise mapping of current vs. frequency and voltage vs. frequency, which can be very helpful when finding the optimal feedforward ratio (the ratio between input voltage from piezo driver and the modulation voltage send to the current controller) as this ratio can be easily adjusted with a minimal adjustment to the code.

### 2.3.1 Results

Laser frequency as a function of laser diode current and piezo voltage is shown in Figure 7. The y-axis in all plots represents the frequency offset ∆f from a reference value of 348.697 THz, as measured by the HighFinesse wavemeter.

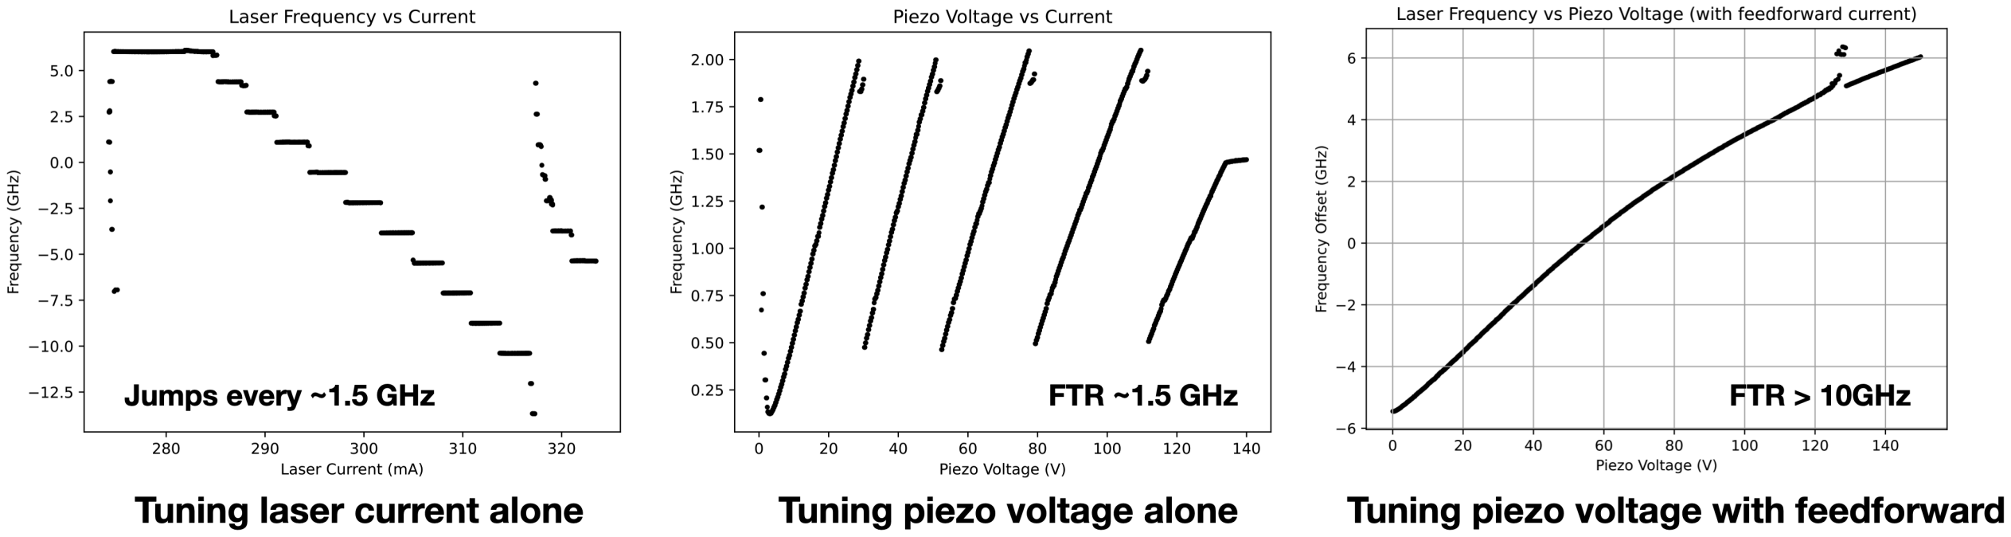
[picture p75: figure]

Figure 7: Laser output frequency as scanning laser current alone (left), scanning piezo voltage alone (middle), and scanning piezo voltage with feedforward (right)

Sweeping the laser current alone (left) gives a discrete jumps in frequency with interval aroudn 1.5 GHz, with clear mode hops occurring at regular intervals; scanning the piezo voltage alone (middle) yields a mode-hop-free tuning range (MHFTR) of approximately 1.5 GHz; simultaneous sweeping piezo voltage while adjusting the diode current proportionally (right) brings the MHFTR to above 10GHz. A larger MHFTR could be achieved in principle by using a piezo with longer displacement range, but in my case, replacing to a longer piezo with 3 times displacement range doesn’t increase the range considerably ( 15GHz).

### 2.3.2 Notes and Tips

1. Start with Low Current: To prevent potential damage from voltage spikes at startup, always begin with a low laser diode current (typically 50–100mA). Alternatively, unplug the diode before enabling DAQ control. Ensure that the current limit (ILIM) is properly configured on the LDC205C front panel.
2. Stabilization Delays: When automating wavelength scans or feedback loops, include small delays (e.g., time.sleep(0.01)) between DAQ updates to allow the wavemeter and laser to stabilize.
3. Confirming DAQ Device Name: Use the following Python snippet to identify the correct DAQ device name (e.g., Dev1), which is required for DAQ channel assignments:

import nidaqmx . system
pr int ( [ d . name for d in nidaqmx . system . System . l o c a l ( ) . d e v i c e s ] )
4. HighFinesse Wavemeter Access: When reading the laser frequency using the HighFinesse WS/7 wavemeter in Python, use the function getFrequencyNum(x, 0) with channel x = 3 or 4, depending on your wavemeter’s configuration.

### 2.4 Analog Feedforward Circuit

Unlike the digital feedforward method (implemented using Python and a DAQ), the analog approach introduces no quantization noise, making it inherently quieter and more deterministic. The core functionality of the circuit shown in Figure 8 is to linearly scale an input voltage in the range of 0–150V down to a smaller output range (e.g., 0–3.4V). This is achieved using an inverting amplifier configuration, where the gain is set by a resistor network (typically a potentiometer), allowing fine adjustment of the scaling factor to match the desired current modulation response.

Vout = kVin where k is set by a 500Ω potentiometer (e.g., a Bournes CT-23-6A dial resistor). The laser’s piezo control voltage Vpzt ∈ [0, 150 V] (from the Thorlabs MDT693A piezo driver) is used as the input Vin to a scaling circuit. The output Vout is then fed into the MOD IN R2 pin on the LDC205C current controller as in the digital circuit. This voltage adjusts the laser current with a modulation range of ±0.5A corresponding to ±10V input (i.e., 50mA/V sensitivity).

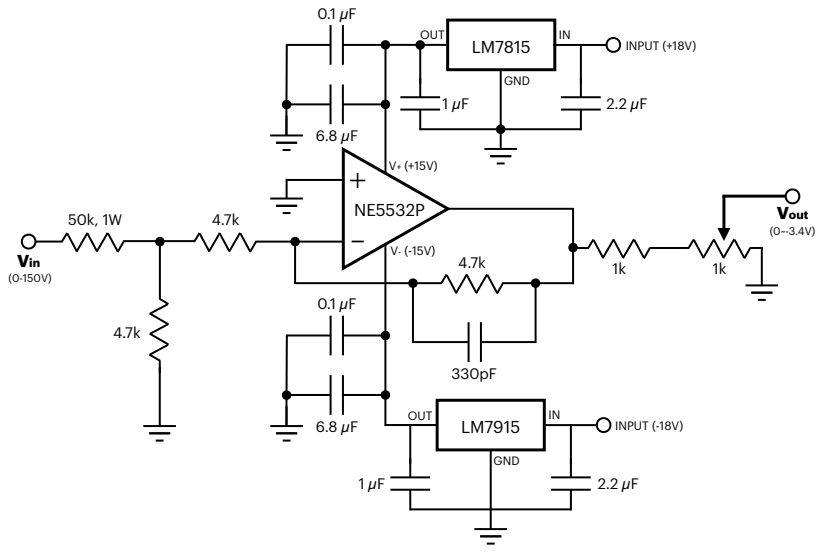
[picture p76: figure]
GND; OUT; INPUT (+18V); INPUT (-18V); Vin (0-150V); Vout (0~-3.4V)

Figure 8: Schematics for the analog feedforward electronic circuit

### 2.4.1 Determining the Feedforward Ratio

To find the appropriate scaling factor k, we first characterize the system. Based on the result presented using digital circuit, the piezo frequency sensitivity (without feedforward) is

σV =

∆f

∆Vpzt

≈

1.5 GHz
25 V
= 60 MHz/V | (7)

The current sensitivity is measured by identifying the frequency jump between two cavity modes and dividing by the change in diode current needed to cause the jump:

σI =

∆f
∆I
≈ −431 MHz/mA | (8)

To compensate for a piezo-induced frequency shift using current tuning, we require:

∆I

∆Vpzt

=

σV
σI

≈

60
−431
= −0.139 mA/V | (9)

So, for the full 150V piezo sweep:

∆I = −0.139 mA/V × 150 V = −20.9 mA | (10)

This corresponds to a maximum modulation input of:

V

max
MOD =

−20.9 mA
50 mA/V = −0.418 V | (11)

The potentiometer is then set to V

max

MOD/V max
out of its maximum value, which may be accomplished with relatively good precision by using a 10-turn potentiometer and dial scale (Bournes CT-23-6A or similar). V

max
out is the voltage at cross at the left of two 1k parallel resistor which is calculated to be -6.73V in this case. Therefore,

V

max

MOD/V max
out =

0.418
6.73
= 0.062 | (12)

### 2.4.2 Result

Below shows the piezo voltage vs. output frequency with analog feedforward scheme.

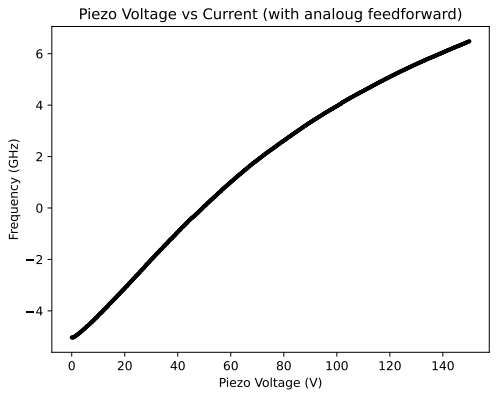
[picture p77: figure]
Piezo Voltage (V); Frequency (GHz)

Piezo Voltage vs Current (with analoug feedforward)

Figure 9: Scanning piezo voltage vs. laser output frequency with analog feedforward circuit

The nonlinearity of the peizo response can be seen from the curve. The tested piezo voltage range is 0-150V, as that is the maximum rated range for the peizo I am using. One can choose those stacked piezo rings to achieve a wider tuning range.

### 2.5 Fast Current Injection Circuit

(This part is not essential for constructing an cateye ECDL) When locking the ECDL to some specific frequency via standard technic such as PDH locking, actively feeding back the error signal to the piezo voltage may only give you a very limited locking bandwidth (few kHz). In case the experiment demands a narrow linewidth laser, locking simply via piezo feedback might not be sufficient. A fast feedback with current injection to diode directly (together with the slow piezo feedback) would be a better choice, as laser diode frequency response extremely fast to the current change. The idea is to first convert the error signal (typically a voltage) from whatever locking scheme one is using, linearly into current with some appropriate size for the diode. That is,

Ierr = CVerr

this is done with a Howland current pump circuit described below. Then the current error signal is added to the bias/DC current of the diode. Because the diode is extremely sensitive to any perturbation in the current, the circuit that achieve this functionality should be very low noise with well designed protection circuit, ground loop prevention, and high bandwidth (few MHz). To reduce the environmental noises such as EM noise, temperature or pressure fluctuations, etc. the circuit is integrated into a single compact PCB that’s able to sit inside the ECDL case. Note that, in principle, this scheme can also be done by feeding the fast error signal into the current controller (such as LDC205C) (https://www.thorlabs.com/thorproduct.cfm?partnumber=LDC205C) directly, but those current controllers typically have a lower bandwidth (100kHz in the case of LDC205C), and experimentally the laser linewidth has practically no change when sending the fast error signal through LDC.

### 2.5.1 Howland Current Pump

This webpage (https://www.allaboutcircuits.com/technical-articles/the-howland-current-pump/) has some useful information about the Howland current pump circuit. Simply put, it is a circuit with an op-amp plus a four-resistor bridge that turns an input voltage into a load current, sourcing or sinking, with the load floating at the op-amp’s + input node. By setting the four resistors to the ”balanced-bridge condition”, the input voltage and output current follows a strict linear relation no matter what the load does, and the voltage to current ratio is set by one of the resistor’s resistance. For our application, to make things easier, let’s fix the high precision resistors’ resistance to a reasonable value, then simply change the input voltage amplitude (a setting in Linien software if using Red Pitaya for generating the error signal) to change the current output scale.

### 2.5.2 The Circuit

The circuit design is mostly adapted from this paper[3]. The full circuit diagram is attached at the end of this document. Here we present two sub-modules in Figure 10 and Figure 11.

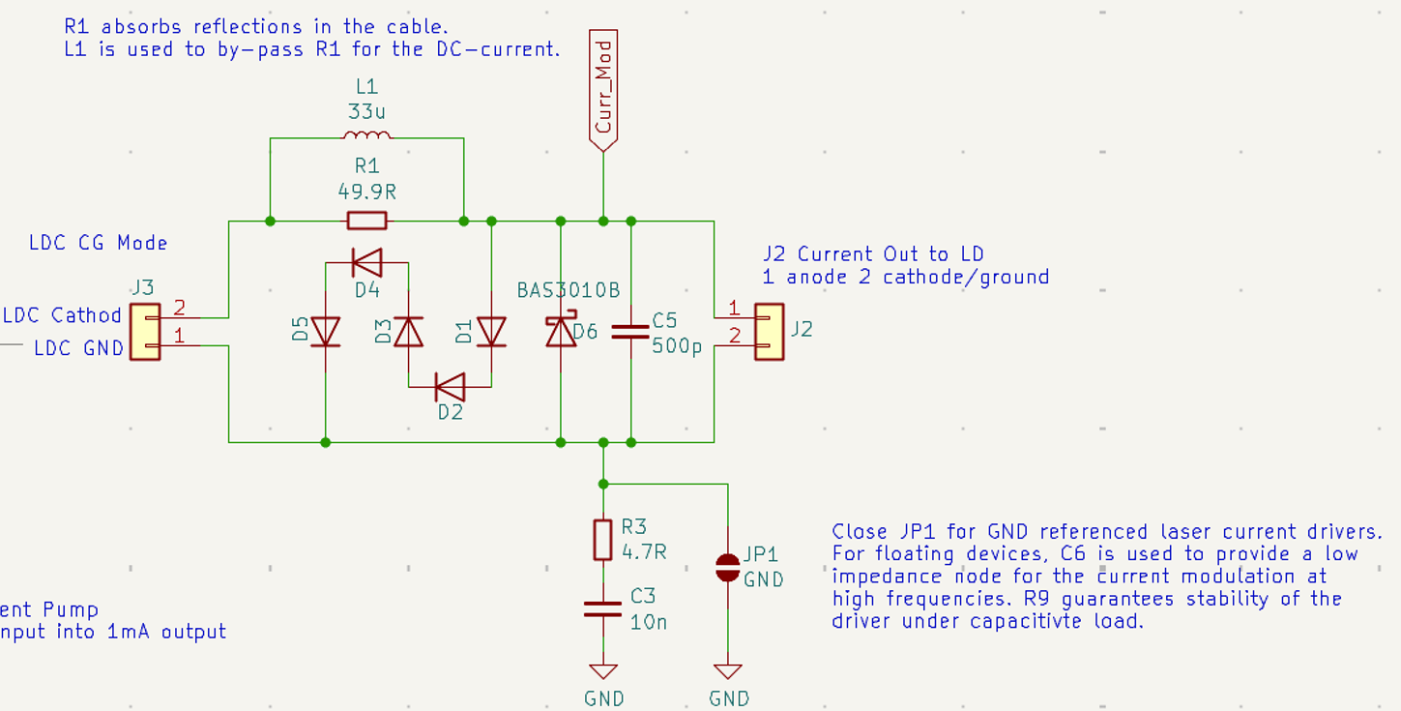
[picture p78: figure]
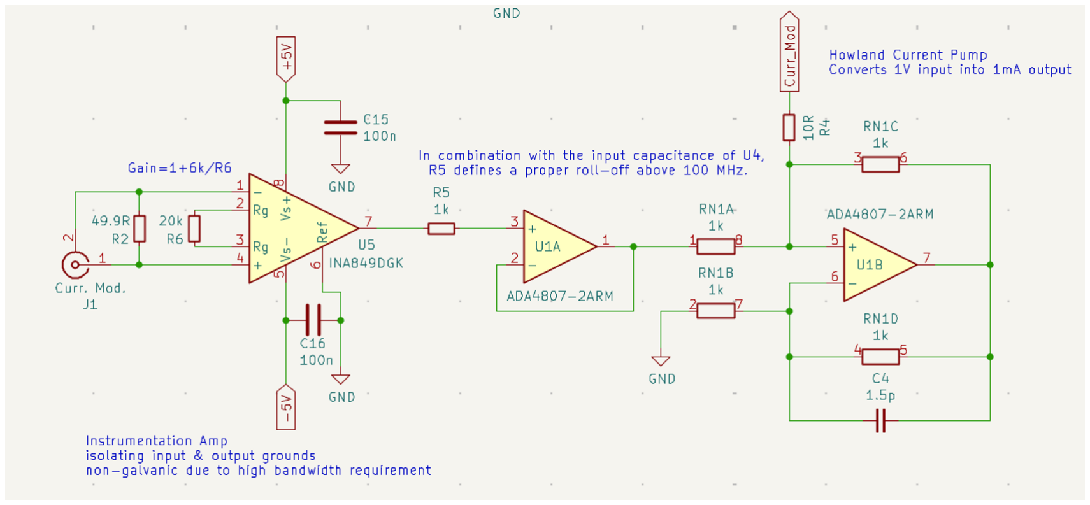
[picture p79: figure]

Figure 10: Howland Pump Module | Figure 11: Current Adding Module

A 28MHz bandwidth non-galvanic instrumentation amplifier is used for isolating the grounds between the input and output. A buffer amplifier then connects the output of the instrumentation amplifier to the Howland pump configuration, and a precise resistor network of four 1kOhm resistors was used to ensure the ”balanced-bridge condition” is met. The current output from the pump then goes into the current adding circuit shown in Figure 11. J2 represents the laser diode leads, J3 represents the LDC cathode and ground (or ground and anode depends on the diode). A RL circuit act as a AC block, so that the fast signal from the modulation current would only go through the laser diode, then go to the ground via the RC path on the bottom. This RC path also blocks the DC bias current from the LDC which effectively separates LDC loop from the modulation current loop, so that they don’t need to share the same ground, thus avoiding the ground loop. Other components consists the protection circuit for voltage limiting, reverse current prevention, and transient spikes removal. A PCB x-ray diagram is illustrated below

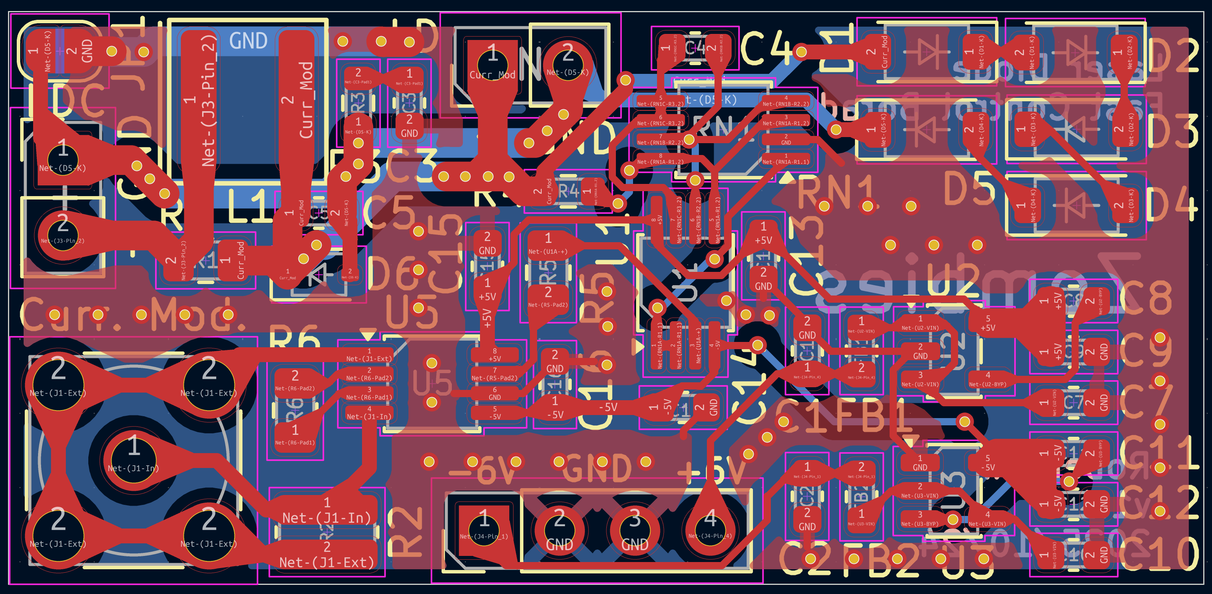
[picture p80: figure]
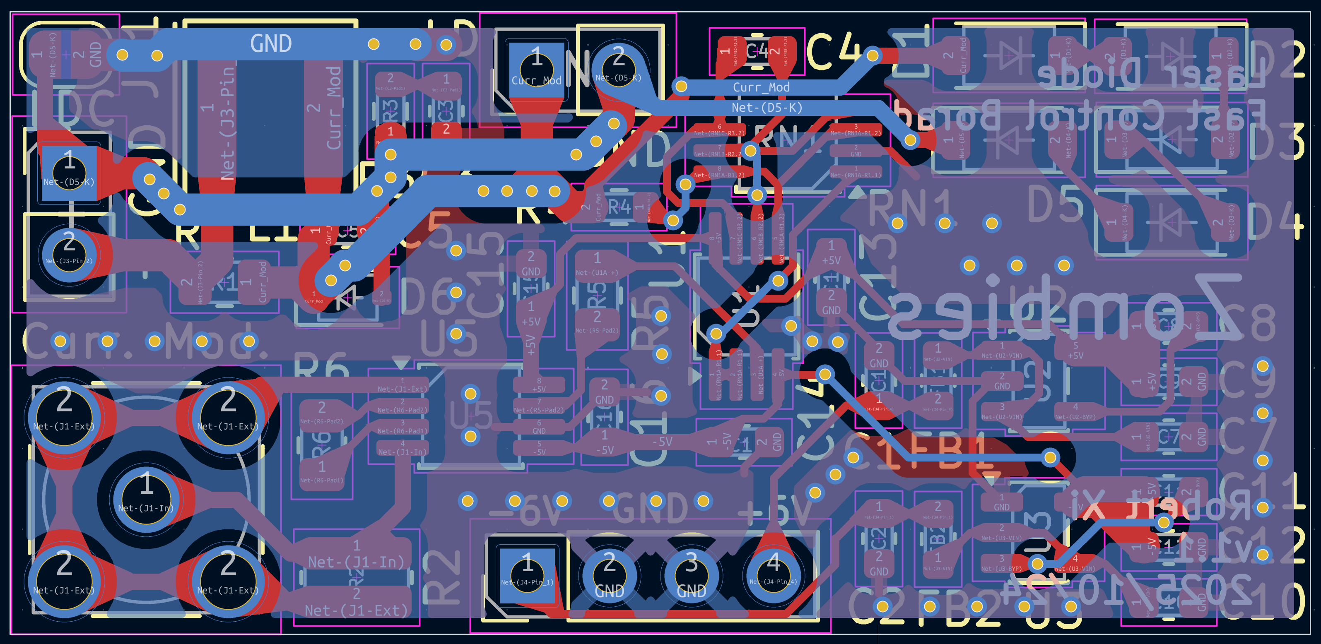
[picture p81: figure]

Figure 12: Current Injection PCB front | Figure 13: Current Injection PCB back

The performance of the circuit is examined with a Bode plot measured with a MokuLab,

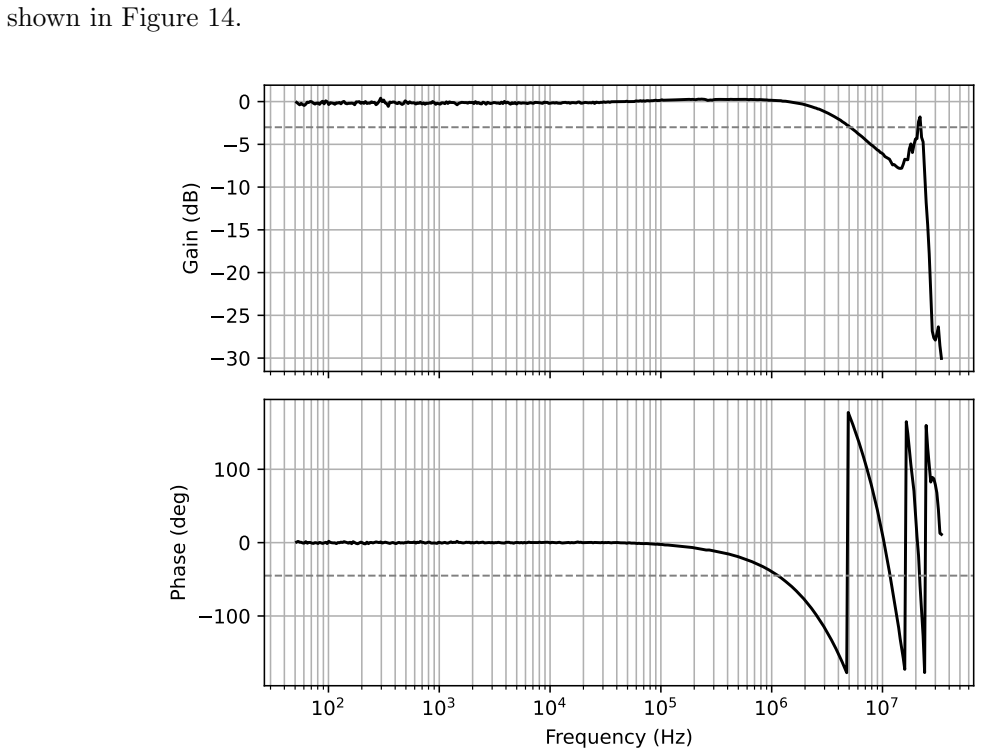
[picture p82: figure]
shown in Figure 14.; Gain (dB); Frequency (Hz); Phase (deg)

Figure 14: Bode Plot of the current injection circuit

The bandwidth of our current injection circuit is around 5MHz, which is high enough for our fast current injection control. Although, compare to the original design [3], who achieved a bandwidth of 25MHz, there’s still room for improvement, but it’s not worth the time.

### 2.5.3 Linewidth Measurement with β-Separation Line

The laser linewidth is measured with ”β-separation line” approach [2]. This is a simple way to estimate the laser short-term linewidth without relying on few kilometer long optical delay line, which is typically necessary for those traditional heterodyning or self-homodyne/heterodyne interferometry technics. With this simple approach, the short-term linewidth can be estimated with only 20m long fiber. The idea is to first obtain the PSD of the frequency noise by overlapping two lasers with identical noise properties at slightly different central frequencies and record the beat signal as a function of time using a photodiode. From this signal the time-dependent relative frequency fluctuations between the two lasers can be obtained. The absolute square of the Fourier transform of the time dependent frequency fluctuations is the PSD of the relative frequency noise between the two lasers. In our set up, the tested laser is split into two paths. One goes to a 20m long optical delay line, the other passes through an AOM driving at 80MHz. The delayed beam and shifted beam are then recombined with a PBS + polarizer at 45 degree, send into the PD. The PD signal is then mixed with a 79MHz sine wave and with a low pass filter to get a beat note frequency of 1MHz. This beat signal is then captured by the oscilloscope and analyze with computer. The optical diagram is shown in the Figure 15 below.

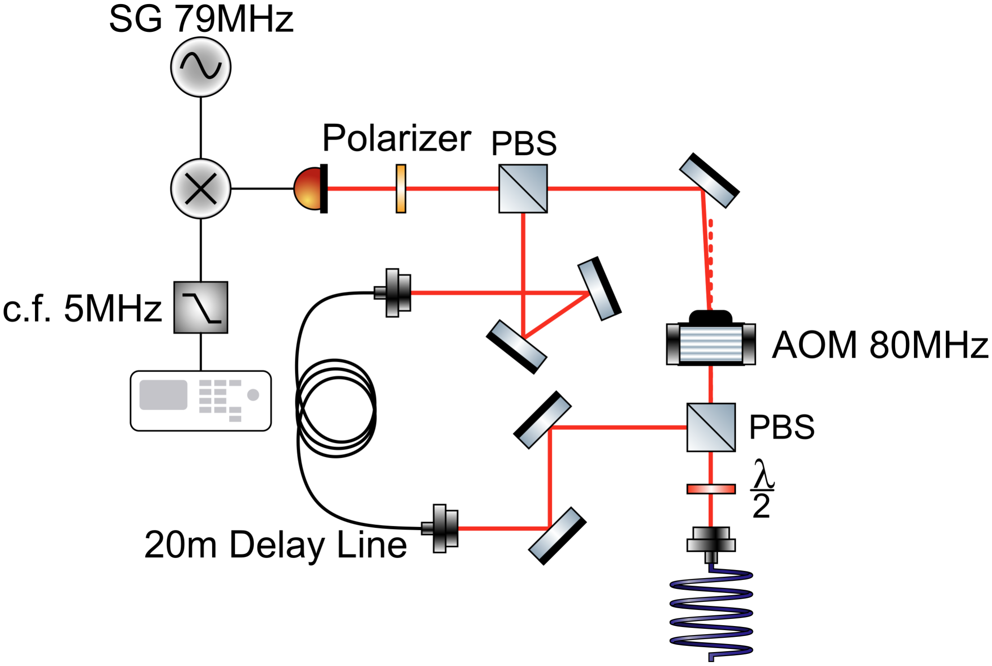
[picture p83: figure]

Figure 15: Linewidth Measurement Optical Schematic

### 2.5.4 Performance

To test the performance of the fast control with current injection on locking, we measured and compared the laser linewidth when the fast control is on and off, using a 860nm Cateye ECDL. The fast error signal is generated using a commercial analog laser servo board PI200 (https://www.koheron.com/photonics/pi200-laser-servo-controller/) from Koheron. This board has a control bandwidth of 5MHz, similar to our fast current injection circuit bandwidth. Figure 16 and 17 shows the typical PSD spectrum for the Cateye ECDL with fast control on or off.

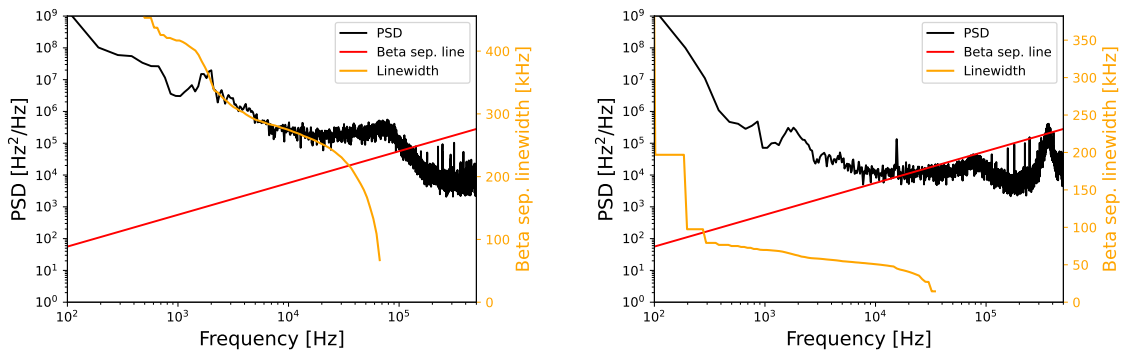
[picture p84: figure]
Frequency [Hz]; PSD Beta sep. line Linewidth; 400 Beta sep. linewidth [kHz]; 350 Beta sep. linewidth [kHz]

Figure 16: PSD spectrum measured with β-separation line method when the fast Control is off

Figure 17: PSD spectrum measured with β-separation line method when the fast Control is on

The way to read the figures above is by first finding the intersection between the PSD spectrum and the β-separation line (in red), then the integral of the PSD spectrum from that intersection frequency to any chosen lower frequency bound would correspond to the laser short-term linewidth (”short-term” is defined by the integration lower bound, i.e. if integrate from the intersection to 1kHz, short-term linewidth means within 1ms, the laser looks to have a linewidth of the integration result). The yellow curve is the integration lower bound dependent laser linewidth. The low frequency component in the PSD specturm (¡ 1kHz) is mostly the flicker noise due to the vibrations from the optical table or temperature fluctuation, etc. so it quickly blows up and loss the information about the laser linewidth. so only short-term linewidth can be estimated.
When the fast control is off, the laser is locked with only the piezo. From Figure 16, when the fast controll is off, the short-term linewidth (1ms) is around 350kHz; whereas when the fast control is turned on, as shown in Figure 17, the short-term linewidth decreases to around 50kHz.

## 3 Alignment Procedure

1. Collimating the Laser Diode: Insert the laser diode into the collimation tube and mount it onto the brass base. Remove all other components from the base, as depicted in Figure 18. Turn on the diode current (with a protection circuit) until a laser output is visible. Collimate the beam by adjusting the aspherical collimation lens with a spanner wrench to minimize spot size at the greatest possible distance (∼3m would be sufficient). Ensure the lens is securely fixed within the collimation tube when optimal collimation is achieved. If optimal collimation cannot be obtained within the available adjustment range for the lens, consider using a collimating lens with a different focal length.

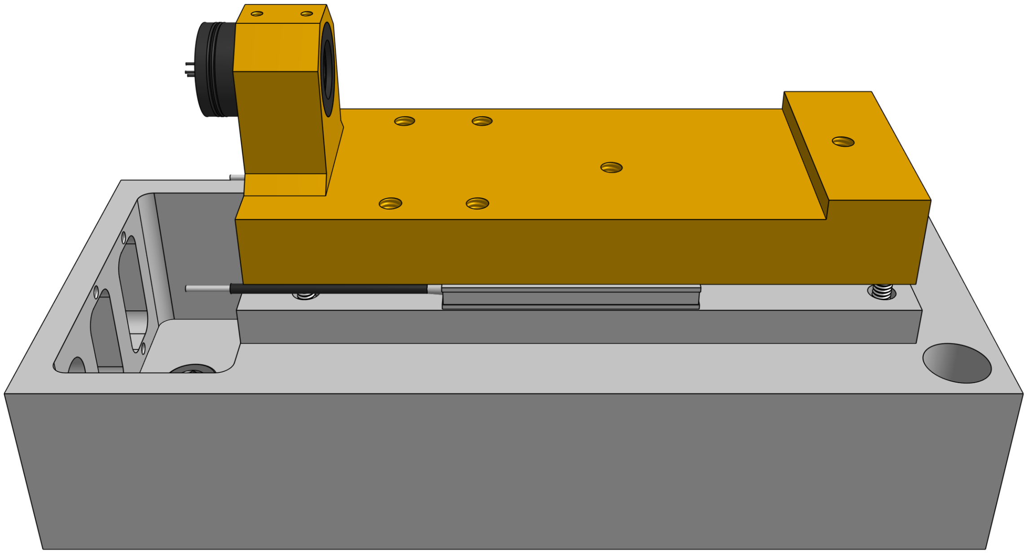
[picture p85: figure]

Figure 18: Collimating the laser diode

2. Assemble the cat-eye reflector. The assembly consists of a 1/2-inch lens tube, a 1/2-inch retaining ring, a Polaris threaded mirror mount, a ring piezo, a 7 mm mirror, a washer to back the piezo, and a collimating lens. Apply a thin layer of 5-minute epoxy to the piezo face and set the mirror centered on top. While the epoxy cures, press gently on the mirror — with a lens tissue between your finger and the surface to avoid scratching it — so that it seats parallel to the piezo face. Wrap the washer in Kapton tape for electrical insulation and epoxy it to the back of the piezo ring. Thorlabs piezos often ship with bare leads; a drop of nail polish over them prevents accidental shorts. Once everything has cured, drop the mirror/piezo/washer stack into the mirror mount and secure it with the retaining ring, which clamps against the washer. Finally, thread on the lens tube holding the collimating lens.
3. Collimating the Cateye Reflector: Reduce the diode current to just above threshold to prevent diode damage from excessive feedback. Assemble the cateye reflector (lens tube + Polaris threaded mirror mount + piezo + collimating lens) and mount it along with the beam splitter (BS) holder onto the brass base, as shown in Figure 19. Position the BS holder as close to the diode collimation tube as possible so the lens can be easily adjustments with a spanner wrench. It is recommended to choose the smallest available focal-length lens for enough space for later placing the filter. Temporarily put a nonpolarizing BS cube on to the holder. Roughly align the cateye reflector so the return beam hit onto the BS and partially reflected to the side. Tune the beam collimation by adjusting the reflector’s lens position, by looking at the reflected beam.

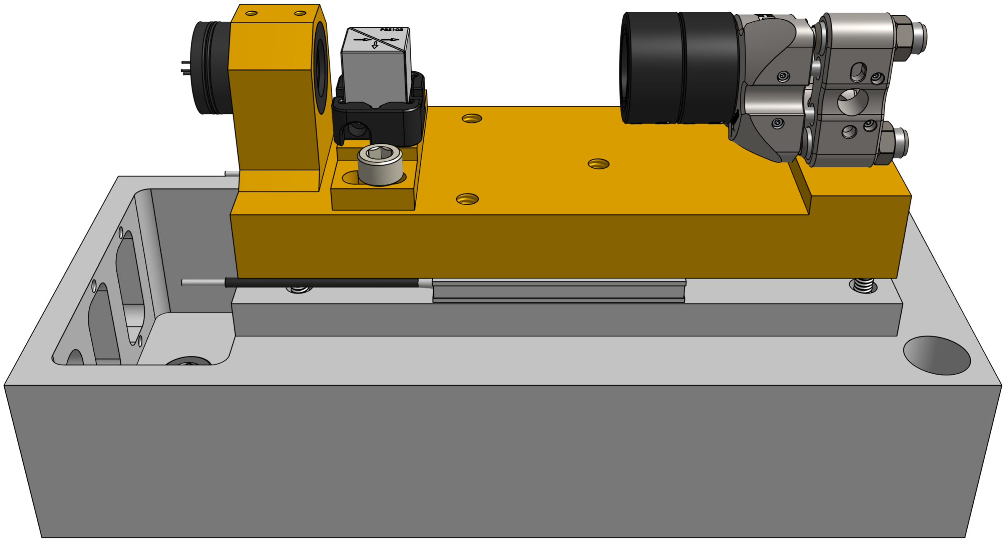
[picture p86: figure]

Figure 19: Collimating the cateye reflector

4. Aligning the Cateye Reflector for Maximum Feedback: Assemble all components on the brass base as illustrated in Figure 20. Reinstall the PBS, ensuring the filter is angled for maximum transmitted intensity. (Incorporating the filter at this stage accounts for the beam path shift caused by the filter). Set the diode current slightly above threshold current (∼1 mW output power) and place a power meter at the output. Proper feedback alignment is indicated by a significant decrease in output power (or shift in frequency if connected to a wavemeter) upon blocking the feedback beam (cateye reflector). If not observed, refine alignment by adjusting the cateye reflector’s pitch and roll or rotate the half-wave plate (HWP). (If necessary, use an card with a small aperture for coarse alignment). Then, rotate the HWP until most of the power goes to the output to prevent strong feedback broke the diode.

Note: During this process, when turn up the laser diode’s current, a counterintuitive increase in output power may be observed when the feedback path is blocked. This effect may arise due to a mismatch in polarization between the incident and feedback beams. Although the laser diode typically exhibits strong polarization-dependent gain, sufficiently strong feedback can alter the polarization state of the emitted beam. This change in polarization can change the power distribution at the output. Thus, this phenomenon is likely diode-dependent and may vary significantly across different diodes.

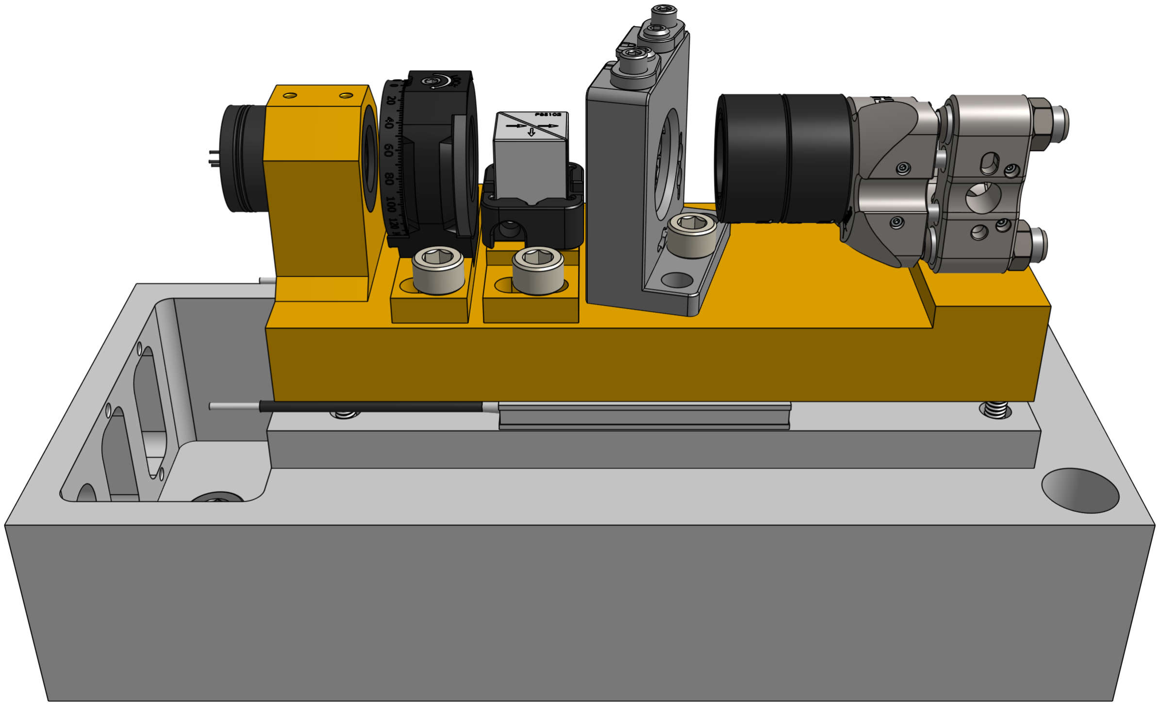
[picture p87: figure]

Figure 20: Cateye reflector alignment for maximum feedback.

5. Adjusting the Half-Wave Plate (HWP) Angle: Set up downstream optics such as an isolator, coupling mirrors, and fiber-coupling components, etc. Connect the fiber output to a wavemeter and Fabry–Perot cavity. Slowly rotate the HWP angle until a stable single-mode is observed. An indicator of a good optical feedback is a shift in laser frequency when the cateye reflector is blocked, or varying the laser diode current (without feedforward) should result in discrete frequency steps. If neither of these behaviors is observed, repeat the previous alignment procedure.
6. Tuning Laser Frequency: Set the diode current to its recommended operating current. (Remember to set the current limit on the current controller to be slightly smaller than the max current rating on the diode’s data sheet). Temporarily block the cateye reflector to determine the diode’s free-running wavelength. Adjust ECDL temperature until the free-running frequency of the diode is closest to the target frequency. Then, unblock the cateye reflector and tune the filter angle for maximum filter transmission. Adjustments the filter angle to coarse tuning the frequency. One should be able to see the frequency to jump in smallest unit around 3GHz. Fine tune the diode current until the frequency is within 1GHz to the target frequency. Final precise tuning to the desired frequency is achieved through tuning the piezo voltage.
7. Implementing Feedforward: Detailed instructions on the analog feedforward circuit and its implementation are provided in Section 2.4.

### 3.1 Troubleshooting

1. Flat Fabry-Perot Cavity Signal: When coupling the laser into the cavity to find a single-mode, you may occasionally observe a flat, noise-like signal, even though it’s clear the laser intensity hitting on the PD is non-zero. This is likely due to excessive optical feedback. Try rotating the laser diode’s input polarization/angle, as a simple calculation shows that the input polarization influences the effective feedback. This can be easily seen as the feedback from the cateye is always vertically polarized. If the problem persists, introduce a slight intentional misalignment of the cateye to further lower the feedback intensity.
2. Temperature Fluctuation: Achieving stable PID temperature control has been challenging, probably because the thermistor was originally 0.6 in away from the TEC which makes the response time large. We used Brass 360 in the original design, whose thermal conductivity is moderate; an aluminum base should perform better. In the revised design the thermistor hole is closer to the TEC, though this version has not yet been tested. Qian tried with aluminum and observed that when placing the thermistor near the diode (farther from the TEC) leads to temperature oscillations, whereas placing it near the TEC enables stable control after tuning.

## A Part List

The following list includes only the components required to construct the ECDL itself. It does not cover downstream optics such as optical isolators, fiber coupling assemblies, or diagnostics, as well as the circuits.

A.1 | Hardware (Wavelength Independent)
Item | Part Number | Supplier | Quant. | Unit Cost
Laser Diode Socket | S7060R (https://www.thorlabs.com/thorproduct.cfm?partnumber=S7060R) | Thorlabs | 1 | $7.49
Lens Cell Adapter | S05TM09 (https://www.thorlabs.com/thorproduct.cfm?partnumber=S05TM09#ad-image-0) | Thorlabs | 1 | $23.68
Lens Tube with External Thread | SM05L05 (https://www.thorlabs.com/thorproduct.cfm?partnumber=SM05L05) | Thorlabs | 1 | $16.32
Filter Mount | SM05L05 (https://www.newport.com/p/HVM-05r?srsltid=AfmBOorxKivPpBBCywn9TjpTx-atgNcp1ocA68YFlJeEq3S4IZkL5xkn) | Newport | 1 | $209.00
Beamsplitter Platform | BSH10 (https://www.thorlabs.com/thorproduct.cfm?partnumber=BSH10) | Thorlabs | 1 | $49.85
Threaded Mirror Mount | POLARIS-K05T6 (https://www.thorlabs.com/thorproduct.cfm?partnumber=POLARIS-K05T6#ad-image-0) | Thorlabs | 1 | $208.47
HWP Rotation Mount | RSP05 (https://www.thorlabs.com/thorproduct.cfm?partnumber=RSP05#ad-image-0) | Thorlabs | 1 | $89.72
Thermoelectric | CP60440 (https://www.digikey.com/en/products/detail/same-sky-formerly-cui-devices/CP60440/1747370) | DigiKey | 1 | $24.22
Thermistor | TH10K (https://www.thorlabs.com/thorproduct.cfm?partnumber=TH10K) | Thorlabs | 1 | $5.32
Piezo Ring Chip | PA44LEW (https://www.thorlabs.com/thorproduct.cfm?partnumber=PA44LEW) | Thorlabs | 1 | $95.96
Discrete Piezo Ring Stack | PK44LA2P2 (https://www.thorlabs.com/thorproduct.cfm?partnumber=PK44LA2P2) | Thorlabs | 1 | $155.77
Acrylic Sheet | 8560K279 (https://www.mcmaster.com/8560K279/) | McMaster | 1 | $21.85
Custom Al and Brass Parts | | Xometry | 1 | ∼$400.00
A.2 | Optical Parts (Wavelength Dependent)

Note: The part list provided in this section is wavelength dependent. Please select components appropriate for your target wavelength. The items listed here are intended as an example for a ECDL operating at 860nm. At this wavelength, some parts requires some efforts to get, such as the laser diode and filters.

Item | Part Number | Supplier | Quant. | Unit Cost
Laser Diode | QLD-850-350S (http://www.qphotonics.com/Single-mode-laser-diode-350mW-850nm-QLD-850-350S.html) | Qphotonics | 1 | $240.00
Interference Filter | 866-1.2 OD6 | Alluxa | 1 | $3,325.00
Collimating Lens, f = 3.1 mm | C330TMD-B (https://www.thorlabs.com/thorproduct.cfm?partnumber=C330TMD-B) | Thorlabs | 1 | $104.03
Collimating Lens, f = 11.00 mm | A220TM-B (https://www.thorlabs.com/thorproduct.cfm?partnumber=A220TM-B) | Thorlabs | 1 | $105.82
PBS Cube | PBS102 (https://www.thorlabs.com/thorproduct.cfm?partnumber=PBS102) | Thorlabs | 1 | $237.69
HWP | WPH05ME-850 (https://www.thorlabs.com/thorproduct.cfm?partnumber=WPH05ME-850) | Thorlabs | 1 | $311.54
Ø7.0 mm Thin Mirror | BB03-E03 (https://www.thorlabs.com/thorproduct.cfm?partnumber=BB03-E03) | Thorlabs | 1 | $49.85
BS Cube | BS011 (https://www.thorlabs.com/thorproduct.cfm?partnumber=BS011) | Thorlabs | 1 | $219.89
Collimation Tube for diode | LT230P-B (https://www.thorlabs.com/thorproduct.cfm?partnumber=LT230P-B) | Thorlabs | 1 | $193.67

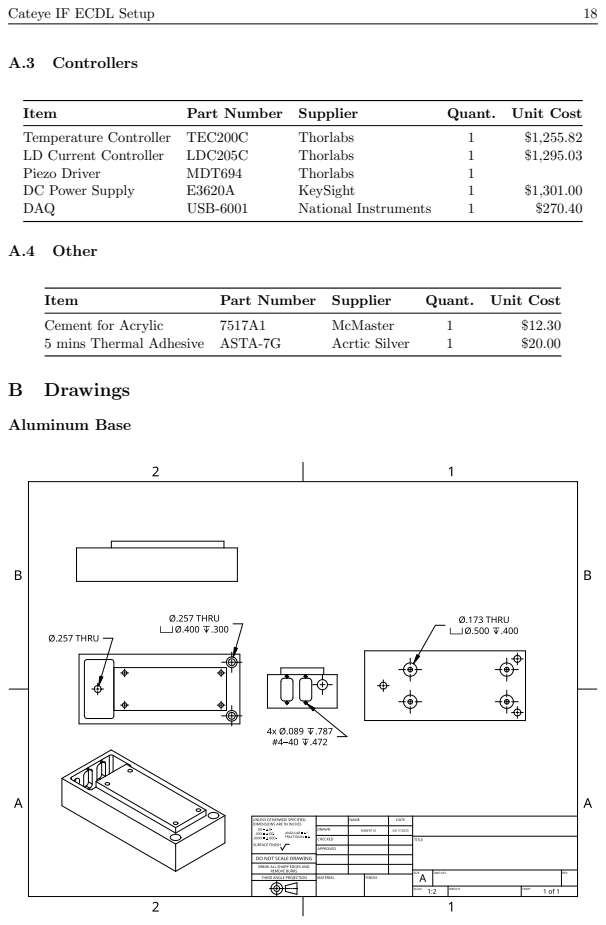
[picture p88: page 19]
Controllers; Item; Part Number; Supplier; Quant.; Unit Cost; Temperature Controller; TEC200C; Thorlabs; LD Current Controller; LDC205C; Piezo Driver; MDT694; DC Power Supply; KeySight; DAQ; USB-6001; National Instruments; Other; Cement for Acrylic; McMaster; 5 mins Thermal Adhesive; ASTA-7G; Acrtic Silver; B Drawings; Aluminum Base

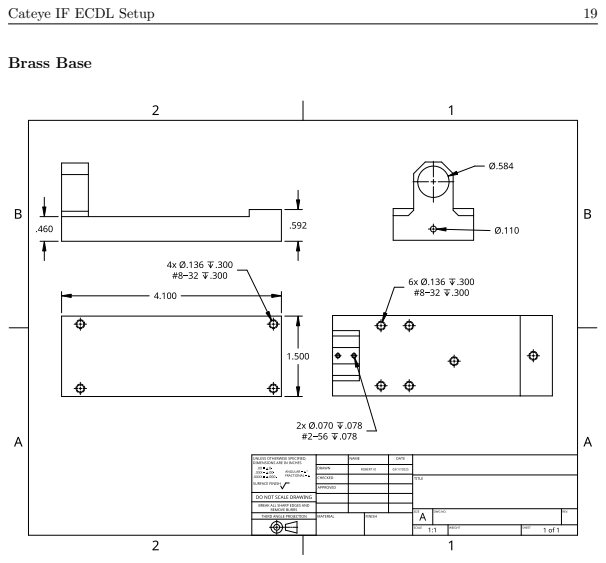
[picture p89: page 20]
Brass Base

Fast Control Circuit Diagram

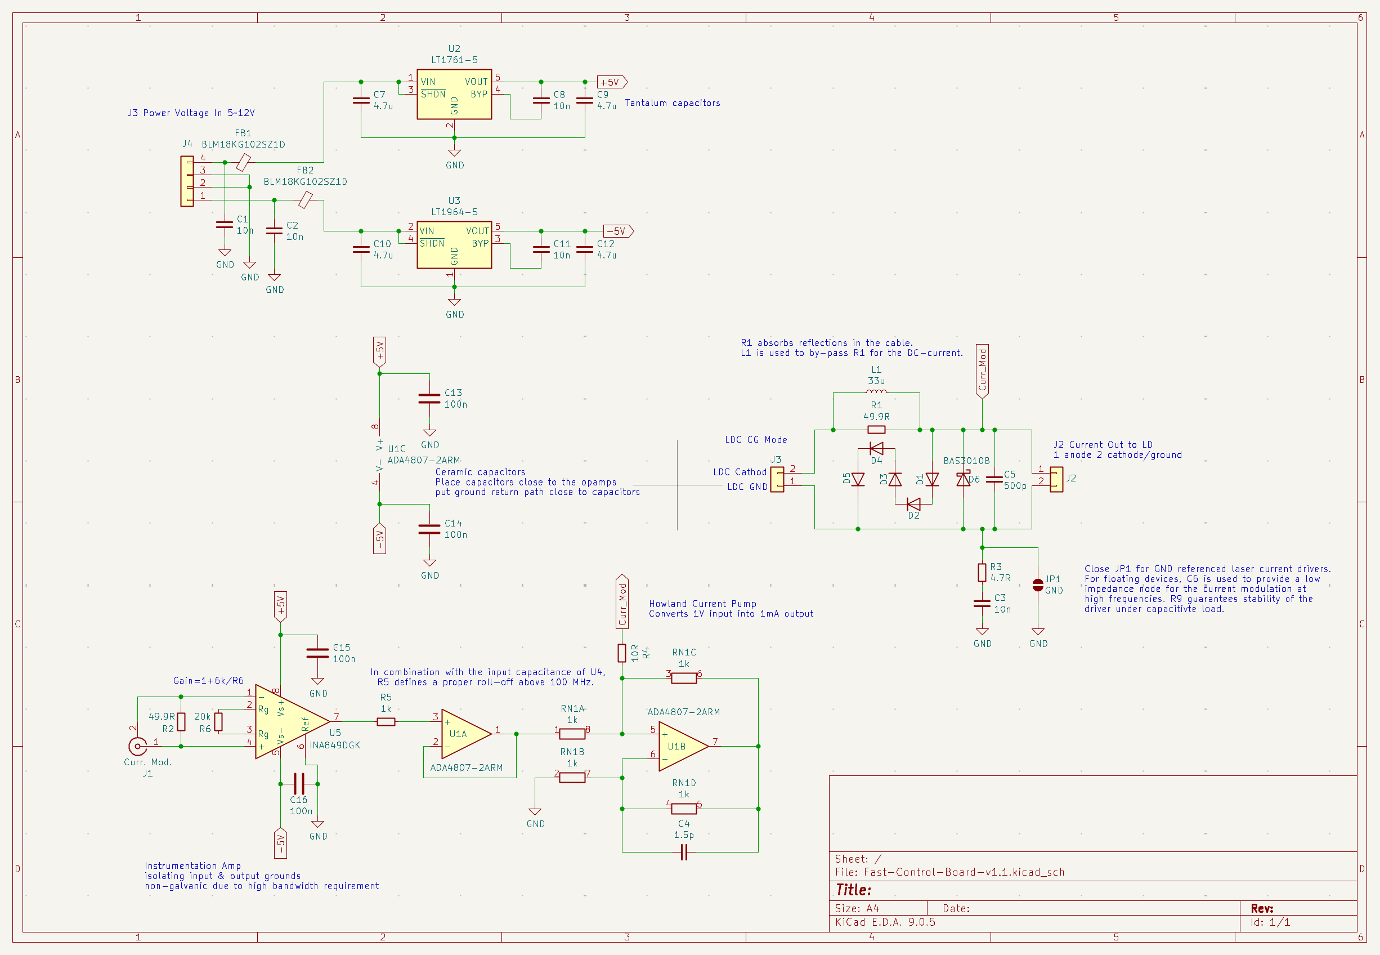
[picture p90: figure]

## References

[1] X. Baillard, A. Gauguet, S. Bize, P. Lemonde, Ph. Laurent, A. Clairon, and P. Rosenbusch. Interference-filter-stabilized external-cavity diode lasers. Optics Communications, 266(2):609–613, October 2006.
[2] Gianni Di Domenico, St´ephane Schilt, and Pierre Thomann. Simple approach to the relation between laser frequency noise and laser line shape. Appl. Opt., 49(25):4801–4807, Sep 2010.
[3] Tilman Preuschoff, Patrick Baus, Malte Schlosser, and Gerhard Birkl. Wideband current modulation of diode lasers for frequency stabilization. Review of Scientific Instruments, 93(6):063002, 06 2022.
[4] Daniel J. Thompson and Robert E. Scholten. Narrow linewidth tunable external cavity diode laser using wide bandwidth filter. Review of Scientific Instruments, 83(2):023107, 02 2012.
