RobertXii/860nm-Cateye-ECDL/Data Sheets & Manual/9973 - Utah State 866-1.2 OD6 Ultra Narrow BP.xls

Internal Spec: 9973
Part Number: Q210-12172 Rev2-866
Description: 866-1.2 OD6 Ultra Narrow BP
Optical | Units | Specification | Tolerance | Notes
Filter Type | - | Ultra Narrow Bandpass | -
Cone Half Angle | Degrees | 5
Angle of Incidence | Degrees | 0
Polarization | - | Average | -
Center Wavelength | nm | 866 | +/- 0.5
Full Width Half Maximum (50% BW) | nm | <= 1.2 | <= 1.2
Transmission @ Peak |  | > 85.0 %T Abs | > 85.0 %T Abs
Blocking Range | nm | 200 to 847.6 | > 6.0 (0.0001) OD Avg
Blocking Range | nm | 884.4 to 1200 | > 6.0 (0.0001) OD Avg
Blocking Range | nm | 200 to 847.6 | > 5.0 (0.001) OD Abs
Blocking Range | nm | 884.4 to 1200 | > 5.0 (0.001) OD Abs
Design Notes | - | 4-cavity | -
Physical / Mechanical
Material | - | Fused Silica | -
Substrate Thickness | mm | 2.98
Transmitted Wavefront Distortion/Error | rms | < 0.1 @ 632.8nm |  | Per inch
Surface Quality | - | 80/50 | - | Best Effort 60/40
Finished Product
Glass Element Size | mm | 87.5 | +/- 0.05
Clear Aperture | mm | 83.9
Assembly Diameter | mm | 88.9 | +/- 0.1
Assembly Thickness | mm | 5 | +/- 0.1
Ring Material | - | Black Anodized Al | -
Ring # | - | 30142 | -
Washer # | - | 30143 | -
Painting | - | Edges Black | -
Marking | - | 866-1.2 nm ↑ | -
Marking Orientation | - | |¯¯TEXT¯¯| | -
Caret Direction | - | Side 1 (BP) | -
Mounting Direction | - | |______v_| | -
Edge Chip | mm |  | < 0.5
