RobertXii/860nm-Cateye-ECDL/Data Sheets & Manual/Edmund Filter Raw Data.xlsx

Sheet: Data 1
Wavelength (nm) | %Transmission
200 | 1e-05
201 | 4e-05
202 | 0.00047
203 | 0.00075
204 | 0.00086
205 | 0.00058
206 | 0.00046
207 | 0.00032
208 | 0.00026
209 | 0.00013
210 | 3e-05
211 | 0
212 | 0
213 | 0
214 | 0
215 | 0
216 | 0
217 | 0
218 | 0
219 | 0
220 | 0
221 | 0
222 | 0
223 | 0
224 | 0
225 | 0
226 | 0
227 | 0
228 | 0
229 | 0
230 | 0
231 | 0
232 | 0
233 | 0
234 | 0
235 | 0
236 | 0
237 | 0
238 | 0
239 | 0
240 | 0
241 | 0
242 | 2e-05
243 | 1e-05
244 | 0
245 | 0
246 | 0
247 | 0
248 | 0
249 | 0
250 | 0
251 | 0
252 | 0
253 | 0
254 | 0
255 | 0
256 | 0
257 | 0
258 | 0
259 | 0
260 | 0
261 | 1e-05
262 | 0
263 | 2e-05
264 | 2e-05
265 | 4e-05
266 | 7e-05
267 | 2e-05
268 | 3e-05
269 | 9e-05
270 | 9e-05
271 | 6e-05
272 | 0.00019
273 | 0.00062
274 | 0.00361
275 | 0.00683
276 | 0.01035
277 | 0.01002
278 | 0.01333
279 | 0.01257
280 | 0.00554
281 | 0.0038
282 | 0.00234
283 | 0.0059
284 | 0.00191
285 | 0.00022
286 | 3e-05
287 | 4e-05
288 | 0.00015
289 | 0.00024
290 | 0.00023
291 | 0.00019
292 | 0.00013
293 | 7e-05
294 | 4e-05
295 | 2e-05
296 | 0
297 | 0
298 | 0
299 | 0
300 | 0
301 | 0
302 | 0
303 | 0
304 | 0
305 | 0
306 | 0
307 | 0
308 | 0
309 | 0
310 | 0
311 | 0
312 | 0
313 | 0
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
