RobertXii/860nm-Cateye-ECDL/Data Sheets & Manual/QPhotonics Diode Raw Data.xls

Sheet: Sheet1
QPHOTONICS, LLC |  |  |  | 3830 Packard Road, Suite 170, Ann Arbor, MI 48108, USA |  | Phone: 734-477-0133 Fax: 734-477-0166 Email: info@qphotonics.com http://www.qphotonics.com
MODEL |  |  | QLD-850-350S
PART NUMBER |  |  | LU2311LD-1
 |  | None
Parameter |  |  | Value | Units
Case Temperature |  |  | 25 | °C
Optical Output Power |  |  | 350.7 | mW
Threshold Current |  |  | 50 | mA
Operating Current |  |  | 358 | mA
Maximum Operating Current |  |  | 394 | mA
Operating Voltage |  |  | 2.21 | V
Monitor Current |  |  | 0 | mA
Center Wavelength |  |  | 853.7 | nm
Spectral Width |  |  | 0.2 | nm
 |  |  |  |  | NOTE
 |  |  |  |  | This type of laser diodes must be used with temperature controlled mount.
 |  |  |  |  |  | 0.14
 | Pin | Connection
 | 1 | LD Cathode
 | 2 | N/A
 | 3 | LD Anode
Operator |  | RL
Date |  | 2023-11-13
 |  |  |  |  | BOTTOM VIEW
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
