RobertXii/860nm-Cateye-ECDL/Data Sheets & Manual/Alluxa 860nm filter transmission.png

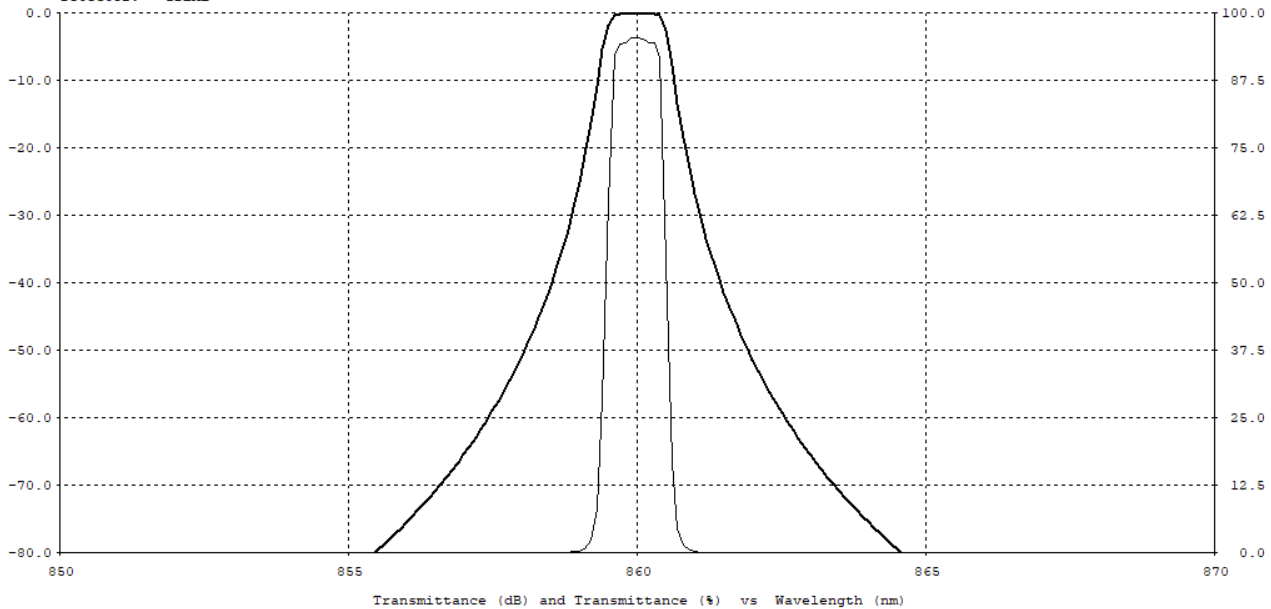
Data Sheets & Manual/Alluxa 860nm filter transmission.png
