RobertXii/860nm-Cateye-ECDL/ECDL Gain Simulation/Figure/overall Transmission Demo Zoom.pdf

859.71000 nm

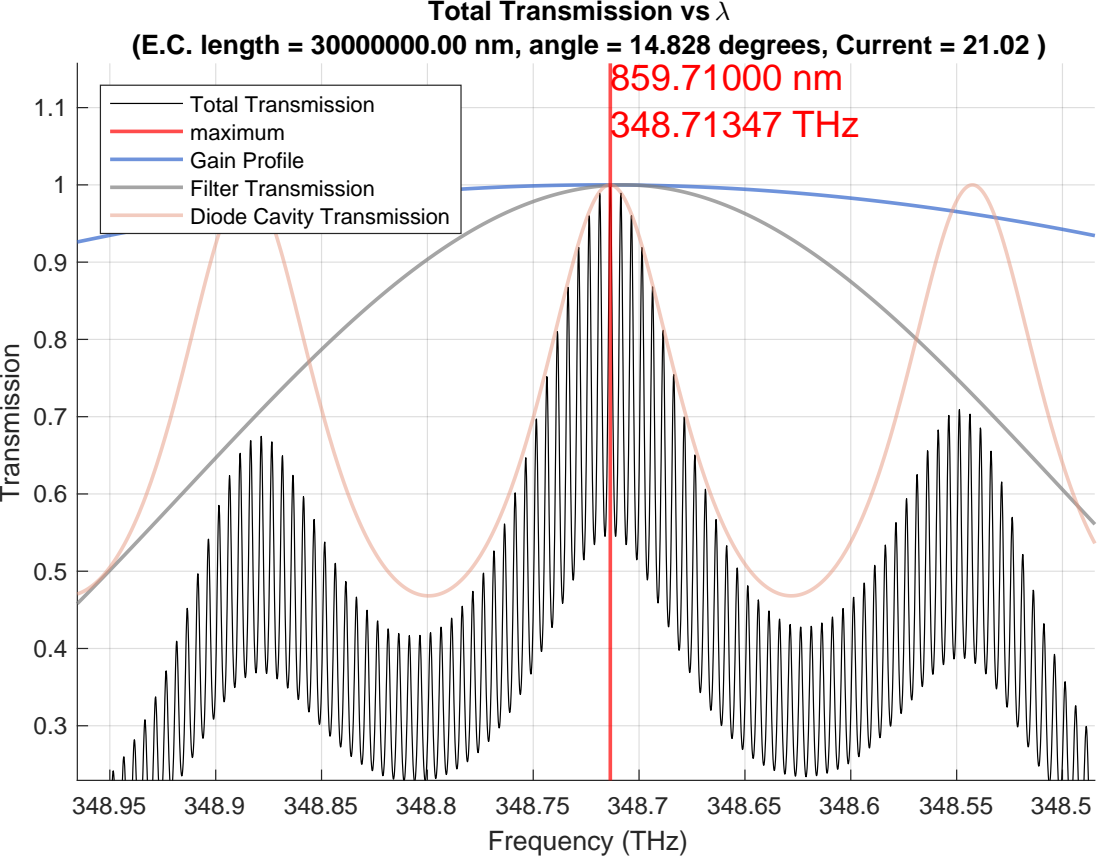
[picture p92: page 1]
Frequency (THz); Transmission

Total Transmission vs 6

(E.C. length = 30000000.00 nm, angle = 14.828 degrees, Current = 21.02 )

348.71347 THz Total Transmission
maximum
Gain Profile
Filter Transmission
Diode Cavity Transmission
