RobertXii/860nm-Cateye-ECDL/ECDL Gain Simulation/Figure/overall Transmission Demo.pdf

859.71000 nm

## 348.71347 THz

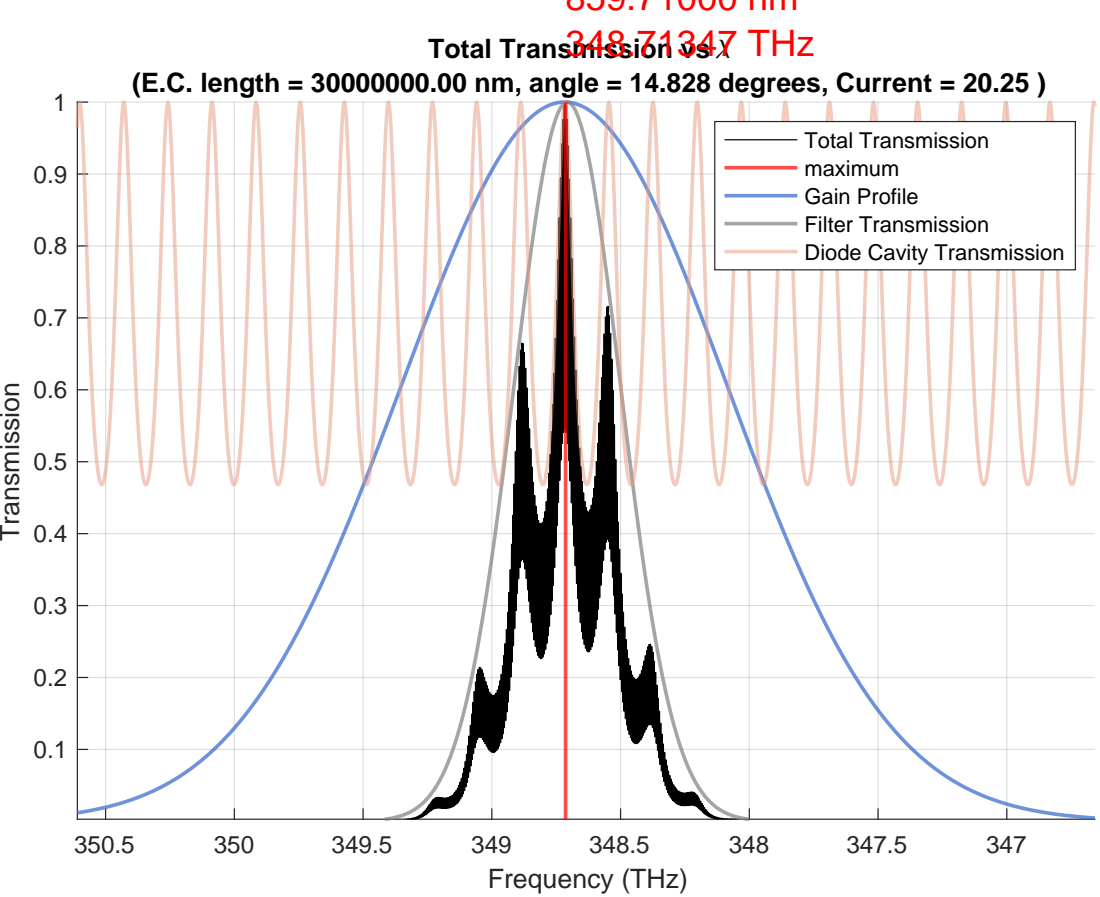
[picture p93: page 1]
Frequency (THz); Transmission

Total Transmission vs 6

(E.C. length = 30000000.00 nm, angle = 14.828 degrees, Current = 20.25 )

Total Transmission
maximum
Gain Profile
Filter Transmission
Diode Cavity Transmission
