RobertXii/860nm-Cateye-ECDL/CAD/New ECDL Design/Al Base Drawing.pdf

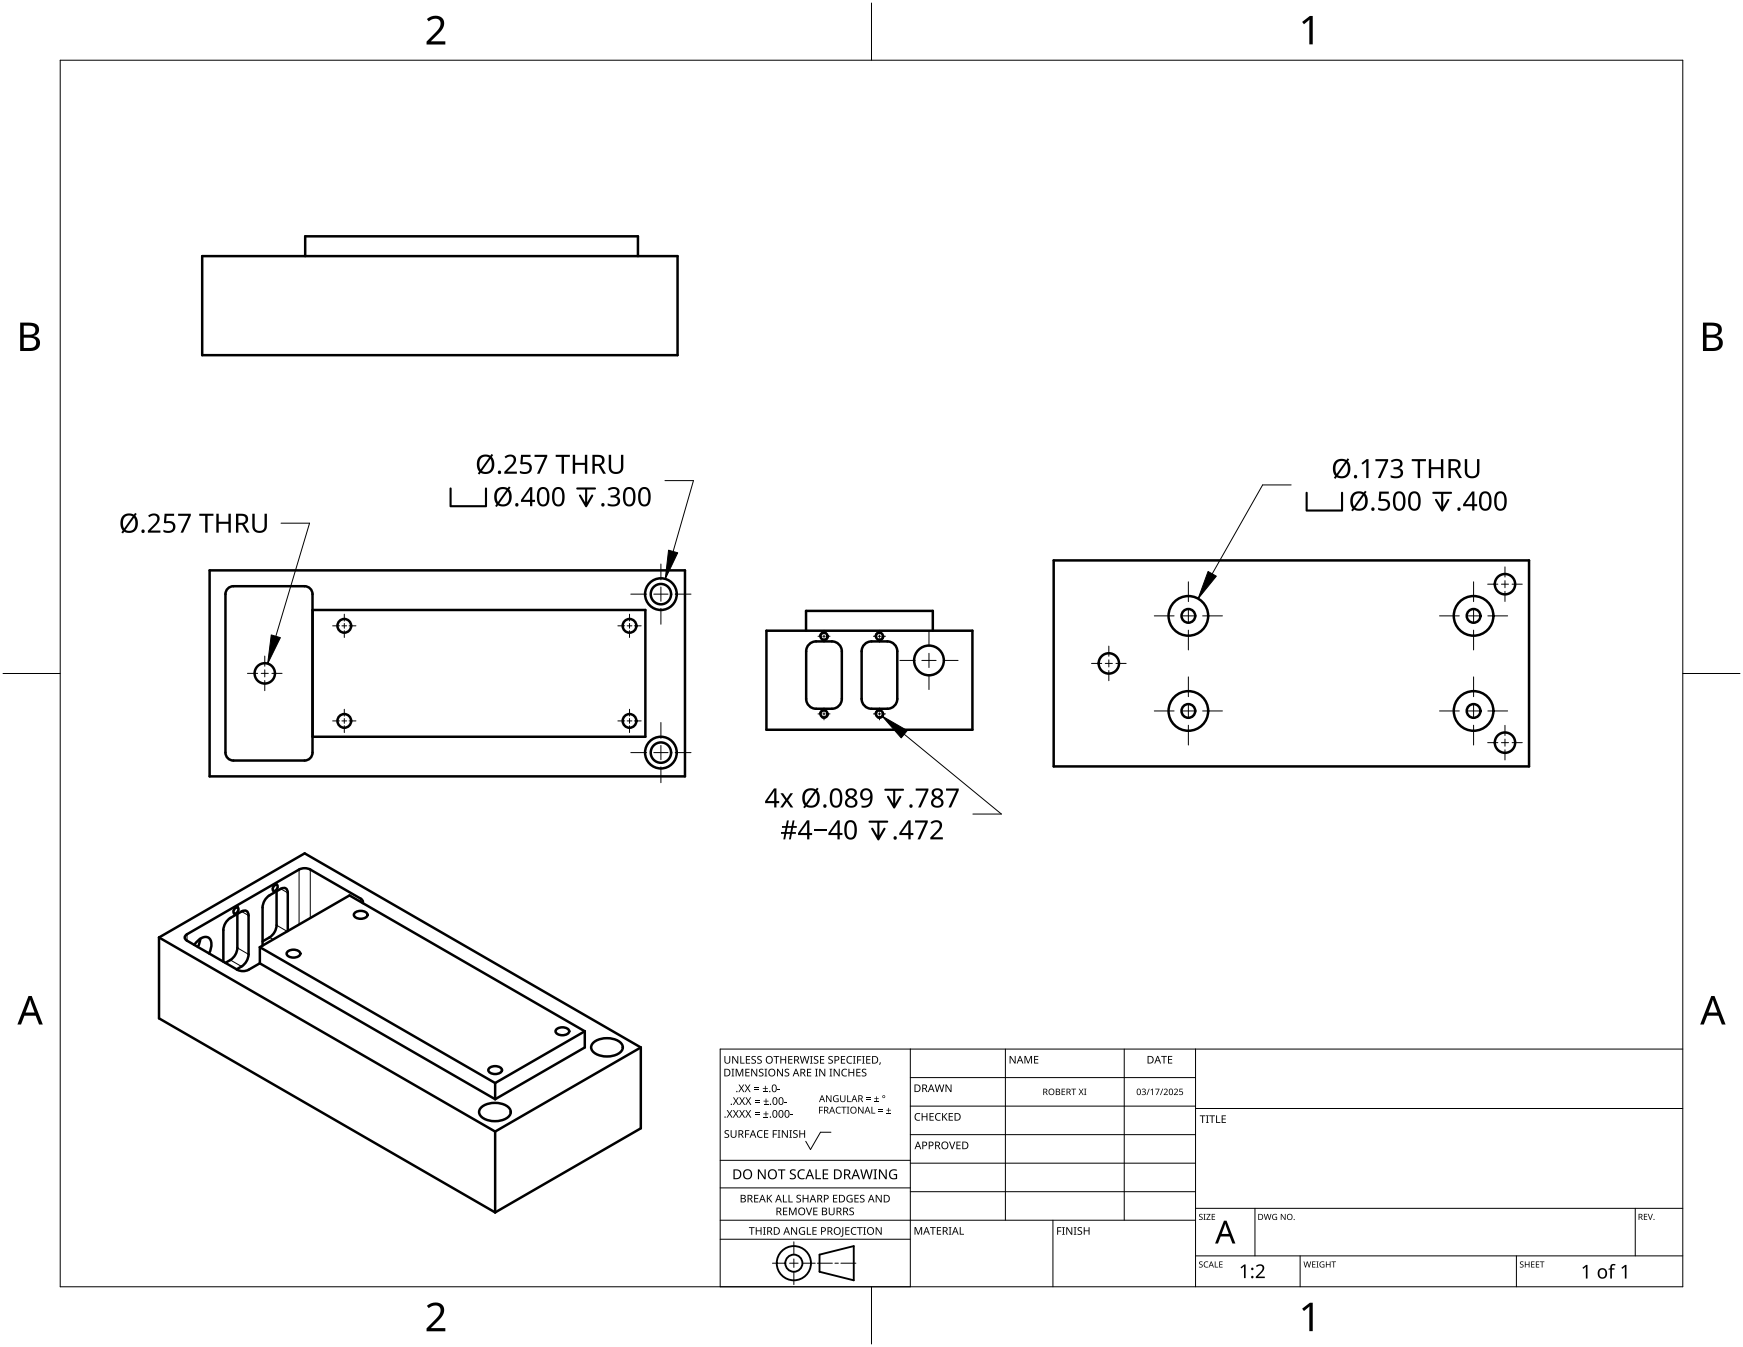
[picture p94: page 1]
