RobertXii/860nm-Cateye-ECDL/CAD/New ECDL Design/Brass base drawing.pdf

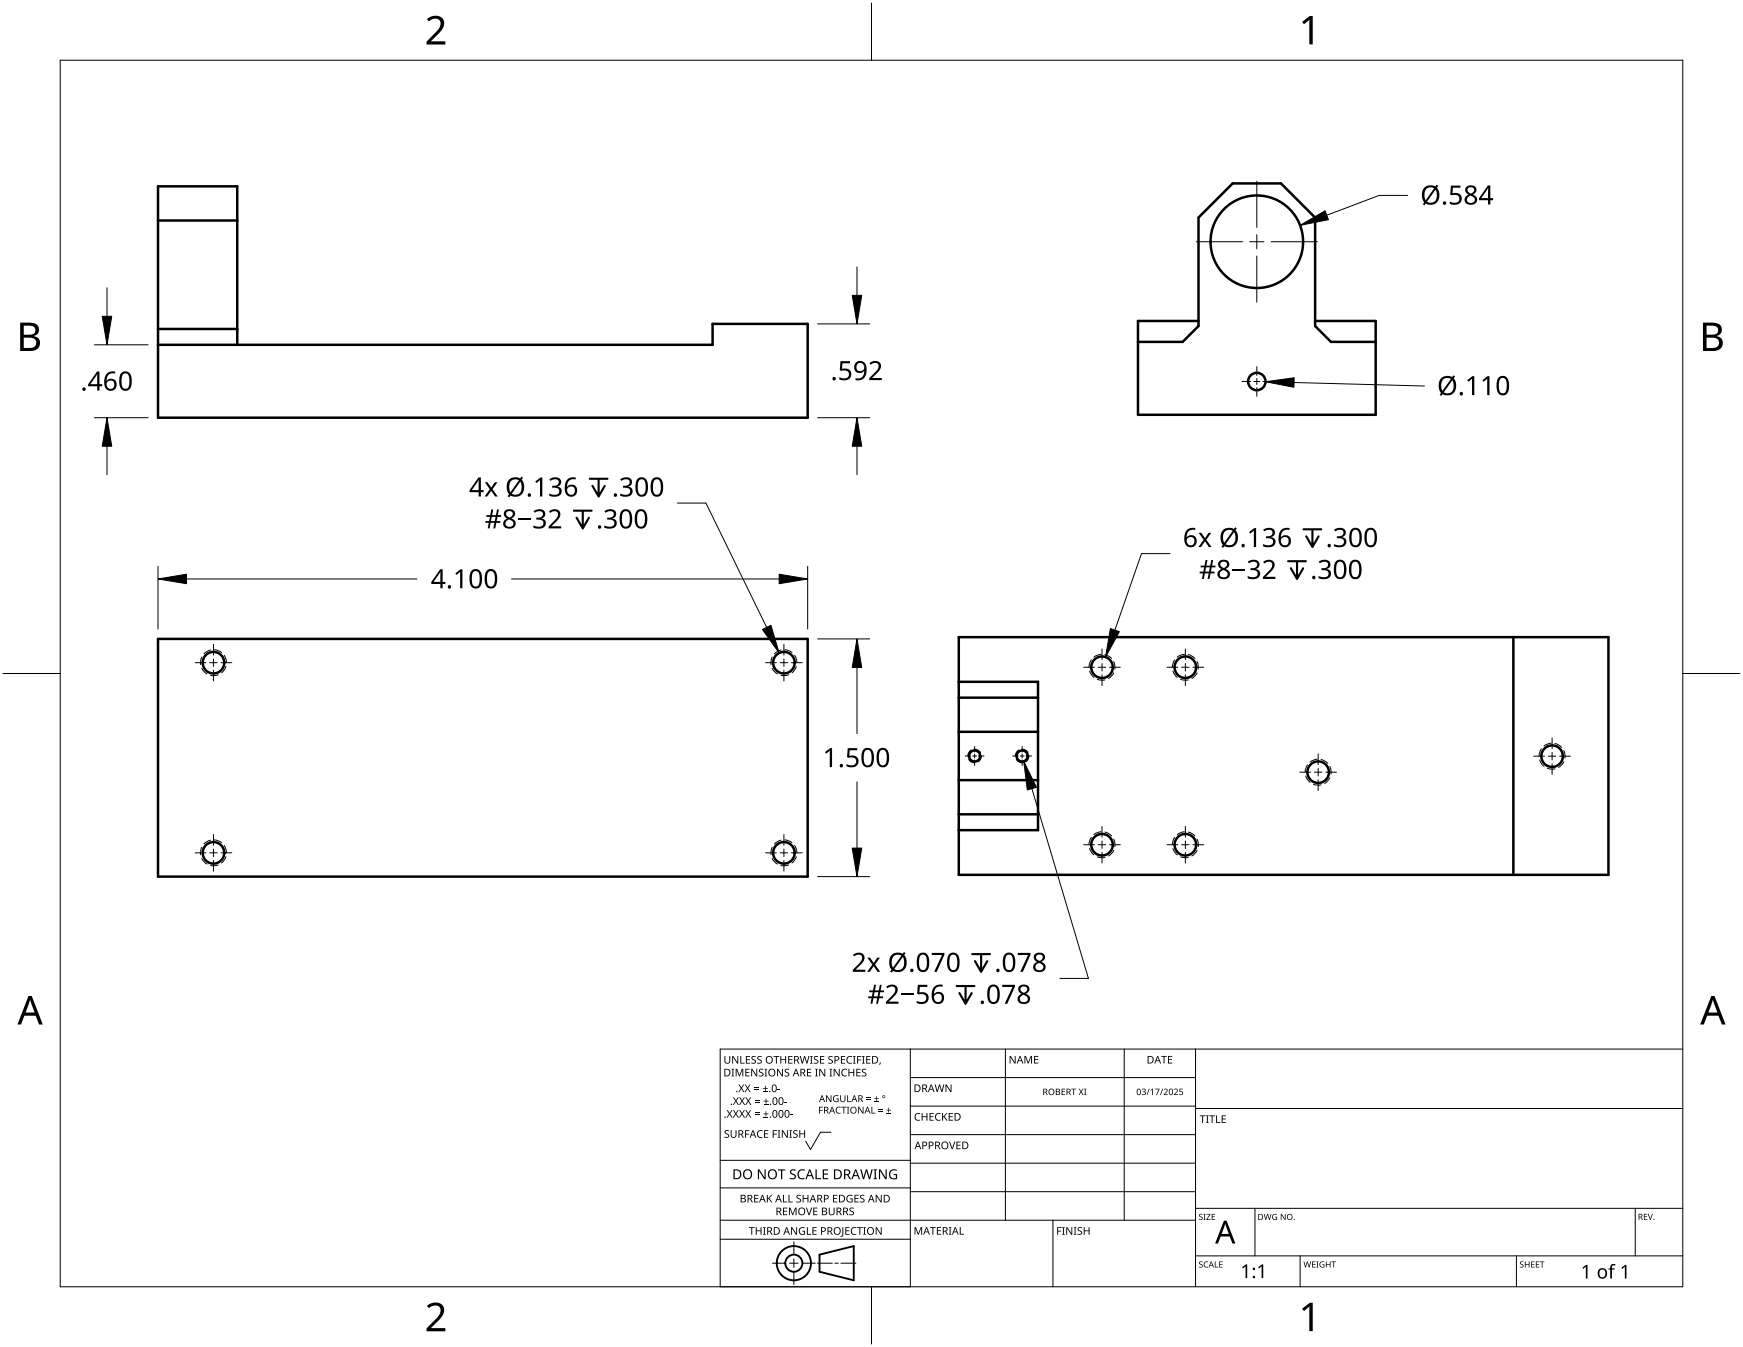
[picture p95: page 1]
