RobertXii/860nm-Cateye-ECDL/Circuits/Laser Diode Protection Circuit/Piezo Protection Circuit Diagram.pdf

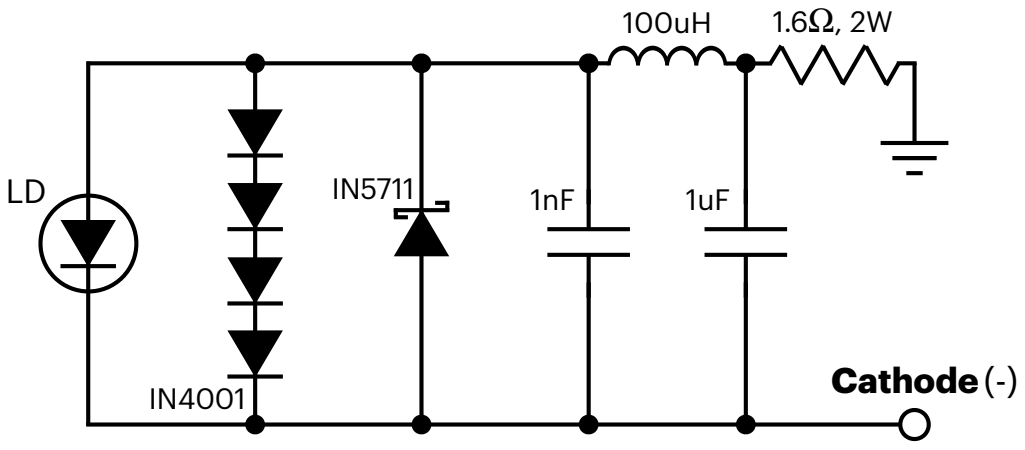
[picture p96: page 1]
Cathode(-)
