RobertXii/860nm-Cateye-ECDL/Lab Control Code/Figures/longer piezo current vs frequency 3.pdf

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

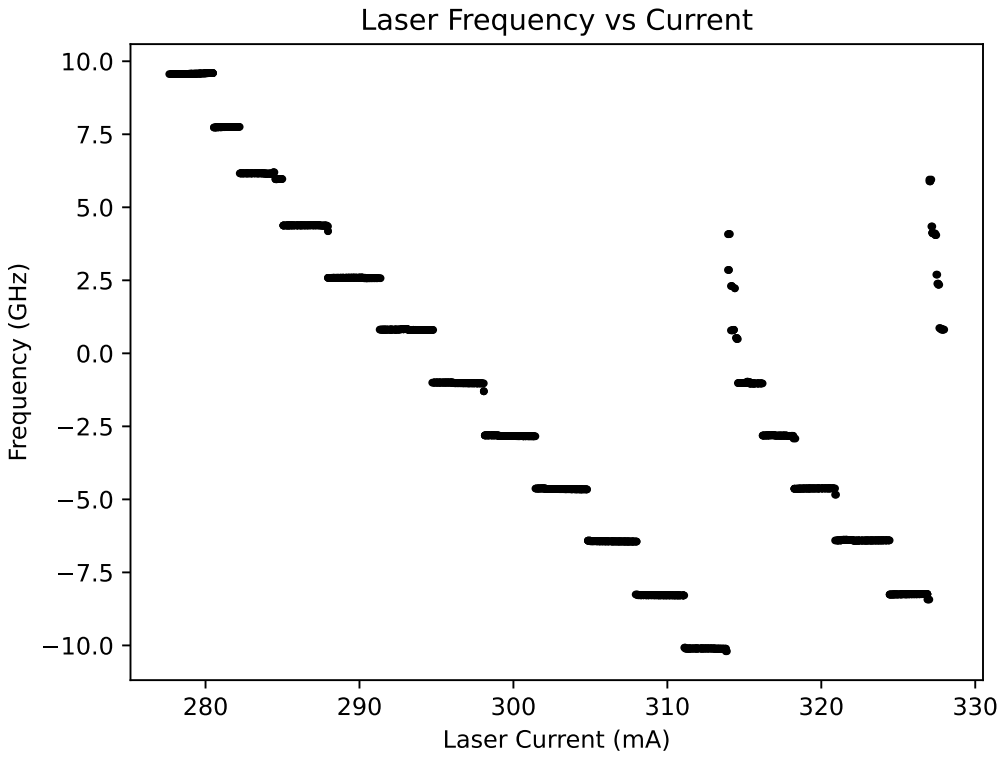
[picture p97: page 1]
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
