RobertXii/860nm-Cateye-ECDL/Lab Control Code/Figures/longer piezo voltage vs frequency 2.pdf

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

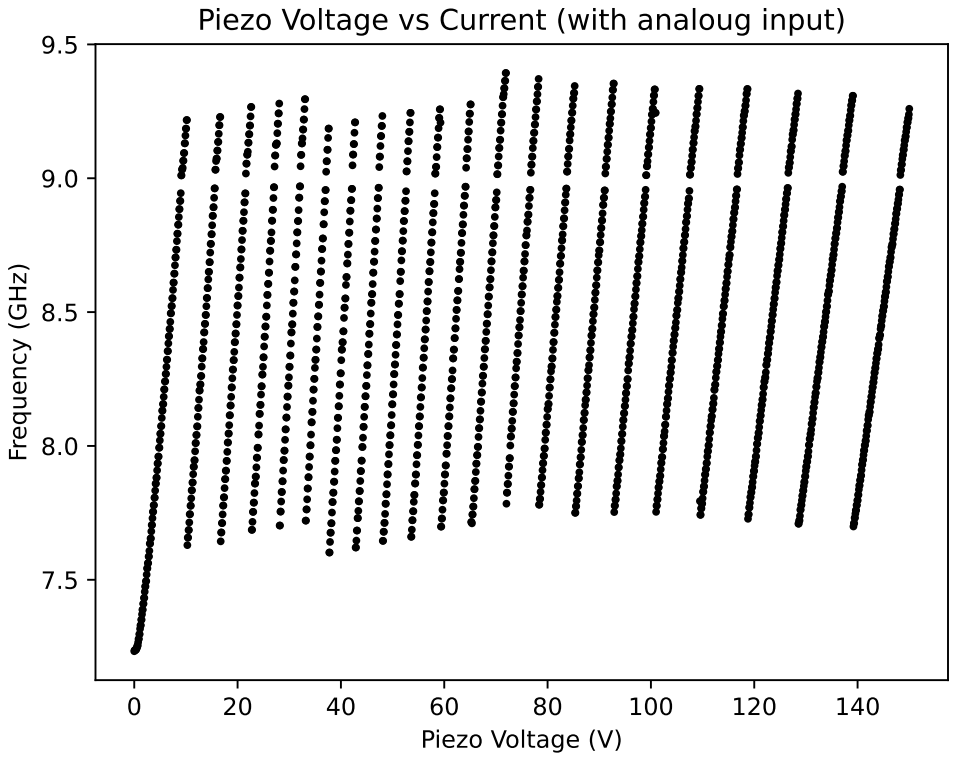
[picture p100: page 1]
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
