RobertXii/860nm-Cateye-ECDL/Lab Control Code/Figures/longer piezo voltage vs frequency.pdf

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

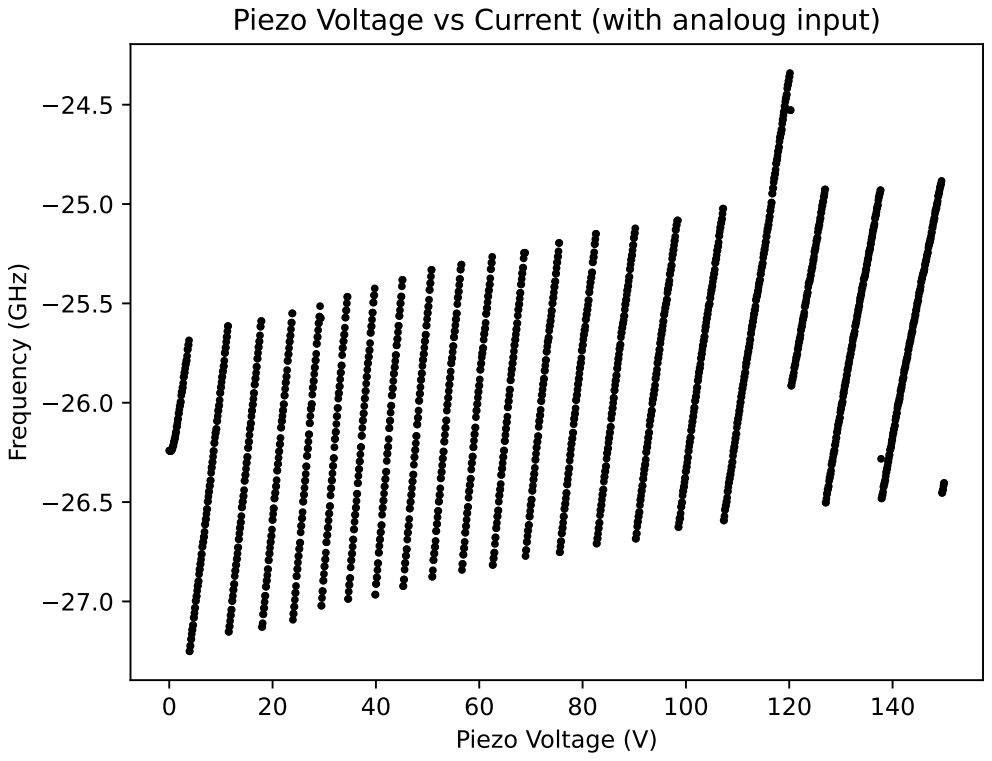
[picture p101: page 1]
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
