RobertXii/860nm-Cateye-ECDL/Lab Control Code/Figures/Piezo Voltage vs Freq with analoug feedforward.pdf

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

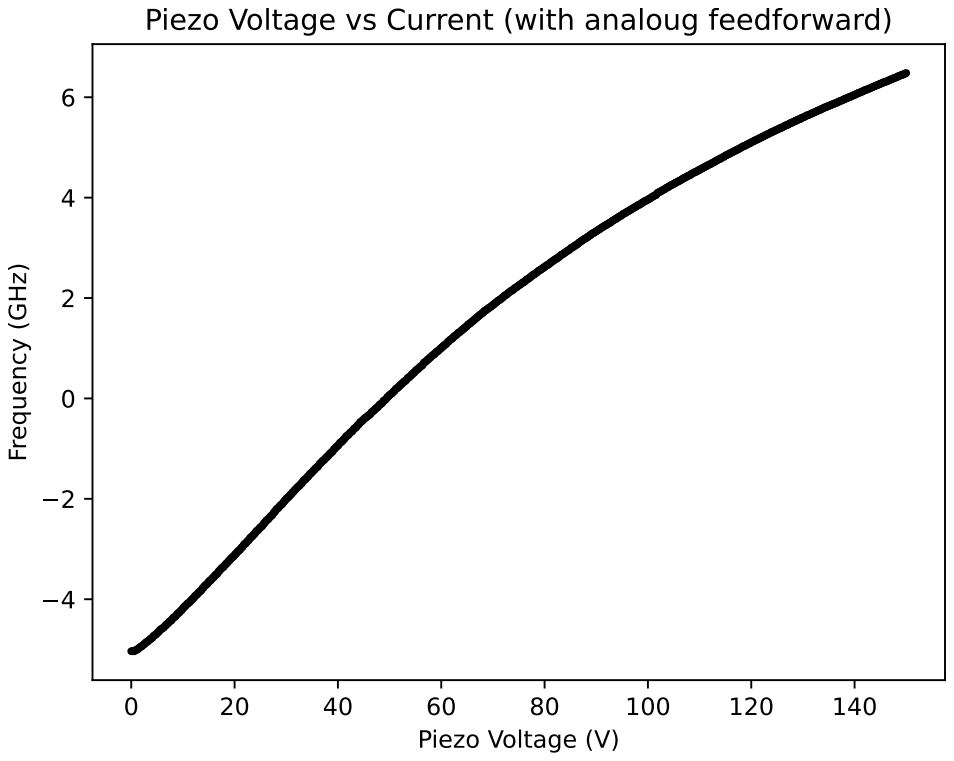
[picture p102: page 1]
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
