RobertXii/860nm-Cateye-ECDL/Circuits/Feedforward Circuit/feedforward circuitry.pdf

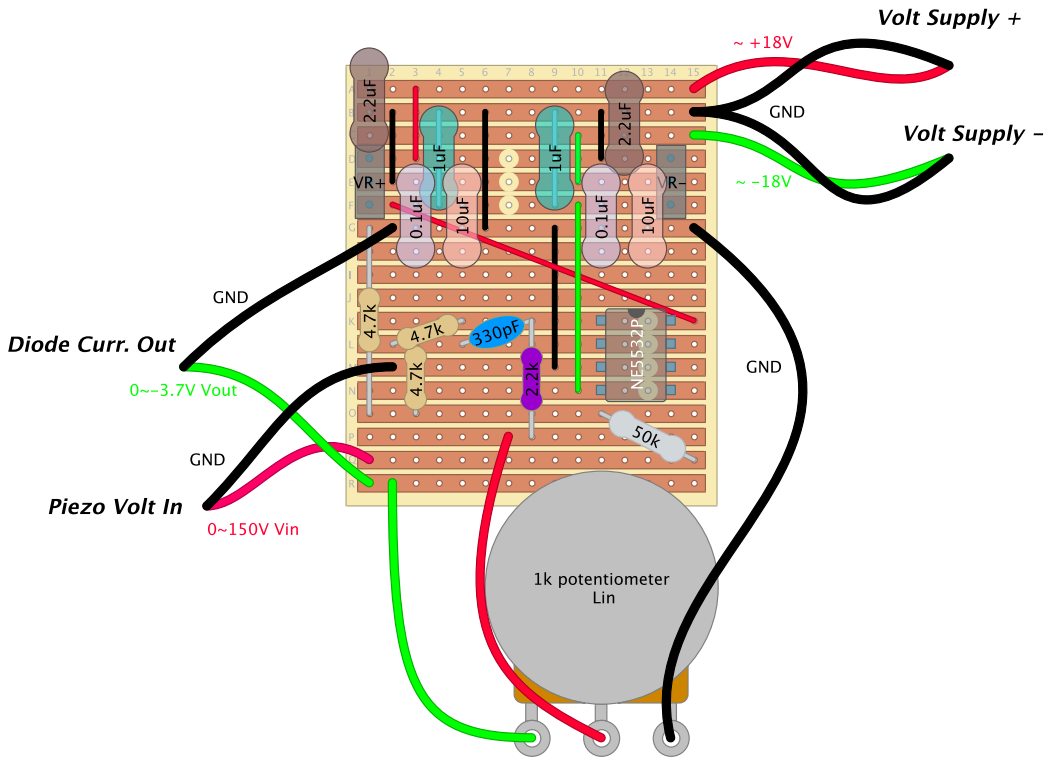
[picture p103: page 1]
