RobertXii/860nm-Cateye-ECDL/Lab Control Code/Figures/piezo voltage with feedforward vs frequency k=-23.9.pdf

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

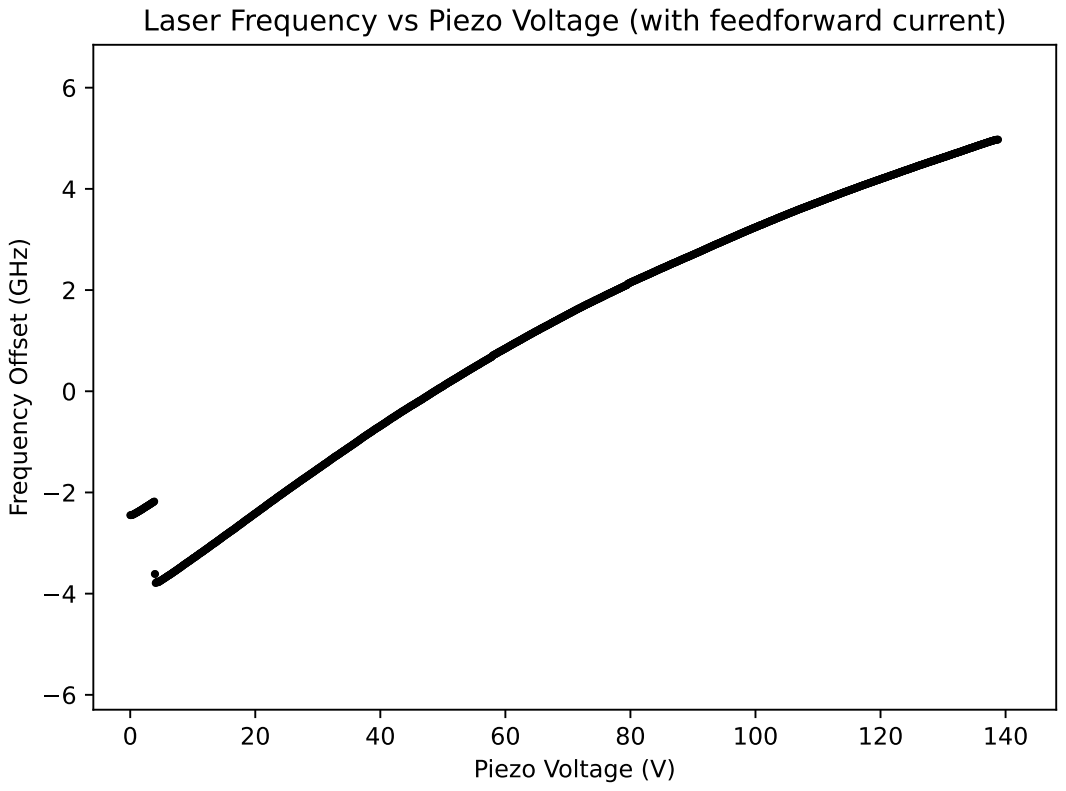
[picture p104: page 1]
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
