RobertXii/860nm-Cateye-ECDL/Lab Control Code/Figures/piezo voltage with feedforward vs frequency.pdf

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

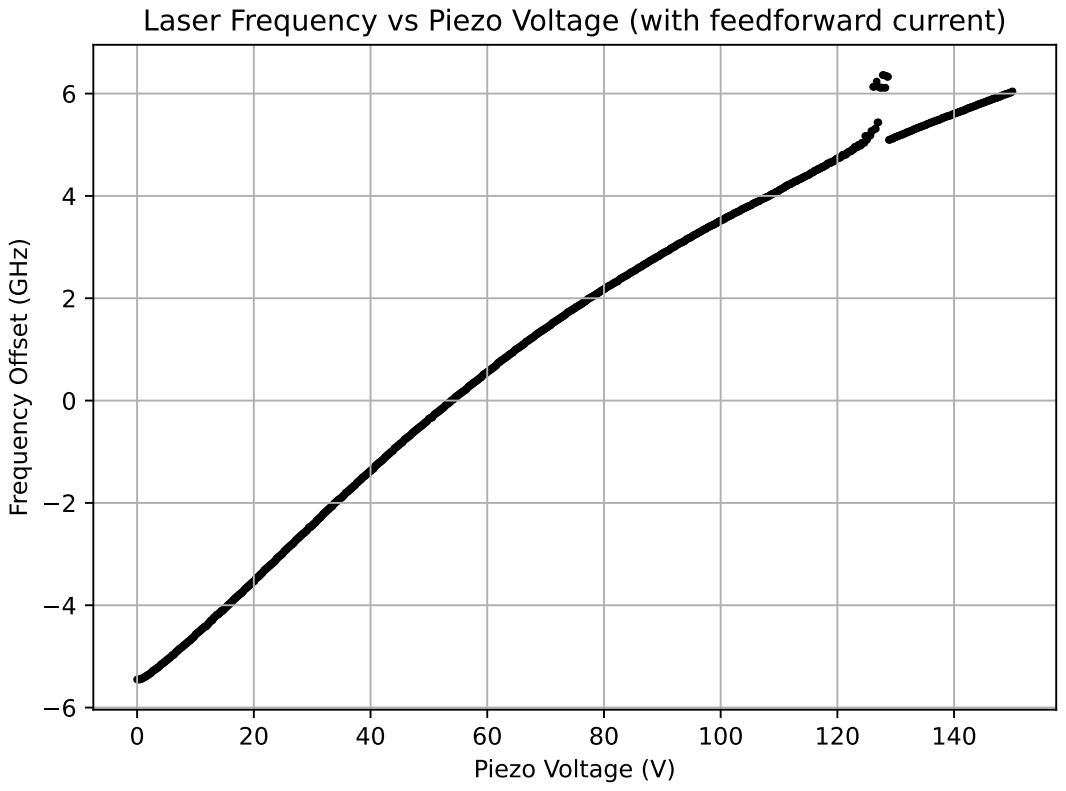
[picture p107: page 1]
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
