RobertXii/860nm-Cateye-ECDL/Lab Control Code/Figures/Feedforward Ratio Scan/longer piezo voltage with feedforward vs frequency 3 turn.pdf

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

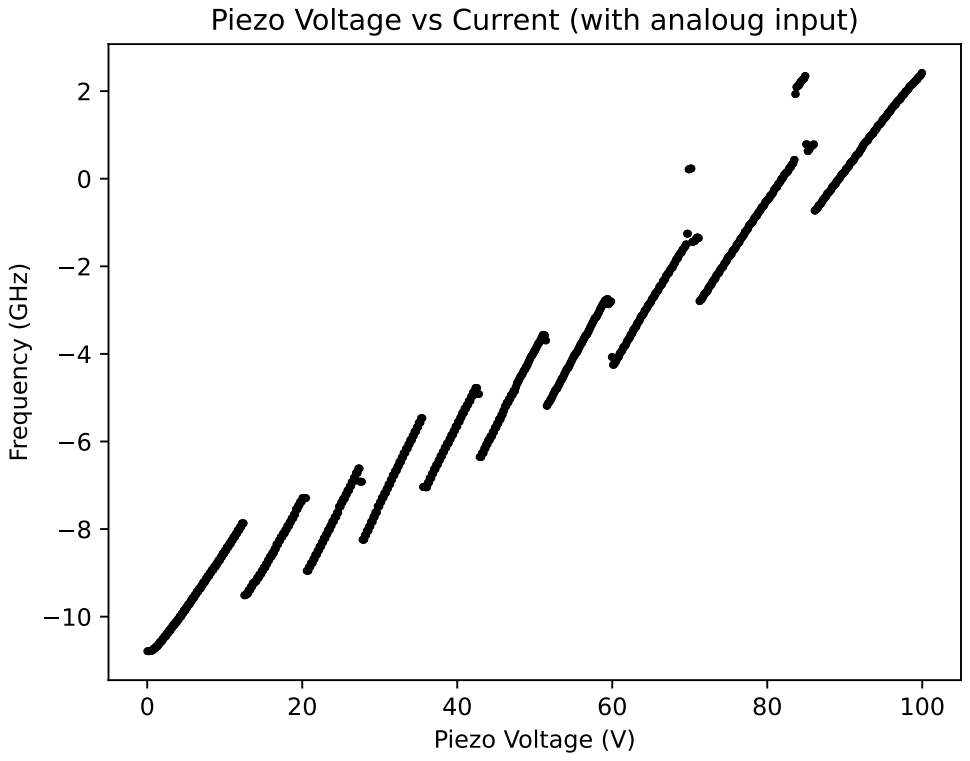
[picture p110: page 1]
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
