RobertXii/860nm-Cateye-ECDL/Lab Control Code/daq_control_Robert.py

import nidaqmx
import numpy as np
import time
import matplotlib.pyplot as plt
import threading

# ====== Configuration ======
DEVICE_NAME = "Dev1"
AO0_CHANNEL = f"{DEVICE_NAME}/ao0"
AO1_CHANNEL = f"{DEVICE_NAME}/ao1"
AI_CHANNEL = f"{DEVICE_NAME}/ai0"
mA_per_V = 50  # Conversion factor from voltage to current
V_per_V = 15 # Conversion factor from DAQ input voltage to Piezo voltage
k_feedforward = 3.8 # V/mA 15.3V/4mA = 3.825V/mA

# ====== DAQ Setup Helpers ======
def init_ao0_task(min_val=0.0, max_val=10.0):
    task = nidaqmx.Task()
    task.ao_channels.add_ao_voltage_chan(AO0_CHANNEL, min_val=min_val, max_val=max_val)
    return task

def init_ao1_task(min_val=0.0, max_val=10.0):
    task = nidaqmx.Task()
    task.ao_channels.add_ao_voltage_chan(AO1_CHANNEL, min_val=min_val, max_val=max_val)
    return task

def init_ai_task(min_val=0.0, max_val=10.0):
    task = nidaqmx.Task()
    task.ai_channels.add_ai_voltage_chan(AI_CHANNEL, min_val=min_val, max_val=max_val)
    return task


# ====== Laser Control ======
def read_laser_current():
    with init_ai_task() as task:
        voltage = task.read()
        current_mA = voltage * mA_per_V
        print(f"Read CTL OUT: {voltage:.3f} V → {current_mA:.2f} mA")


def set_ao0_voltage(voltage):
    with init_ao0_task() as task:
        task.write(voltage)
    print(f"Set voltage: {voltage:.2f} V")
    
def set_ao1_voltage(voltage):
    with init_ao1_task() as task:
        task.write(voltage)
    print(f"Set voltage: {voltage:.2f} V")

def ramp_voltage(start_v, end_v, duration, steps=100):
    voltages = np.linspace(start_v, end_v, steps)
    delay = duration / steps
    with init_ao0_task() as task:
        for v in voltages:
            task.write(v)
            time.sleep(delay)
    print("Voltage ramp complete.")

def set_laser_current(current_mA):
    voltage = current_mA / mA_per_V
    with init_ao0_task(min_val=-10.0, max_val=10.0) as task:
        task.write(voltage)
    print(f"Set laser current: {current_mA:.2f} mA")

    # ===== Feedforward piezo voltage =====
    feedforward_voltage = current_mA * k_feedforward
    set_piezo_voltage(feedforward_voltage)
    print(f"Feedforward piezo voltage: {feedforward_voltage:.2f} V")

def set_piezo_voltage(voltage_V):
    voltage = voltage_V / V_per_V
    with init_ao1_task() as task:
        task.write(voltage)
    print(f"Set piezo voltage: {voltage_V:.1f} V")


def ramp_laser_current(start_mA, end_mA, duration, steps=1000):
    voltages = np.linspace(start_mA / mA_per_V, end_mA / mA_per_V, steps)
    delay = duration / steps
    with init_ao0_task(min_val=-10.0, max_val=10.0) as task:
        for v in voltages:
            task.write(v)
            time.sleep(delay)
    print("Diode current ramp complete.")

def ramp_piezo_voltage(start_V, end_V, duration, steps=1000):
    voltages = np.linspace(start_V / V_per_V, end_V / V_per_V, steps)
    delay = duration / steps
    with init_ao1_task() as task:
        for v in voltages:
            task.write(v)
            time.sleep(delay)
    print("Piezo voltage ramp complete.")


def start_ramp_thread(start_mA, end_mA, duration):
    thread = threading.Thread(target=ramp_laser_current, args=(start_mA, end_mA, duration))
    thread.start()
    return thread

# ====== Real-time time vs. current  ======
def log_and_plot_current(duration):
    times = []
    currents = []

    plt.ion()
    fig, ax = plt.subplots()
    line, = ax.plot([], [], '-o')
    ax.set_xlabel("Time (s)")
    ax.set_ylabel("Laser Current (mA)")
    ax.set_title("Real-Time Laser Current")
    ax.grid(True)

    start_time = time.time()

    with init_ai_task() as task:
        while True:
            now = time.time() - start_time
            voltage = task.read()
            current = voltage * mA_per_V

            times.append(now)
            currents.append(current)

            line.set_data(times, currents)
            ax.set_xlim(0, max(duration, now))
            ax.set_ylim(0, max(350, current + 10))
            plt.pause(0.01)

            if now >= duration:
                break

    plt.ioff()
    plt.show()


# ====== Example Usage ======
if __name__ == "__main__":
    set_piezo_voltage(0)
    # ramp_piezo_voltage(10, 60, 50)
    # ramp_thread = start_ramp_thread(0, 30, 30)
    # log_and_plot_current(30)
    set_laser_current(0)
    read_laser_current()
