RobertXii/860nm-Cateye-ECDL/Lab Control Code/test_GPIB_connection.py

import pyvisa
import time

rm = pyvisa.ResourceManager()
wavemeter = rm.open_resource('GPIB0::20::INSTR')
wavemeter.timeout = 5000  # 5 seconds timeout

print("IDN:", wavemeter.query('*IDN?'))
print("POW:", wavemeter.query('FETCH:POW?'))



# print(wavemeter.query('MEAS:POW?'))  # Measure power
