RobertXii/860nm-Cateye-ECDL/(commit log)

2025-04-16 organized manual and data sheet folder
    [9973 - Utah State 866-1.2 OD6 Ultra Narrow BP.xls, Edmund Filter Raw Data.xlsx, QPhotonics Diode Raw Data.xls]
2025-04-18 circuit designs
2025-04-19 update circuit
2025-05-07 update design ECDL
    [Al Base Drawing.dxf, Aluminum Base.step, Brass Base.step]
2025-05-13 Create Screenshot 2025-05-12 at 11.25.43 PM.png
2025-05-19 new diagram circuit
2025-10-14 circuit for fast control
