RobertXii/860nm-Cateye-ECDL/Data Sheets & Manual/New Qphotonics data sheet.jpeg

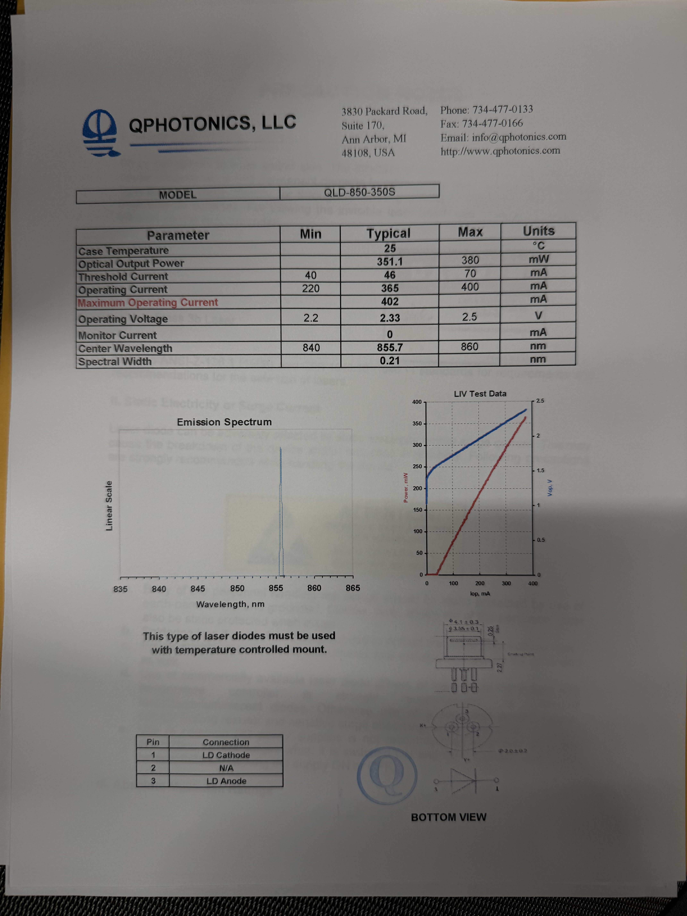
Data Sheets & Manual/New Qphotonics data sheet.jpeg
